vuminhquan28/FloodGuard/report/main.tex

\documentclass[12pt,a4paper]{report}

% --- Gói ngôn ngữ và mã hóa tiếng Việt ---
\usepackage[utf8]{inputenc}
\usepackage[vietnamese]{babel}
\usepackage[T5]{fontenc}

% --- Canh lề và định dạng trang ---
\usepackage[top=2.5cm, bottom=2.5cm, left=3cm, right=2cm]{geometry}
\usepackage{fancyhdr}
\setlength{\headheight}{15pt}
\usepackage{titlesec}

% --- Bảng, hình ảnh, toán học và ký hiệu ---
\usepackage{amsmath, amssymb}
\usepackage{graphicx}
\usepackage{booktabs}
\usepackage{tabularx}
\usepackage{longtable}
\usepackage{float}
\usepackage{caption}
\usepackage{subcaption}

% --- Định dạng code mã nguồn ---
\usepackage{listings}
\usepackage{xcolor}

\definecolor{codegreen}{rgb}{0.13,0.55,0.13}
\definecolor{codegray}{rgb}{0.5,0.5,0.5}
\definecolor{codepurple}{rgb}{0.58,0,0.82}
\definecolor{backcolour}{rgb}{0.96,0.97,0.98}

\lstdefinestyle{mystyle}{
    backgroundcolor=\color{backcolour},   
    commentstyle=\color{codegreen},
    keywordstyle=\color{blue}\bfseries,
    numberstyle=\tiny\color{codegray},
    stringstyle=\color{codepurple},
    basicstyle=\ttfamily\footnotesize,
    breakatwhitespace=false,         
    breaklines=true,                 
    captionpos=b,                    
    keepspaces=true,                 
    numbers=left,                    
    numbersep=5pt,                  
    showspaces=false,                
    showstringspaces=false,
    showtabs=false,                  
    tabsize=2
}
\lstset{style=mystyle}

% --- Liên kết và màu sắc tài liệu ---
\usepackage{hyperref}
\hypersetup{
    colorlinks=true,
    linkcolor=blue!70!black,
    filecolor=magenta,      
    urlcolor=cyan!70!black,
    citecolor=green!50!black,
    plainpages=false,
    pdfpagelabels=true,
    pdftitle={Báo cáo dự án IoT: FloodGuard - Hệ thống chống ngập tự động},
    pdfauthor={Vũ Minh Quân, Nguyễn Đức Huy, Phạm Đức Mạnh},
}

% --- Header và Footer ---
\pagestyle{fancy}
\fancyhf{}
\fancyhead[L]{\small\slshape FloodGuard - Hệ Thống Chống Ngập Tự Động}
\fancyhead[R]{\small\slshape ESP32 IoT Project}
\fancyfoot[C]{\thepage}
\renewcommand{\headrulewidth}{0.4pt}
\renewcommand{\footrulewidth}{0.4pt}

% ==================== BẮT ĐẦU TÀI LIỆU ====================
\begin{document}

\pagenumbering{alph}

% --- TRANG BÌA ---
% Khung viền đôi trang bìa chuẩn luận văn: Khung đậm dày ở ngoài và khung mỏng nhỏ hơn ở trong
\AddToHookNext{shipout/background}{%
    % Khung ngoài: Nét đậm dày (2.8pt)
    % Tọa độ chuẩn: Trái 25mm, Phải 15mm (Rộng 170mm), Trên 16mm, Dưới 16mm (Cao 265mm)
    \put(70.87,-48.15){\rule{481.89pt}{2.8pt}}% Cạnh trên ngoài
    \put(70.87,-796.54){\rule{481.89pt}{2.8pt}}% Cạnh dưới ngoài
    \put(70.87,-796.54){\rule{2.8pt}{751.18pt}}% Cạnh trái ngoài
    \put(549.96,-796.54){\rule{2.8pt}{751.18pt}}% Cạnh phải ngoài
    %
    % Khung trong: Nét thanh mỏng (0.9pt), lùi vào trong 2.5mm so với khung ngoài
    % Trái 27.5mm (Rộng 165mm), Trên 18.5mm (Cao 260mm)
    \put(77.95,-53.34){\rule{467.72pt}{0.9pt}}% Cạnh trên trong
    \put(77.95,-789.45){\rule{467.72pt}{0.9pt}}% Cạnh dưới trong
    \put(77.95,-789.45){\rule{0.9pt}{737.01pt}}% Cạnh trái trong
    \put(544.77,-789.45){\rule{0.9pt}{737.01pt}}% Cạnh phải trong
}
\begin{titlepage}
    \centering
    \vspace*{0.3cm}
    
    {\fontsize{15pt}{19pt}\selectfont\textbf{ĐẠI HỌC QUỐC GIA HÀ NỘI}\par}
    \vspace{0.15cm}
    {\fontsize{16pt}{20pt}\selectfont\textbf{TRƯỜNG ĐẠI HỌC CÔNG NGHỆ}\par}
    \vspace{0.4cm}
    \hrule height 1.5pt
    \vspace{0.8cm}
    
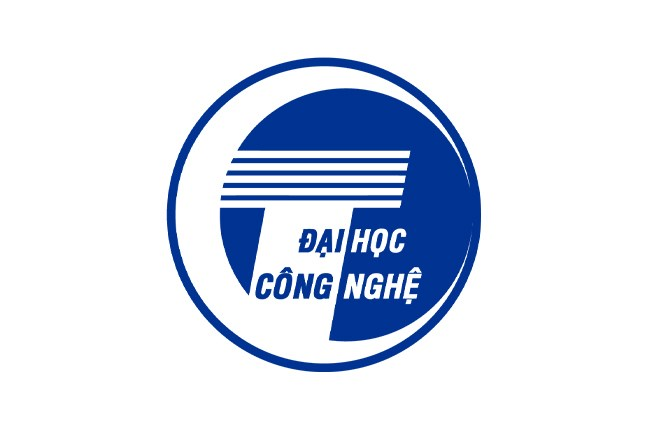
[picture p12: report/figures/logo-uet.jpg]
    \par
    \vspace{0.9cm}
    
    {\Large\textbf{BÁO CÁO BÀI TẬP LỚN}\par}
    \vspace{0.2cm}
    {\large\textbf{MÔN: LẬP TRÌNH NHÚNG VÀ THỜI GIAN THỰC}\par}
    \vspace{0.8cm}
    
    {\textbf{ĐỀ TÀI:}\par}
    \vspace{0.2cm}
    {\fontsize{13pt}{17pt}\selectfont\bfseries FLOODGUARD: HỆ THỐNG GIÁM SÁT VÀ CHỐNG NGẬP TỰ ĐỘNG THÔNG MINH\par}
    \vspace{0.3cm}
    {\small\slshape Ứng dụng Vi điều khiển ESP32, Thuật toán FSM \& Web Dashboard Thời Gian Thực\par}
    
    \vspace{1.4cm}
    
    \begin{minipage}{0.92\textwidth}
        \normalsize
        \renewcommand{\arraystretch}{1.35}
        \begin{tabular}{@{}ll@{}}
            \textbf{Học phần:}            & Lập trình nhúng và thời gian thực \\
            \textbf{Mã học phần:}         & 2627I\_INT3108\_1 \\
            \textbf{Sinh viên thực hiện:} & Vũ Minh Quân (23020142) \\
                                          & Nguyễn Đức Huy (24020161) \\
                                          & Phạm Đức Mạnh (24020222) \\
            \textbf{Học kỳ / Năm học:}    & Học kỳ 1 -- 2026-2027 \\
        \end{tabular}
    \end{minipage}
    
    \vfill
    {\large Hà Nội, Tháng 10 Năm 2026}\par
    \vspace*{0.3cm}
\end{titlepage}

% --- BẢNG PHÂN CHIA CÔNG VIỆC ---
\newpage
\pagenumbering{roman}
\setcounter{page}{1}
\addcontentsline{toc}{chapter}{Bảng Phân Chia Công Việc \& Tỷ Lệ Đóng Góp}

\begin{center}
    \vspace*{0.5cm}
    {\fontsize{14pt}{18pt}\selectfont\bfseries BẢNG PHÂN CHIA CÔNG VIỆC VÀ TỶ LỆ ĐÓNG GÓP}\par
    \vspace{0.8cm}
\end{center}

\noindent
Dự án \textbf{FloodGuard: Hệ thống giám sát và chống ngập tự động thông minh} được nghiên cứu và phát triển bởi nhóm gồm 03 sinh viên. Khối lượng công việc bao gồm thiết kế kiến trúc phần cứng, sơ đồ nguyên lý mạch điện, lập trình firmware vi điều khiển ESP32, xây dựng thuật toán điều khiển FSM, thiết kế giao diện Web Dashboard và biên soạn báo cáo kỹ thuật được phân chia đồng đều và bình đẳng giữa các thành viên:

\vspace{0.6cm}

\begin{center}
\renewcommand{\arraystretch}{1.5}
\begin{tabular}{|c|l|c|}
\hline
\textbf{STT} & \textbf{Tên sinh viên} & \textbf{Tỷ lệ đóng góp / Hoàn thành} \\ \hline
1 & Vũ Minh Quân (23020142) & 100\% \\ \hline
2 & Nguyễn Đức Huy (24020161) & 100\% \\ \hline
3 & Phạm Đức Mạnh (24020222) & 100\% \\ \hline
\multicolumn{2}{|c|}{\textbf{Đánh giá chung}} & \textbf{100\%} \\ \hline
\end{tabular}
\end{center}

\vspace{0.6cm}
\noindent
\textbf{Cam kết trách nhiệm:} Tất cả 03 thành viên trong nhóm đều tham gia chủ động, đóng góp bình đẳng và phối hợp chặt chẽ trong tất cả các giai đoạn triển khai đề tài, đảm bảo hoàn thành $100\%$ khối lượng công việc được giao với chất lượng cao nhất.

\vspace{1.8cm}
\begin{flushright}
    \textit{Hà Nội, ngày 25 tháng 10 năm 2026}\\[0.3cm]
    \textbf{Đại diện nhóm sinh viên thực hiện}\\[2.5cm]
    \textit{(Ký và ghi rõ họ tên)}\hspace{1.5cm}
\end{flushright}

\newpage

% --- MỤC LỤC ---
\tableofcontents
\newpage
\listoffigures
\listoftables
\newpage

% --- NỘI DUNG CHÍNH ---
\pagenumbering{arabic}

\input{chapters/01_introduction.tex}
\input{chapters/02_hardware_architecture.tex}
\input{chapters/03_algorithm_control.tex}
\input{chapters/04_web_dashboard.tex}
\input{chapters/05_deployment_guide.tex}
\input{chapters/06_conclusion.tex}

\end{document}
