vuminhquan28/FloodGuard/report/chapters/01_introduction.tex

\chapter{Giới Thiệu Đề Tài \& Phân Tích Yêu Cầu}
\label{ch:introduction}

\section{Đặt Vấn Đề \& Khảo Sát Hiện Trạng}

\subsection{Bối Cảnh Thực Tiễn Về Ngập Úng Đô Thị}
Hiện tượng ngập úng đô thị cục bộ vào mùa mưa bão đang là một trong những thách thức dân sinh và hạ tầng nghiêm trọng nhất tại các đô thị lớn ở Việt Nam, điển hình như Hà Nội và TP. Hồ Chí Minh. Các điểm trũng thấp như hầm chui dân sinh (hầm chui Đại lộ Thăng Long, Nguyễn Trãi), tầng hầm các tòa nhà chung cư, trung tâm thương mại và các tuyến phố trũng thấp thường xuyên bị ngập sâu từ $0.5\,\text{m}$ đến hơn $1.2\,\text{m}$ chỉ sau những trận mưa rào kéo dài $30 - 45\,\text{phút}$. Tình trạng này gây thiệt hại nặng nề về phương tiện giao thông, làm tê liệt hạ tầng đô thị, gây chập cháy thiết bị điện tử ngầm và tiềm ẩn nguy cơ đe dọa trực tiếp tính mạng con người.

\subsection{Khảo Sát \& Đánh Giá Các Giải Pháp Hiện Nay}
Để ứng phó với ngập úng đô thị, các giải pháp giám sát và tiêu thoát nước hiện nay chủ yếu bao gồm:
\begin{itemize}
    \item \textbf{Cơ chế phao cơ truyền thống:} Sử dụng phao quả nổi đóng ngắt tiếp điểm điện cơ khí. Giải pháp này có ưu điểm chi phí thấp, tuy nhiên chỉ cung cấp thông tin nhị phân (ngập / cạn), không đo lường được tốc độ dâng nước, rất dễ kẹt rác cơ học và hoàn toàn không có khả năng giám sát hay cảnh báo sớm từ xa.
    \item \textbf{Hệ thống SCADA / PLC công nghiệp:} Sử dụng các bộ điều khiển logic khả trình (PLC) kết hợp cảm biến radar công nghiệp và mạng truyền thông cáp quang. Mặc dù có độ tin cậy và độ bền công nghiệp rất cao, giải pháp này có chi phí đầu tư phần cứng và bản quyền phần mềm cực kỳ đắt đỏ (lên tới hàng trăm triệu đồng cho một điểm đo), kích thước cồng kềnh, tiêu thụ nhiều năng lượng và khó có thể phủ kín diện rộng tại hàng trăm điểm ngập nhỏ lẻ trong đô thị.
    \item \textbf{Hệ thống IoT nhúng dựa trên vi điều khiển:} Đây là hướng tiếp cận hiện đại và tối ưu về mặt kinh tế kỹ thuật. Bằng việc ứng dụng các vi điều khiển thế hệ mới như ESP32 tích hợp sẵn kết nối không dây, hệ thống có thể thu nhỏ kích thước, tiết kiệm năng lượng, đo đạc thông số liên tục theo thời gian thực và cung cấp giao diện giám sát tiện lợi với chi phí phần cứng rất thấp.
\end{itemize}

\subsection{Phạm Vi \& Quy Mô Nghiên Cứu Của Đề Tài}
Trong khuôn khổ học phần \textit{Lập trình nhúng và thời gian thực}, đề tài tập trung nghiên cứu, thiết kế và chế tạo một \textbf{mô hình thực nghiệm quy mô trạm quan trắc (Proof of Concept / Scale Model)} mang tên \textbf{FloodGuard}. Mô hình mô phỏng khép kín toàn bộ chu trình vận hành của một trạm bơm tiêu thoát lũ thông minh: từ khâu đo đạc mực nước và lượng mưa, tiền xử lý tín hiệu số, thuật toán điều khiển máy trạng thái hữu hạn (FSM) kết hợp dải trễ, điều khiển cơ cấu chấp hành (bơm, van), cảnh báo đa giác quan tại trạm (LED, còi), đến giao diện giám sát và can thiệp điều khiển qua mạng không dây cục bộ.

\section{Mục Tiêu Kỹ Thuật Định Lượng Của Dự Án}
\label{sec:quantitative_goals}
Hệ thống \textbf{FloodGuard} hướng tới các chỉ tiêu kỹ thuật định lượng cụ thể:
\begin{enumerate}
    \item \textbf{Độ chính xác đo lường mực nước:} Sai số tuyệt đối đo khoảng cách qua cảm biến siêu âm $\le \pm 1.0\,\text{cm}$ trong dải đo làm việc thiết kế ($5 - 50\,\text{cm}$ trên cấu hình mô phỏng/bể chuẩn và $6 - 16\,\text{cm}$ trên mô hình demo mica thu nhỏ); độ phân giải hiển thị mức nước $1\%$ ($0\% - 100\%$).
    \item \textbf{Độ phân giải giám sát lượng mưa:} Thu nhận tín hiệu tương tự (ADC) 12-bit phân giải $\approx 0.8\,\text{mV}$ trên dải $0 - 3.3\,\text{V}$, phân loại 4 vùng trạng thái thời tiết qua 3 mốc ngưỡng ($3200 / 1800 / 1100$): Khô ráo, Mưa nhỏ, Mưa to và Ngập cảm biến.
    \item \textbf{Tính thời gian thực của thuật toán điều khiển (Worst-Case Reaction Time - WCRT):} Thời gian phản ứng tức thời từ lúc mực nước vượt ngưỡng nguy cấp đến khi chân GPIO xuất tín hiệu đóng Relay máy bơm khẩn cấp ($T_{\text{WCRT\_urgent}}$) không vượt quá $250\,\text{ms}$ (tính toán danh định đạt $203\,\text{ms}$ ở chu kỳ trích mẫu $T_{\text{sample}} = 150\,\text{ms}$). Với các chuyển trạng thái bậc thang thông thường có áp dụng bộ lọc chống rung thời gian $T_{\text{debounce}} = 1.0\,\text{s}$, thời gian ổn định là $T_{\text{stable}} \approx 1.2\,\text{s}$.
    \item \textbf{Chống rung giật cơ cấu chấp hành (Hysteresis \& Debounce Guard):} Áp dụng dải trễ Hysteresis biên độ $3\%$ mực nước ($41\%/38\%$, $71\%/68\%$, $21\%/18\%$) kết hợp bộ lọc chống rung thời gian Debounce $1.0\,\text{s}$ và thời gian chạy tối thiểu của máy bơm $5.0\,\text{s}$ (Min-run Time), đảm bảo triệt tiêu hoàn toàn hiện tượng đóng/ngắt Relay liên tục (chattering) do sóng nước dập dềnh quanh biên ngưỡng.
    \item \textbf{Cảnh báo trực quan \& âm thanh đa cấp độ:} Cụm 3 đèn LED phản ánh trực tiếp 4 trạng thái vận hành; còi Active Buzzer $5\,\text{V}$ phát xung âm thanh theo cơ chế phi chặn (\textit{Non-blocking}) qua hàm \texttt{millis()} ở tần số cộng hưởng nội $\approx 2.3\,\text{kHz}$ với 4 nhịp cảnh báo: Tắt (NORMAL) $\to$ Bíp thưa chu kỳ $1500\,\text{ms}$ (WARNING) $\to$ Bíp dồn dập chu kỳ $400\,\text{ms}$ (DANGER) $\to$ Hú liên tục (CRITICAL).
    \item \textbf{Hiệu năng giao tiếp mạng Web Dashboard:} Chu kỳ cập nhật dữ liệu telemetry thời gian thực $1000\,\text{ms}$ ($1\,\text{s}$), độ trễ phản hồi API cục bộ $8 - 18\,\text{ms}$, tỷ lệ phục vụ thành công các yêu cầu API đạt $\ge 99.5\%$ trên mạng Wi-Fi cục bộ ở cự ly $10\,\text{m}$.
    \item \textbf{Cơ chế bảo vệ an toàn tự trị (Failsafe Timeout):} Khi ở chế độ thủ công (\texttt{MANUAL}), nếu mất kết nối điều khiển mạng quá $30\,\text{s}$, trạm tự động thu hồi quyền thủ công và chuyển về chế độ tự động (\texttt{AUTO}) để bảo vệ công trình chống tràn bể; đồng thời kích hoạt quy tắc ghi đè an toàn tối cao (\textit{Safety Override}) nếu nước đạt mức CRITICAL quá $10\,\text{s}$.
\end{enumerate}

\section{Mô Hình Hóa Use Case Hệ Thống Theo UML}

\subsection{Phân Định Ranh Giới Hệ Thống \& Danh Sách Tác Nhân}
Mô hình hóa Use Case cho hệ thống FloodGuard được phân định rõ ràng giữa ranh giới phần mềm/phần cứng hệ thống và các tác nhân tương tác từ môi trường bên ngoài:
\begin{itemize}
    \item \textbf{Ranh giới hệ thống (\textit{System Boundary}):} Mang tên \textbf{Hệ Thống Trạm FloodGuard} (\textit{FloodGuard System}). Ranh giới bao trọn toàn bộ khối phần mềm nhúng thực thi trên vi điều khiển ESP32 bao gồm: tác vụ thu thập cảm biến, thuật toán FSM, tác vụ tạo xung cảnh báo, máy chủ HTTP Web Server và cơ chế giám sát an toàn Failsafe. Các thành phần logic nội bộ (như bộ điều phối FSM hay Web Server) nằm hoàn toàn trong ranh giới và không đóng vai trò là tác nhân.
    \item \textbf{Tác nhân chính (\textit{Primary Actors}):}
    \begin{enumerate}
        \item \textbf{Bộ Định Thời Timer / Watchdog (\textit{Internal Timer}):} Đóng vai trò là nguồn kích hoạt sự kiện thời gian thực định kỳ từ bên ngoài luồng logic chính, bao gồm bộ định thời chu kỳ đọc cảm biến $150\,\text{ms}$, bộ định thời chu kỳ thực thi FSM, và bộ đếm thời gian giám sát mất kết nối Failsafe ($30\,\text{s}$).
        \item \textbf{Người Vận Hành (\textit{Human Operator}):} Nhân sự giám sát và vận hành tương tác trực tiếp với trạm từ thiết bị đầu cuối (điện thoại, máy tính) thông qua trình duyệt Web.
    \end{enumerate}
    \item \textbf{Tác nhân phụ / Thiết bị ngoại vi (\textit{Secondary Actors / Devices}):}
    \begin{enumerate}
        \item \textbf{\texttt{«device»} Cảm biến siêu âm HC-SR04 \& Cảm biến mưa FC-37:} Thiết bị đầu vào cung cấp tín hiệu xung thời gian phản hồi (Echo) và điện áp tương tự (AO) / mức logic (DO).
        \item \textbf{\texttt{«device»} Module Relay 5V \& Máy bơm mini:} Cơ cấu chấp hành động lực tiếp nhận tín hiệu kích mức logic để đóng/ngắt nguồn động cơ bơm.
        \item \textbf{\texttt{«device»} Động cơ Servo SG90:} Cơ cấu chấp hành cơ khí tiếp nhận tín hiệu điều chế độ rộng xung (PWM) để định vị góc mở cửa van xả lũ ($0^\circ, 90^\circ, 180^\circ$).
        \item \textbf{\texttt{«device»} Cụm 3 Đèn LED \& Còi Buzzer 5V:} Thiết bị chỉ thị tại chỗ tiếp nhận tín hiệu logic và xung nhịp cảnh báo.
        \item \textbf{Người Dân Quanh Trạm (\textit{Human Actor}):} Tác nhân thụ hưởng tiếp nhận tín hiệu âm thanh còi hú và ánh sáng đèn LED cảnh báo nguy hiểm tại thực địa trạm.
    \end{enumerate}
\end{itemize}

\subsection{Sơ Đồ Use Case Tổng Thể Hệ Thống \& Đặc Tả Kiến Trúc Mô Hình}
\label{sec:uc_overall}
Mô hình Use Case tổng thể của trạm FloodGuard được tổ chức khoa học nhằm phân định rõ ràng giữa ranh giới hệ thống phần mềm nhúng và môi trường tương tác bên ngoài. Sơ đồ phân tách thành hai phân hệ chức năng độc lập về mặt logic nhưng phối hợp đồng bộ thông qua bộ nhớ trạng thái chung (Hình~\ref{fig:uc_overall}):
\begin{enumerate}
    \item \textbf{Phân hệ Giám sát \& Điều khiển Tự động Tại Chỗ (\textit{Autonomous Core Subsystem}):} Bao gồm 6 ca sử dụng cốt lõi (từ \texttt{UC01} đến \texttt{UC06}). Phân hệ này chịu sự kích hoạt định kỳ từ \textbf{Bộ Định Thời Timer / Watchdog} và các tín hiệu vật lý từ \textbf{Cảm biến siêu âm, Cảm biến mưa}. Mọi tác vụ từ thu thập dữ liệu, đánh giá máy trạng thái hữu hạn (FSM), xử lý dải trễ Hysteresis, điều khiển cơ cấu chấp hành (bơm, van) và phát cảnh báo tại trạm (LED, còi) đều vận hành hoàn toàn tự trị theo thời gian thực ($150\,\text{ms}$), không phụ thuộc vào tình trạng kết nối mạng Wi-Fi.
    \item \textbf{Phân hệ Giám sát \& Điều khiển Từ Xa Qua Web (\textit{Remote Web Telemetry Subsystem}):} Bao gồm 4 ca sử dụng (từ \texttt{UC07} đến \texttt{UC10}). Phân hệ này chịu sự kích hoạt trực tiếp từ \textbf{Người Vận Hành} thông qua trình duyệt Web. Người dùng có thể giám sát dữ liệu đo thời gian thực, chuyển đổi linh hoạt giữa chế độ \texttt{AUTO} và \texttt{MANUAL}, đồng thời can thiệp cưỡng chế trạng thái bật/tắt máy bơm và góc mở van xả.
\end{enumerate}

Toàn bộ đường truyền liên kết giữa các tác nhân và ca sử dụng được quy hoạch theo dạng trục xương cá (\textit{Bus Spine Line}), loại bỏ hoàn toàn hiện tượng giao cắt chéo rối mắt, đảm bảo chuẩn mực trực quan cao nhất của ngôn ngữ UML.

\begin{figure}[H]
    \centering
    
    \caption{Sơ đồ Use Case tổng thể hệ thống FloodGuard chuẩn hóa theo phân hệ chức năng}
    \label{fig:uc_overall}
\end{figure}

Để cung cấp góc nhìn tổng quan toàn diện về kiến trúc chức năng, Bảng~\ref{tab:overall_uc_spec} đặc tả ma trận phân bổ 10 ca sử dụng, xác định rõ phân hệ phụ trách, tác nhân kích hoạt, tác nhân thụ hưởng và các cơ chế an toàn liên quan.

\begin{table}[H]
\centering
\caption{Bảng đặc tả kiến trúc Use Case tổng thể và ma trận phân bổ chức năng hệ thống}
\label{tab:overall_uc_spec}
\footnotesize
\renewcommand{\arraystretch}{1.12}
\begin{tabularx}{\textwidth}{|c|p{2.8cm}|p{2.6cm}|X|p{2.3cm}|}
\hline
\textbf{ID} & \textbf{Tên Use Case} & \textbf{Tác nhân kích hoạt} & \textbf{Tác nhân phụ / Ngoại vi \& Luồng thực thi} & \textbf{Ràng buộc an toàn} \\ \hline
\multicolumn{5}{|l|}{\textbf{I. PHÂN HỆ TỰ ĐỘNG TẠI CHỖ (AUTONOMOUS CORE)}} \\ \hline
\texttt{UC01} & Đọc \& tiền xử lý cảm biến & Timer chu kỳ $150\,\text{ms}$ & Cảm biến HC-SR04, FC-37; đo Echo, lọc trung vị 3 mẫu, đọc ADC mưa. & Giữ mẫu 3 chu kỳ ($450\,\text{ms}$); tràn bờ kích CRITICAL. \\ \hline
\texttt{UC02} & Tự động đánh giá FSM & Timer chu kỳ $150\,\text{ms}$ & Thuật toán FSM 4 trạng thái; đánh giá \% nước và mưa đón đầu lũ. & Hysteresis $3\%$, Debounce $1.0\,\text{s}$, Min-run $5\,\text{s}$. \\ \hline
\texttt{UC03} & Tự động điều khiển bơm & Timer chu kỳ FSM & Module Relay 5V, Bơm mini; Generalization (Bật / Ngắt bơm). & Bơm chỉ chạy khi nước $\ge 20\%$; ngắt an toàn khi sự cố. \\ \hline
\texttt{UC04} & Tự động điều khiển van & Timer chu kỳ FSM & Động cơ Servo SG90, Cửa van trượt; Generalization ($0^\circ$ / $90^\circ$ / $180^\circ$). & Vận tốc xoay mượt $15^\circ / 20\,\text{ms}$; góc an toàn $90^\circ$. \\ \hline
\texttt{UC05} & Phát cảnh báo tại trạm & Timer chu kỳ FSM & Cụm 3 LED, Còi Buzzer 5V, Người dân quanh trạm; băm xung phi chặn. & Duy trì cảnh báo liên tục ở cả AUTO và MANUAL. \\ \hline
\texttt{UC06} & Tự động chuyển Failsafe & Watchdog Timer ($30\,\text{s}$) & Người vận hành (nhận tin); giám sát khoảng cách gói tin Web. & Tự thu hồi MANUAL về AUTO khi mất mạng $> 30\,\text{s}$. \\ \hline
\multicolumn{5}{|l|}{\textbf{II. PHÂN HỆ GIÁM SÁT TỪ XA QUA WEB (REMOTE TELEMETRY)}} \\ \hline
\texttt{UC07} & Truyền nhận dữ liệu Web API & Người vận hành (Web) & Máy chủ ESP32; Generalization (\texttt{GET /api/status} và \texttt{GET /api/control}). & Tham số điều khiển tường minh; thời gian RTT $< 20\,\text{ms}$. \\ \hline
\texttt{UC08} & Giám sát qua Web Dashboard & Người vận hành (Web) & Trình duyệt Web; giao diện Glassmorphism render \% nước, thẻ động. & Polling định kỳ $1000\,\text{ms}$; tương thích chuẩn Responsive. \\ \hline
\texttt{UC09} & Chuyển đổi AUTO / MANUAL & Người vận hành (Web) & Giao diện Dashboard; Generalization (Chuyển sang AUTO / MANUAL). & Khóa/mở khóa nút can thiệp cưỡng chế tương ứng. \\ \hline
\texttt{UC10} & Can thiệp điều khiển thiết bị & Người vận hành (Web) & Relay Bơm, Servo; quan hệ «extend» (Bật/tắt bơm, xoay van tùy ý). & Tiền điều kiện MANUAL; Safety Override sau $10\,\text{s}$ nếu CRITICAL. \\ \hline
\end{tabularx}
\end{table}

\subsection{Sơ Đồ Phân Rã \& Đặc Tả Chi Tiết Từng Use Case}
\label{sec:uc_detailed}
Dưới đây là đặc tả chi tiết và sơ đồ phân rã theo chuẩn UML cho toàn bộ 10 ca sử dụng của hệ thống:

\subsubsection{UC01: Đọc và Tiền Xử Lý Dữ Liệu Cảm Biến}
Ca sử dụng \texttt{UC01} chịu trách nhiệm thu thập tín hiệu vật lý từ môi trường và chuyển hóa thành dữ liệu số có độ tin cậy cao phục vụ thuật toán điều khiển (Bảng~\ref{tab:spec_uc01}).

\begin{table}[H]
\centering
\caption{Bảng đặc tả chi tiết Use Case UC01: Đọc và tiền xử lý dữ liệu cảm biến}
\label{tab:spec_uc01}
\small
\renewcommand{\arraystretch}{1.2}
\begin{tabularx}{\textwidth}{|>{\bfseries}p{3.2cm}|X|}
\hline
Mã Use Case & \texttt{UC01} \\ \hline
Tên Use Case & Đọc và tiền xử lý dữ liệu cảm biến \\ \hline
Tác nhân chính & Bộ định thời chu kỳ lấy mẫu ($T_{\text{sample}} = 150\,\text{ms}$) \\ \hline
Tác nhân phụ & Cảm biến siêu âm HC-SR04, Cảm biến mưa FC-37 \\ \hline
Mục tiêu & Đo đạc chính xác khoảng cách mặt nước hồ thu, lọc sóng dập dềnh và phân cấp lượng mưa \\ \hline
Tiền điều kiện & Phần cứng vi điều khiển, mạch phân áp Echo ($5\,\text{V} \to 3.3\,\text{V}$) và cảm biến đã cấp nguồn ổn định \\ \hline
Hậu điều kiện & Cập nhật các biến toàn cục \texttt{waterPercent}, \texttt{waterDistanceCm}, \texttt{rainVal}, \texttt{isHeavyRain}, \texttt{isSubmerged} \\ \hline
Luồng sự kiện chính & 
1. Bộ định thời kích hoạt chu kỳ đo đạc $150\,\text{ms}$. \newline
2. Kích chân Trig với xung vuông mức HIGH $10\,\mu\text{s}$, đo thời gian phản xạ Echo qua \texttt{pulseIn()}. \newline
3. Thu thập 3 mẫu ToF liên tiếp (mỗi mẫu cách nhau $12\,\text{ms}$), áp dụng bộ lọc trung vị (\textit{Median-of-3}) loại bỏ nhiễu ngoại lai. \newline
4. Ánh xạ khoảng cách thực sang phần trăm mực nước $0\% - 100\%$ theo dải chuẩn $5 - 50\,\text{cm}$ (sa bàn mica: $6 - 16\,\text{cm}$). \newline
5. Đọc điện áp tương tự qua ADC 12-bit (GPIO 35) và chân số DO (GPIO 34) từ cảm biến mưa FC-37. \\ \hline
Luồng ngoại lệ & 
- \textbf{Mất tín hiệu Echo ($> 30\,\text{ms}$):} Áp dụng kỹ thuật giữ mẫu cũ (\textit{Sample-and-Hold}). Nếu lỗi kéo dài quá 3 chu kỳ liên tiếp ($> 450\,\text{ms}$), chuyển FSM sang \texttt{SENSOR\_FAULT}. \newline
- \textbf{Nước ngập tràn sát cảm biến ($< d_{\text{full}}$):} Nhận diện tràn bờ khẩn cấp, lập tức kích hoạt trạng thái \texttt{CRITICAL} (bật bơm và mở van $100\%$) thay vì báo lỗi cảm biến. \newline
- \textbf{Khoảng cách đo vượt đáy bể ($> d_{\text{empty}}$):} Kẹp cứng giá trị về $0\%$ để bảo vệ chống chạy khô máy bơm. \\ \hline
Ràng buộc phi chức năng & Thời gian thực thi toàn chu kỳ đo $\le 36\,\text{ms}$; sai số đo mực nước $\le \pm 0.5\,\text{cm}$. \\ \hline
\end{tabularx}
\end{table}

Sơ đồ phân rã của ca sử dụng \texttt{UC01} được minh họa trong Hình~\ref{fig:uc01}. Trong mỗi chu kỳ, ca sử dụng luôn bao hàm ba tác vụ con thông qua quan hệ \texttt{«include»}: đo khoảng cách siêu âm, lọc trung vị 3 mẫu và phân cấp ngưỡng mưa ADC.

\begin{figure}[H]
    \centering
    
    \caption{Sơ đồ phân rã Use Case UC01: Đọc và tiền xử lý dữ liệu cảm biến}
    \label{fig:uc01}
\end{figure}

\subsubsection{UC02: Tự Động Đánh Giá Trạng Thái FSM \& Xử Lý Dải Trễ (Hysteresis)}
Ca sử dụng \texttt{UC02} là bộ não điều phối của hệ thống, thực thi thuật toán máy trạng thái hữu hạn để chuyển cấp cảnh báo dựa trên mực nước và tình trạng mưa lũ (Bảng~\ref{tab:spec_uc02}).

\begin{table}[H]
\centering
\caption{Bảng đặc tả chi tiết Use Case UC02: Tự động đánh giá FSM \& Xử lý dải trễ}
\label{tab:spec_uc02}
\small
\renewcommand{\arraystretch}{1.2}
\begin{tabularx}{\textwidth}{|>{\bfseries}p{3.2cm}|X|}
\hline
Mã Use Case & \texttt{UC02} \\ \hline
Tên Use Case & Tự động đánh giá trạng thái FSM \& Xử lý dải trễ (Hysteresis) \\ \hline
Tác nhân chính & Bộ định thời chu kỳ logic FSM ($T_{\text{fsm}} = 150\,\text{ms}$) \\ \hline
Tác nhân phụ & Không có (thực thi logic nội bộ) \\ \hline
Mục tiêu & Đánh giá phân cấp nguy cơ ngập lụt qua 4 trạng thái, triệt tiêu hiện tượng rung giật đóng ngắt cơ cấu chấp hành \\ \hline
Tiền điều kiện & Biến \texttt{waterPercent} và trạng thái cảm biến mưa đã được cập nhật bởi \texttt{UC01} \\ \hline
Hậu điều kiện & Biến trạng thái hệ thống \texttt{sysState} được cập nhật, sẵn sàng kích hoạt các phân hệ chấp hành \\ \hline
Luồng sự kiện chính & 
1. Đối chiếu \% mực nước với các cặp ngưỡng vào/thoát: $21\%/18\%$ (WARNING), $41\%/38\%$ (DANGER), và $71\%/68\%$ (CRITICAL). \newline
2. Áp dụng dải trễ biên độ $\Delta = 3\%$ kết hợp bộ lọc thời gian duy trì $T_{\text{debounce}} = 1.0\,\text{s}$ trước khi quyết định đổi trạng thái. \newline
3. Tích hợp dữ liệu lượng mưa đóng vai trò nâng cấp đón đầu lũ (\textit{Surge Anticipation}): khi có mưa to ($\text{ADC} < 1800$) hoặc ngập cảm biến ($\text{ADC} < 1100$), chủ động đẩy trạng thái lên DANGER hoặc CRITICAL. \\ \hline
Luồng ngoại lệ & 
- Nếu cờ lỗi \texttt{sensorFault == true}, FSM chuyển ngay sang trạng thái an toàn \texttt{SENSOR\_FAULT}. \newline
- Phục hồi về vận hành tự động bình thường khi nhận lại $\ge 5$ mẫu đo ToF hợp lệ liên tiếp. \\ \hline
Ràng buộc an toàn & Máy bơm chỉ được phép bật khi mực nước $\ge 20\%$ để chống hiện tượng cháy bơm do chạy khô; thời gian chạy tối thiểu của bơm $T_{\text{min\_run}} \ge 5.0\,\text{s}$. \\ \hline
\end{tabularx}
\end{table}

Sơ đồ phân rã của \texttt{UC02} thể hiện qua quan hệ bao gồm (\texttt{«include»}) giữa tác vụ đánh giá 4 trạng thái FSM và cơ chế dải trễ Hysteresis chống rung (Hình~\ref{fig:uc02}).

\begin{figure}[H]
    \centering
    
    \caption{Sơ đồ phân rã Use Case UC02: Tự động đánh giá FSM \& Dải trễ}
    \label{fig:uc02}
\end{figure}

\subsubsection{UC03: Tự Động Điều Khiển Máy Bơm Thoát Nước}
Ca sử dụng \texttt{UC03} quản lý việc đóng/ngắt nguồn động lực máy bơm mini $5\,\text{V}$ qua tiếp điểm Relay dựa trên trạng thái FSM (Bảng~\ref{tab:spec_uc03}).

\begin{table}[H]
\centering
\caption{Bảng đặc tả chi tiết Use Case UC03: Tự động điều khiển máy bơm thoát nước}
\label{tab:spec_uc03}
\small
\renewcommand{\arraystretch}{1.2}
\begin{tabularx}{\textwidth}{|>{\bfseries}p{3.2cm}|X|}
\hline
Mã Use Case & \texttt{UC03} \\ \hline
Tên Use Case & Tự động điều khiển máy bơm thoát nước \\ \hline
Tác nhân chính & Bộ định thời chu kỳ FSM \\ \hline
Tác nhân phụ & Module Relay 5V (Active LOW), Máy bơm nước mini 5V \\ \hline
Mục tiêu & Đóng ngắt máy bơm an toàn, bơm cưỡng bức thoát nước khi ngập lụt, chống quá nhiệt tiếp điểm \\ \hline
Tiền điều kiện & Chế độ vận hành tự động (\texttt{isAutoMode == true}) \\ \hline
Hậu điều kiện & Máy bơm được bật (Relay kích LOW) hoặc ngắt (Relay thả nổi High-Z) \\ \hline
Luồng sự kiện chính & 
Phân nhánh chuyên biệt hóa (Generalization) kế thừa từ \texttt{UC03}: \newline
-- \textbf{Nhánh 1 (Kích Bật Bơm):} Khi FSM đạt mức DANGER hoặc CRITICAL (và nước $\ge 20\%$), vi điều khiển cấu hình chân GPIO 23 sang \texttt{OUTPUT} và xuất mức logic \texttt{LOW} ($0\,\text{V}$) để kích dẫn optocoupler, đóng tiếp điểm Relay cấp điện cho máy bơm. \newline
-- \textbf{Nhánh 2 (Ngắt Bơm An Toàn):} Khi FSM ở mức NORMAL hoặc WARNING, vi điều khiển cấu hình chân GPIO 23 sang chế độ \texttt{INPUT} (thả nổi High-Impedance) để triệt tiêu hoàn toàn dòng rò quang học qua optocoupler, bảo đảm tiếp điểm Relay nhả dứt khoát. \\ \hline
Luồng ngoại lệ & Khi có lỗi cảm biến \texttt{SENSOR\_FAULT}, máy bơm lập tức bị ngắt cưỡng bức để bảo vệ chống chạy khô. \\ \hline
Ràng buộc cơ học & Bộ đếm thời gian kiểm tra thời gian hoạt động liên tục: nếu bơm vừa bật, không được ngắt trước khi đạt $T_{\text{min\_run}} \ge 5.0\,\text{s}$. \\ \hline
\end{tabularx}
\end{table}

Sơ đồ phân rã ca sử dụng \texttt{UC03} thể hiện cấu trúc chuyên biệt hóa (Hình~\ref{fig:uc03}).

\begin{figure}[H]
    \centering
    
    \caption{Sơ đồ phân rã Use Case UC03: Tự động điều khiển máy bơm thoát nước}
    \label{fig:uc03}
\end{figure}

\subsubsection{UC04: Tự Động Điều Khiển Van Thoát Lũ}
Ca sử dụng \texttt{UC04} điều khiển góc xoay của động cơ Servo SG90 để đóng/mở cửa xả lũ theo 3 cấp độ tỷ lệ (Bảng~\ref{tab:spec_uc04}).

\begin{table}[H]
\centering
\caption{Bảng đặc tả chi tiết Use Case UC04: Tự động điều khiển van thoát lũ}
\label{tab:spec_uc04}
\small
\renewcommand{\arraystretch}{1.2}
\begin{tabularx}{\textwidth}{|>{\bfseries}p{3.2cm}|X|}
\hline
Mã Use Case & \texttt{UC04} \\ \hline
Tên Use Case & Tự động điều khiển van thoát lũ \\ \hline
Tác nhân chính & Bộ định thời chu kỳ FSM \\ \hline
Tác nhân phụ & Động cơ Servo SG90 (GPIO 13), Cửa van trượt xả lũ \\ \hline
Mục tiêu & Điều tiết lưu lượng xả lũ tự nhiên theo từng cấp độ nguy cơ ngập lụt \\ \hline
Tiền điều kiện & Chế độ vận hành tự động (\texttt{isAutoMode == true}); nguồn xung cấp cho Servo ổn định \\ \hline
Hậu điều kiện & Cửa van di chuyển đến góc mở tương ứng với trạng thái FSM \\ \hline
Luồng sự kiện chính & 
Phân nhánh chuyên biệt hóa 3 trạng thái góc mở: \newline
-- \textbf{Đóng van $0^\circ$ ($0\%$):} Áp dụng khi hệ thống ở mức NORMAL hoặc WARNING (mực nước an toàn, giữ nước hồ chứa). \newline
-- \textbf{Mở van $50\%$ (Góc $90^\circ$):} Áp dụng khi FSM ở mức DANGER để bắt đầu điều tiết thoát lũ lưu lượng vừa. \newline
-- \textbf{Mở van $100\%$ (Góc $180^\circ$):} Áp dụng khi FSM ở mức CRITICAL để giải phóng áp lực nước tối đa qua cống. \\ \hline
Luồng ngoại lệ & Khi rơi vào sự cố \texttt{SENSOR\_FAULT}, cửa van tự động định vị ở góc mở an toàn $50\%$ ($90^\circ$) để phòng ngừa dâng tràn thụ động. \\ \hline
Ràng buộc kỹ thuật & Xung điều chế độ rộng PWM tần số $50\,\text{Hz}$; góc xoay biến thiên với vận tốc mượt $15^\circ / 20\,\text{ms}$ tránh hiện tượng giật cơ khí và sụt áp nguồn. \\ \hline
\end{tabularx}
\end{table}

Sơ đồ phân rã Use Case \texttt{UC04} được thể hiện trong Hình~\ref{fig:uc04}.

\begin{figure}[H]
    \centering
    
    \caption{Sơ đồ phân rã Use Case UC04: Tự động điều khiển van thoát lũ}
    \label{fig:uc04}
\end{figure}

\subsubsection{UC05: Phát Tín Hiệu Cảnh Báo Tại Trạm (LED \& Còi Buzzer)}
Ca sử dụng \texttt{UC05} phát tín hiệu quang học và âm thanh cảnh báo tại chỗ cho người dân và kỹ thuật viên tại trạm (Bảng~\ref{tab:spec_uc05}).

\begin{table}[H]
\centering
\caption{Bảng đặc tả chi tiết Use Case UC05: Phát tín hiệu cảnh báo tại trạm}
\label{tab:spec_uc05}
\small
\renewcommand{\arraystretch}{1.2}
\begin{tabularx}{\textwidth}{|>{\bfseries}p{3.2cm}|X|}
\hline
Mã Use Case & \texttt{UC05} \\ \hline
Tên Use Case & Phát tín hiệu cảnh báo tại trạm (LED \& Còi Buzzer) \\ \hline
Tác nhân chính & Bộ định thời chu kỳ FSM \\ \hline
Tác nhân phụ & Cụm 3 đèn LED màu (Xanh, Vàng, Đỏ), Còi Active Buzzer 5V, Người dân quanh trạm \\ \hline
Mục tiêu & Cung cấp tín hiệu cảnh báo đa giác quan rõ nét, kịp thời, không chiếm dụng CPU \\ \hline
Tiền điều kiện & Chân GPIO điều khiển LED (21, 19, 18) và Buzzer (4) đã được cấu hình \texttt{OUTPUT} \\ \hline
Hậu điều kiện & Đèn LED sáng đúng màu quy định; còi phát xung âm thanh theo nhịp tương ứng \\ \hline
Luồng sự kiện chính & 
1. \textbf{Chỉ thị LED quang học:} \newline
   -- NORMAL: Bật LED Xanh (GPIO 21), tắt LED Vàng và Đỏ. \newline
   -- WARNING: Bật LED Vàng (GPIO 19), tắt LED Xanh và Đỏ. \newline
   -- DANGER: Bật LED Đỏ (GPIO 18), tắt LED Xanh và Vàng. \newline
   -- CRITICAL: Nhấp nháy LED Đỏ chu kỳ nhanh $100\,\text{ms}$. \newline
2. \textbf{Kích âm còi báo động phi chặn (\textit{Non-blocking Buzzer}):} \newline
   -- NORMAL: Tắt còi hoàn toàn ($0\,\text{V}$). \newline
   -- WARNING: Bíp thưa nhịp $1500\,\text{ms}$ ($120\,\text{ms}$ ON / $1380\,\text{ms}$ OFF). \newline
   -- DANGER: Bíp dồn dập chu kỳ $400\,\text{ms}$ ($150\,\text{ms}$ ON / $250\,\text{ms}$ OFF). \newline
   -- CRITICAL: Hú liên tục tại tần số cộng hưởng nội $\approx 2.3\,\text{kHz}$ của Active Buzzer. \\ \hline
Luồng ngoại lệ & Khi có lỗi \texttt{SENSOR\_FAULT}, cả 3 đèn LED nhấp nháy đồng thời và còi bíp ngắt quãng báo sự cố kỹ thuật. \\ \hline
Ràng buộc an toàn & Khối cảnh báo thực địa (LED và còi) \textbf{luôn duy trì liên tục ở cả hai chế độ AUTO và MANUAL} dựa theo mực nước thực tế để bảo vệ an toàn cho người dân quanh trạm. \\ \hline
\end{tabularx}
\end{table}

Sơ đồ phân rã ca sử dụng \texttt{UC05} được trình bày trong Hình~\ref{fig:uc05}.

\begin{figure}[H]
    \centering
    
    \caption{Sơ đồ phân rã Use Case UC05: Phát tín hiệu cảnh báo tại trạm}
    \label{fig:uc05}
\end{figure}

\subsubsection{UC06: Tự Động Chuyển Đổi An Toàn Khi Mất Kết Nối Mạng (Failsafe)}
Ca sử dụng \texttt{UC06} đảm bảo tính tự trị an toàn cao nhất, ngăn ngừa sự cố bỏ quên hệ thống ở chế độ thủ công (Bảng~\ref{tab:spec_uc06}).

\begin{table}[H]
\centering
\caption{Bảng đặc tả chi tiết Use Case UC06: Tự động chuyển an toàn khi mất mạng (Failsafe)}
\label{tab:spec_uc06}
\small
\renewcommand{\arraystretch}{1.2}
\begin{tabularx}{\textwidth}{|>{\bfseries}p{3.2cm}|X|}
\hline
Mã Use Case & \texttt{UC06} \\ \hline
Tên Use Case & Tự động chuyển đổi an toàn khi mất kết nối mạng (Network Failsafe) \\ \hline
Tác nhân chính & Bộ giám sát thời gian kết nối Heartbeat Watchdog \\ \hline
Tác nhân phụ & Người vận hành (nhận thông báo cảnh báo khi tái lập kết nối) \\ \hline
Mục tiêu & Tự động thu hồi quyền thủ công và hoàn nguyên trạm về chế độ tự động an toàn khi xảy ra mất kết nối Web \\ \hline
Tiền điều kiện & Hệ thống đang vận hành ở chế độ thủ công (\texttt{isAutoMode == false}) \\ \hline
Hậu điều kiện & Hệ thống chuyển về \texttt{isAutoMode = true}, quyền điều khiển được trao trả hoàn toàn cho FSM \\ \hline
Luồng sự kiện chính & 
1. Hệ thống đếm thời gian trôi qua kể từ gói tin HTTP request gần nhất nhận được từ Dashboard: $\Delta t = \text{millis}() - \text{lastClientRequestTime}$. \newline
2. Nếu $\Delta t > 30000\,\text{ms}$ ($30\,\text{s}$), bộ giám sát kích hoạt ngắt sự kiện Failsafe Timeout. \newline
3. Tự động thiết lập \texttt{isAutoMode = true}, ghi log sự cố và bật cờ thông báo \texttt{failsafeTriggered = true}. \newline
4. Khi trình duyệt Web kết nối lại và gửi yêu cầu, giao diện hiển thị cảnh báo đỏ nổi bật về việc hệ thống đã tự động chuyển đổi an toàn. \\ \hline
Phục hồi quyền & Người vận hành phải chủ động nhấp nút xác nhận trên giao diện Web Dashboard mới có thể tiếp quản lại quyền điều khiển thủ công. \\ \hline
Ràng buộc kỹ thuật & Bộ đếm thời gian thực hiện phi chặn, độc lập với luồng Web Server và vòng lặp FSM. \\ \hline
\end{tabularx}
\end{table}

Sơ đồ phân rã Use Case \texttt{UC06} được mô tả trong Hình~\ref{fig:uc06}.

\begin{figure}[H]
    \centering
    
    \caption{Sơ đồ phân rã Use Case UC06: Tự động chuyển an toàn khi mất mạng (Failsafe)}
    \label{fig:uc06}
\end{figure}

\subsubsection{UC07: Truyền Nhận Dữ Liệu Qua Giao Thức Web API}
Ca sử dụng \texttt{UC07} xây dựng tầng giao tiếp truyền thông REST API giữa máy chủ Web Server nhúng trên vi điều khiển ESP32 và máy khách (Bảng~\ref{tab:spec_uc07}).

\begin{table}[H]
\centering
\caption{Bảng đặc tả chi tiết Use Case UC07: Truyền nhận dữ liệu qua Web API}
\label{tab:spec_uc07}
\small
\renewcommand{\arraystretch}{1.2}
\begin{tabularx}{\textwidth}{|>{\bfseries}p{3.2cm}|X|}
\hline
Mã Use Case & \texttt{UC07} \\ \hline
Tên Use Case & Truyền nhận dữ liệu qua giao thức Web API \\ \hline
Tác nhân chính & Người vận hành (thông qua trình duyệt Web) \\ \hline
Tác nhân phụ & Máy chủ Web Server nhúng trên ESP32 \\ \hline
Mục tiêu & Cung cấp cổng truyền nhận dữ liệu telemetry và tiếp nhận lệnh can thiệp thời gian thực chuẩn JSON \\ \hline
Tiền điều kiện & Máy khách đã kết nối vào mạng Wi-Fi SoftAP \texttt{FloodGuard\_AP} thành công \\ \hline
Hậu điều kiện & Trả về dữ liệu telemetry hoặc cập nhật tham số điều khiển vi điều khiển \\ \hline
Luồng sự kiện chính & 
Phân nhánh chuyên biệt hóa 2 endpoint API độc lập: \newline
-- \textbf{Yêu cầu dữ liệu trạng thái (\texttt{GET /api/status}):} Trình duyệt gửi request polling định kỳ $1000\,\text{ms}$; vi điều khiển thu thập thông số tức thời, đóng gói chuỗi JSON ($\approx 210\,\text{bytes}$ chứa \% nước, khoảng cách cm, cấp độ mưa, trạng thái bơm, van, còi, chế độ AUTO/MANUAL) và phản hồi HTTP 200. \newline
-- \textbf{Tiếp nhận lệnh điều khiển (\texttt{GET /api/control}):} Trình duyệt gửi lệnh chứa tham số tường minh (\texttt{mode=auto/manual}, \texttt{pump=1/0/toggle}, \texttt{valve=0/50/100}); vi điều khiển bóc tách cú pháp và thực thi cập nhật phần cứng. \\ \hline
Ràng buộc hiệu năng & Kích thước gói tin JSON nhỏ gọn; thời gian trễ phản hồi RTT khứ hồi $< 20\,\text{ms}$ trong phạm vi $15\,\text{m}$. \\ \hline
\end{tabularx}
\end{table}

Sơ đồ phân rã Use Case \texttt{UC07} được minh họa trong Hình~\ref{fig:uc07}.

\begin{figure}[H]
    \centering
    
    \caption{Sơ đồ phân rã Use Case UC07: Truyền nhận dữ liệu qua Web API}
    \label{fig:uc07}
\end{figure}

\subsubsection{UC08: Giám Sát Trạng Thái Trạm Qua Web Dashboard}
Ca sử dụng \texttt{UC08} trực quan hóa dữ liệu telemetry lên giao diện Web đồ họa hiện đại (Bảng~\ref{tab:spec_uc08}).

\begin{table}[H]
\centering
\caption{Bảng đặc tả chi tiết Use Case UC08: Giám sát trạng thái trạm qua Web Dashboard}
\label{tab:spec_uc08}
\small
\renewcommand{\arraystretch}{1.2}
\begin{tabularx}{\textwidth}{|>{\bfseries}p{3.2cm}|X|}
\hline
Mã Use Case & \texttt{UC08} \\ \hline
Tên Use Case & Giám sát trạng thái trạm qua Web Dashboard \\ \hline
Tác nhân chính & Người vận hành \\ \hline
Tác nhân phụ & Trình duyệt Web (Chrome, Safari, Firefox...) \\ \hline
Mục tiêu & Hiển thị trực quan, sinh động toàn bộ tham số vận hành của trạm theo thời gian thực \\ \hline
Tiền điều kiện & Người vận hành truy cập địa chỉ \url{http://192.168.4.1} hoặc \url{http://floodguard.local} \\ \hline
Hậu điều kiện & Giao diện Dashboard được render đầy đủ và cập nhật liên tục mỗi giây \\ \hline
Luồng sự kiện chính & 
1. Trình duyệt tải mã nguồn giao diện Dark Glassmorphism lưu trữ trong bộ nhớ Flash PROGMEM ($\approx 14.2\,\text{KB}$). \newline
2. Khởi tạo vòng lặp AJAX Fetch tự động gửi yêu cầu \texttt{GET /api/status} mỗi $1000\,\text{ms}$. \newline
3. Cập nhật đồ họa thanh tiến trình mực nước dải $0 - 100\%$ kèm màu sắc chuyển đổi linh hoạt (Xanh $\to$ Vàng $\to$ Đỏ). \newline
4. Hiển thị thẻ thông tin khoảng cách siêu âm (cm) và cấp độ mưa thực tế (Không mưa / Mưa nhỏ / Mưa to / Ngập cảm biến). \newline
5. Hiển thị huy hiệu trạng thái FSM hiện tại, chỉ báo trạng thái bật/tắt máy bơm, góc mở van xả lũ và còi báo động. \\ \hline
Ràng buộc giao diện & Tương thích chuẩn Responsive Web Design trên cả máy tính xách tay và điện thoại thông minh. \\ \hline
\end{tabularx}
\end{table}

Sơ đồ phân rã Use Case \texttt{UC08} được trình bày trong Hình~\ref{fig:uc08}.

\begin{figure}[H]
    \centering
    
    \caption{Sơ đồ phân rã Use Case UC08: Giám sát trạng thái trạm qua Web Dashboard}
    \label{fig:uc08}
\end{figure}

\subsubsection{UC09: Chuyển Đổi Chế Độ Vận Hành (AUTO / MANUAL)}
Ca sử dụng \texttt{UC09} quản lý việc chuyển giao quyền điều hành hệ thống giữa thuật toán FSM tự động và người vận hành (Bảng~\ref{tab:spec_uc09}).

\begin{table}[H]
\centering
\caption{Bảng đặc tả chi tiết Use Case UC09: Chuyển đổi chế độ vận hành}
\label{tab:spec_uc09}
\small
\renewcommand{\arraystretch}{1.2}
\begin{tabularx}{\textwidth}{|>{\bfseries}p{3.2cm}|X|}
\hline
Mã Use Case & \texttt{UC09} \\ \hline
Tên Use Case & Chuyển đổi chế độ vận hành (AUTO / MANUAL) \\ \hline
Tác nhân chính & Người vận hành \\ \hline
Tác nhân phụ & Giao diện Web Dashboard, Vi điều khiển ESP32 \\ \hline
Mục tiêu & Cho phép chuyển đổi linh hoạt và an toàn giữa chế độ tự động hoàn toàn và chế độ can thiệp thủ công \\ \hline
Tiền điều kiện & Người vận hành đang mở trang Web Dashboard có kết nối ổn định \\ \hline
Hậu điều kiện & Biến \texttt{isAutoMode} được cập nhật trên vi điều khiển; giao diện thay đổi trạng thái nút bấm \\ \hline
Luồng sự kiện chính & 
Phân nhánh chuyên biệt hóa hai trạng thái chế độ: \newline
-- \textbf{Chuyển sang chế độ AUTO:} Người vận hành gạt nút chuyển về AUTO; gửi lệnh \texttt{GET /api/control?mode=auto}. Hệ thống khóa toàn bộ các nút can thiệp cưỡng chế trên Dashboard, trao toàn quyền quyết định phần cứng cho thuật toán FSM. \newline
-- \textbf{Chuyển sang chế độ MANUAL:} Người vận hành gạt nút chuyển sang MANUAL; gửi lệnh \texttt{GET /api/control?mode=manual}. Hệ thống mở khóa các nút bật/tắt bơm và chọn góc mở van, đồng thời bắt đầu kích hoạt bộ đếm thời gian giám sát Failsafe $30\,\text{s}$. \\ \hline
Ràng buộc an toàn & Khi chuyển từ MANUAL về AUTO, hệ thống lập tức tái đánh giá mực nước và đưa cơ cấu chấp hành về đúng trạng thái FSM tương ứng. \\ \hline
\end{tabularx}
\end{table}

Sơ đồ phân rã Use Case \texttt{UC09} được thể hiện trong Hình~\ref{fig:uc09}.

\begin{figure}[H]
    \centering
    
    \caption{Sơ đồ phân rã Use Case UC09: Chuyển đổi chế độ vận hành}
    \label{fig:uc09}
\end{figure}

\subsubsection{UC10: Can Thiệp Điều Khiển Thiết Bị Chấp Hành Từ Web}
Ca sử dụng \texttt{UC10} cho phép người vận hành cưỡng chế vận hành máy bơm và cửa van xả lũ trong chế độ thủ công (Bảng~\ref{tab:spec_uc10}).

\begin{table}[H]
\centering
\caption{Bảng đặc tả chi tiết Use Case UC10: Can thiệp điều khiển thiết bị từ Web}
\label{tab:spec_uc10}
\small
\renewcommand{\arraystretch}{1.2}
\begin{tabularx}{\textwidth}{|>{\bfseries}p{3.2cm}|X|}
\hline
Mã Use Case & \texttt{UC10} \\ \hline
Tên Use Case & Can thiệp điều khiển thiết bị chấp hành từ Web \\ \hline
Tác nhân chính & Người vận hành \\ \hline
Tác nhân phụ & Module Relay 5V, Máy bơm mini, Động cơ Servo SG90 \\ \hline
Mục tiêu & Cưỡng chế bật/tắt bơm và điều chỉnh góc mở cửa van xả lũ phục vụ bảo trì hoặc xử lý tình huống khẩn cấp \\ \hline
Tiền điều kiện & Hệ thống đang ở chế độ thủ công (\texttt{isAutoMode == false}) \\ \hline
Hậu điều kiện & Trạng thái máy bơm hoặc góc mở cửa van thay đổi theo đúng lệnh của người vận hành \\ \hline
Luồng sự kiện chính & 
Bao gồm hai hành vi mở rộng (\texttt{«extend»}) tác động trực tiếp tới cơ cấu chấp hành: \newline
-- \textbf{Bật / Tắt cưỡng chế máy bơm:} Người vận hành nhấp nút Bật/Tắt trên Dashboard, gửi lệnh \texttt{GET /api/control?pump=1} (hoặc \texttt{pump=0}). Vi điều khiển lập tức kích dẫn hoặc ngắt Relay máy bơm. \newline
-- \textbf{Điều khiển cưỡng chế góc van xả:} Người vận hành nhấp chọn góc $0^\circ / 90^\circ / 180^\circ$, gửi lệnh \texttt{GET /api/control?valve=90}. Vi điều khiển xuất xung PWM tương ứng tới động cơ Servo kéo cửa xả. \\ \hline
Luồng ngoại lệ (Safety Override) & 
\textbf{Cơ chế bảo vệ tối cao (Emergency Safety Override):} \newline
Nếu trạm đang ở chế độ MANUAL và mực nước thực tế dâng chạm ngưỡng nguy cấp CRITICAL ($\ge 71\%$), nếu sau $10\,\text{s}$ người vận hành không can thiệp (hoặc vẫn tắt bơm/đóng van), hệ thống tự động kích hoạt ghi đè khẩn cấp: hủy bỏ MANUAL, cưỡng chế chuyển về AUTO, bật bơm công suất tối đa và mở van $100\%$ ($180^\circ$) để chống vỡ đê/tràn bể. \\ \hline
Ràng buộc an toàn & Mọi lệnh can thiệp thành công đều làm tươi lại bộ đếm Heartbeat Failsafe ($30\,\text{s}$). \\ \hline
\end{tabularx}
\end{table}

Sơ đồ phân rã Use Case \texttt{UC10} được thể hiện trong Hình~\ref{fig:uc10}.

\begin{figure}[H]
    \centering
    
    \caption{Sơ đồ phân rã Use Case UC10: Can thiệp điều khiển thiết bị từ Web}
    \label{fig:uc10}
\end{figure}

\section{Yêu Cầu Phi Chức Năng \& Ràng Buộc Thời Gian Thực}

\subsection{Đặc Tính \& Ràng Buộc Thời Gian Thực (Real-Time Constraints)}
Trong kỹ thuật lập trình hệ thống nhúng, FloodGuard được thiết kế theo mô hình hệ thống thời gian thực mềm (\textit{Soft Real-Time}) kết hợp với một số ràng buộc an toàn cứng (\textit{Firm Safety Constraints}):
\begin{itemize}
    \item \textbf{Chu kỳ trích mẫu cảm biến ($T_{\text{sample}} = 150\,\text{ms}$):} Vi điều khiển kích hoạt chu kỳ lấy mẫu định kỳ $150\,\text{ms}$. Trong các ứng dụng đo sâu công nghiệp, khoảng nghỉ khuyến cáo giữa các lần phát siêu âm thường $\ge 60\,\text{ms}$ để sóng dội tắt hẳn; tuy nhiên với mô hình sa bàn bể nông ($5 - 50\,\text{cm}$ hoặc mica $6 - 16\,\text{cm}$), hành trình khứ hồi của sóng âm chỉ mất dưới $3\,\text{ms}$, do đó việc đo 3 mẫu cách nhau $12\,\text{ms}$ trong chu kỳ quét $150\,\text{ms}$ hoàn toàn đảm bảo sóng âm tắt hẳn mà vẫn duy trì tính thời gian thực cao.
    \item \textbf{Bộ lọc cửa sổ trượt trung vị 3 mẫu (Median Filter):} Ba mẫu đo liên tiếp được lưu trong bộ đệm trượt để lọc bỏ các giá trị dị biệt (outliers) sinh ra do bọt khí, rung chấn cơ học hoặc bề mặt nước dập dềnh.
    \item \textbf{Thời gian phản ứng tối đa từ cảm biến đến chấp hành (WCRT $\le 250\,\text{ms}$):} Kể từ thời điểm cảm biến thu nhận xung Echo phản ánh mực nước vượt ngưỡng nguy cấp, thời gian phản ứng tức thời để thuật toán FSM ra quyết định và tiếp điểm Relay máy bơm đóng kín hoàn toàn ($T_{\text{WCRT\_urgent}}$) không vượt quá $250\,\text{ms}$ (tính toán đạt $203\,\text{ms}$). Đối với các chuyển trạng thái bậc thang thông thường, hệ thống áp dụng thêm bộ lọc chống rung thời gian Debounce $1.0\,\text{s}$ để đảm bảo độ tin cậy cơ cấu.
    \item \textbf{Chu kỳ làm mới giao diện Web ($T_{\text{refresh}} = 1000\,\text{ms}$):} Chu kỳ polling $1\,\text{s}$ từ Dashboard đảm bảo cân bằng tối ưu giữa độ tươi mới của dữ liệu hiển thị và tải bộ nhớ RAM/băng thông mạng của chip vi điều khiển ESP32.
\end{itemize}

\subsection{Độ Tin Cậy, Watchdog \& An Toàn Vận Hành (Safety \& Reliability)}
\begin{itemize}
    \item \textbf{Bộ giám sát tác vụ Task Watchdog Timer (TWDT):} Hệ thống cấu hình bộ định thời giám sát tác vụ phần mềm thuộc hệ điều hành ESP-IDF FreeRTOS (thông qua hàm \lstinline|esp_task_wdt_add(NULL)| gán trực tiếp cho \texttt{loopTask}) với chu kỳ timeout $3000\,\text{ms}$ ($3\,\text{s}$). Nếu vòng lặp chính của chương trình bị treo (do bẫy lỗi hoặc vòng lặp vô hạn), cơ chế TWDT sẽ tự động kích hoạt ngắt Reset vi điều khiển để khôi phục trạm về trạng thái an toàn ban đầu.
    \item \textbf{Cơ chế Failsafe mạng ($30\,\text{s}$):} Bộ đếm thời gian tầng ứng dụng đo khoảng cách giữa các gói tin điều khiển Web, tự động chuyển về AUTO nếu mất kết nối quá $30\,\text{s}$, ngăn ngừa rủi ro bỏ quên trạm ở chế độ thủ công.
\end{itemize}

\subsection{Phân Tích An Ninh \& Giới Hạn Bảo Mật (Security Analysis)}
Trong phạm vi mô hình thực nghiệm:
\begin{itemize}
    \item \textbf{Kiến trúc mạng:} Trạm phát sóng ở chế độ SoftAP (mạng \texttt{FloodGuard\_AP}) sử dụng chuẩn mã hóa WPA2-PSK yêu cầu mật khẩu để gia nhập mạng cục bộ.
    \item \textbf{Giới hạn hiện tại:} Máy chủ Web Server nhúng chạy trên giao thức HTTP cổng 80 không mã hóa (chưa hỗ trợ HTTPS/TLS) do chip ESP32 bị giới hạn về dung lượng RAM và mã hóa TLS tiêu tốn đáng kể chu kỳ xử lý CPU, gây ảnh hưởng đến tính thời gian thực của tác vụ điều khiển. Đồng thời, các endpoint API chưa áp dụng cơ chế xác thực Token hoặc OAuth2; các lệnh điều khiển hiện tại sử dụng phương thức \texttt{GET /api/control}.
    \item \textbf{Định hướng nâng cấp công nghiệp:} Đối với phiên bản triển khai thương mại diện rộng, hệ thống cần được nâng cấp: chuyển các lệnh thay đổi trạng thái sang phương thức chuẩn \texttt{POST /api/control} có kèm mã xác thực JSON Web Token (JWT), tích hợp vi mạch mã hóa bảo mật chuyên dụng (AtegCC608A) để xử lý HTTPS, và cấu hình danh sách trắng địa chỉ vật lý (MAC Address Whitelisting) chỉ cho phép các thiết bị chuyên trách được kết nối điều khiển trạm.
\end{itemize}
