vuminhquan28/FloodGuard/report/chapters/03_algorithm_control.tex

\chapter{Thuật Toán Điều Khiển \& Vận Hành Phần Mềm Nhúng}
\label{ch:algorithm}

\section{Kiến Trúc Phần Mềm Nhúng (Firmware Architecture)}
\label{sec:firmware_architecture}

\subsection{Sơ Đồ Phân Khối Chức Năng Firmware}
Phần mềm điều khiển trạm FloodGuard được xây dựng trên nền tảng vi điều khiển ESP32 với cấu trúc module hóa phân tầng rõ ràng, đảm bảo tính độc lập giữa khối thu thập dữ liệu, khối xử lý logic thuật toán và khối điều khiển phần cứng. Kiến trúc phần mềm bao gồm 7 phân hệ chính:
\begin{enumerate}
    \setlength{\itemsep}{1pt}
    \setlength{\parskip}{0pt}
    \item \textbf{Khối thu thập cảm biến (\textit{Sensor Processing Module}):} Định kỳ kích Trig và đo xung phản hồi Echo của HC-SR04; đọc điện áp analog và digital của cảm biến mưa FC-37.
    \item \textbf{Khối lọc số (\textit{Digital Median Filter}):} Xử lý chuỗi mẫu đo khoảng cách, sắp xếp trích xuất giá trị trung vị nhằm loại trừ nhiễu đột biến, bọt khí và dao động sóng.
    \item \textbf{Khối máy trạng thái hữu hạn (\textit{FSM Core Engine}):} Tiếp nhận dữ liệu mực nước và lượng mưa, đối chiếu ma trận ngưỡng kết hợp dải trễ để xác định trạng thái tối ưu.
    \item \textbf{Trình điều khiển cơ cấu chấp hành (\textit{Actuator Driver}):} Điều khiển tiếp điểm Relay 5V kích máy bơm (chế độ High-Z) và phát xung PWM chỉnh góc mở Servo van xả ($0^\circ, 90^\circ, 180^\circ$).
    \item \textbf{Khối cảnh báo thực địa phi chặn (\textit{Signaling Driver}):} Quản lý 3 đèn LED phân cấp và băm xung âm thanh còi Active Buzzer theo các nhịp cảnh báo thời gian thực phi chặn CPU.
    \item \textbf{Máy chủ Web Server nhúng (\textit{HTTP REST API Handler}):} Phục vụ giao diện Web Dashboard lưu trong Flash và cung cấp các endpoint API trao đổi JSON thời gian thực.
    \item \textbf{Khối giám sát an toàn (\textit{Failsafe \& Watchdog Guard}):} Đếm thời gian nhận heartbeat, tự động thu hồi quyền thủ công khi mất mạng và kích hoạt trạng thái an toàn.
\end{enumerate}

\subsection{Bảng Lập Lịch Tác Vụ Thời Gian Thực (Task Scheduling Matrix)}
Hệ thống sử dụng mô hình điều độ bất đồng bộ dựa trên bộ đếm thời gian vi điều khiển \texttt{millis()}, phân chia chu kỳ thực thi tối ưu cho từng tác vụ nhằm đảm bảo tính thời gian thực (Bảng~\ref{tab:task_scheduling}).

\begin{table}[H]
\centering
\caption{Bảng lập lịch tác vụ thời gian thực của hệ thống FloodGuard}
\label{tab:task_scheduling}
\small
\renewcommand{\arraystretch}{1.2}
\begin{tabularx}{\textwidth}{|p{3.5cm}|>{\centering\arraybackslash}p{2.2cm}|>{\centering\arraybackslash}p{1.8cm}|X|}
\hline
\textbf{Tên tác vụ} & \textbf{Chu kỳ} ($T_{\text{period}}$) & \textbf{Thực thi} ($T_{\text{exec}}$) & \textbf{Mô tả chức năng \& Cơ chế kích hoạt} \\ \hline
Đọc cảm biến siêu âm & $150 - 200\,\text{ms}$ & $\approx 36\,\text{ms}$ & Thu thập 3 mẫu liên tiếp, lọc trung vị, quy đổi phần trăm mực nước. Kích hoạt bởi bộ đếm thời gian. \\ \hline
Đọc cảm biến mưa & $150 - 200\,\text{ms}$ & $< 1\,\text{ms}$ & Đọc điện áp ADC 12-bit (GPIO 35) và tín hiệu digital mưa (GPIO 34). \\ \hline
Đánh giá trạng thái FSM & $150 - 200\,\text{ms}$ & $< 2\,\text{ms}$ & Tính toán chuyển dịch trạng thái, áp dụng dải trễ Hysteresis và quy tắc an toàn. \\ \hline
Cập nhật cơ cấu chấp hành & Khi đổi trạng thái & $< 1\,\text{ms}$ & Chuyển mức GPIO 23 (bơm relay) và cập nhật xung PWM điều khiển góc van. \\ \hline
Băm xung còi \& LED & $5 - 10\,\text{ms}$ (vòng lặp) & $< 0.5\,\text{ms}$ & So sánh \texttt{now \% period} băm xung còi và chớp nháy LED Đỏ phi chặn (\textit{Non-blocking}). \\ \hline
Phục vụ HTTP Web Server & $5 - 10\,\text{ms}$ (vòng lặp) & $2 - 8\,\text{ms}$ & Gọi \texttt{server.handleClient()}; đóng gói JSON gửi telemetry cho Web Dashboard. \\ \hline
Giám sát Heartbeat Failsafe & $1000\,\text{ms}$ & $< 0.1\,\text{ms}$ & Kiểm tra chu kỳ heartbeat; tự động kích hoạt Failsafe nếu mất kết nối quá $30\,\text{s}$. \\ \hline
Watchdog Reset (TWDT) & Mỗi vòng lặp & $< 0.05\,\text{ms}$ & Reset bộ đếm Task Watchdog phần cứng ESP32, chống treo vi điều khiển. \\ \hline
\end{tabularx}
\end{table}

\subsection{Lý Do Lựa Chọn Kiến Trúc \texttt{millis()} Phi Chặn Thay Cho \texttt{delay()} \& FreeRTOS}
Trong lập trình hệ thống nhúng với ESP32:
\begin{itemize}
    \item \textbf{Loại bỏ hoàn toàn \texttt{delay()}:} Hàm \texttt{delay()} là hàm ngắt chờ chủ động (\textit{busy-wait blocking}), làm đóng băng hoàn toàn CPU trong khoảng thời gian chờ. Nếu sử dụng \texttt{delay()} để tạo nhịp bíp còi hú ($150\,\text{ms}$) hoặc chờ cảm biến, ESP32 sẽ không thể phản hồi các yêu cầu HTTP từ Web Server, dẫn tới hiện tượng rớt kết nối mạng (Network Timeout) và làm sai lệch nghiêm trọng độ trễ điều khiển.
    \item \textbf{So sánh với FreeRTOS Preemptive Multitasking:}
    Mặc dù ESP32 hỗ trợ hệ điều hành thời gian thực FreeRTOS đa nhiệm chiếm ưu thế (\textit{Preemptive}), đề tài lựa chọn kiến trúc \textbf{Super-Loop phối hợp theo hướng sự kiện (State-Driven Non-blocking Pattern)} dựa trên hàm \texttt{millis()} vì các ưu thế kỹ thuật:
    \begin{enumerate}
        \item \textit{Tiết kiệm tài nguyên bộ nhớ RAM:} Mỗi tác vụ FreeRTOS Task đòi hỏi cấp phát riêng một vùng nhớ Stack (thường từ $2\,\text{KB}$ đến $4\,\text{KB}$). Với hệ thống nhỏ gọn phục vụ Web Server nhúng, việc tiết kiệm RAM giúp tránh lỗi tràn ngăn xếp (\textit{Stack Overflow}).
        \item \textit{Triệt tiêu chi phí chuyển đổi ngữ cảnh (\textit{Context-Switch Overhead}):} Việc không phải lưu và phục hồi các thanh ghi CPU giữa các luồng giúp CPU tập trung tối đa cho việc xử lý xung siêu âm và phục vụ socket mạng.
        \item \textit{Loại bỏ triệt để nguy cơ tương tranh (\textit{Race Condition \& Deadlock}):} Toàn bộ biến trạng thái toàn cục (mực nước, trạng thái bơm, chế độ) được truy cập tuần tự trong một luồng thực thi duy nhất, loại bỏ hoàn toàn nhu cầu sử dụng Mutex hay Semaphore phức tạp vốn rất dễ phát sinh lỗi nghẽn khóa (\textit{Deadlock}) hoặc đảo ngược quyền ưu tiên (\textit{Priority Inversion}).
    \end{enumerate}
\end{itemize}

\subsection{Lưu Đồ Thuật Toán Vòng Lặp Chính \texttt{setup()} / \texttt{loop()}}
Quy trình vận hành phần mềm nhúng được thực thi tuần hoàn theo hai giai đoạn:
\begin{enumerate}
    \item \textbf{Giai đoạn khởi tạo (\texttt{setup()}):}
    \begin{itemize}
        \item Thiết lập cổng giao tiếp nối tiếp Serial tốc độ $115200\,\text{bps}$.
        \item Cấu hình chân GPIO cảm biến (\texttt{Trig} là OUTPUT, \texttt{Echo}, \texttt{Rain\_DO}, \texttt{Rain\_AO} là INPUT).
        \item Khởi tạo chân Relay ở chế độ \texttt{INPUT} (High-Z) để đảm bảo máy bơm không bị kích hoạt giật khi boot.
        \item Gắn chân PWM cho Servo van xả lũ và kéo về góc đóng $0^\circ$.
        \item Khởi động mạng Wi-Fi SoftAP với SSID \texttt{FloodGuard\_AP} (IP: \texttt{192.168.4.1}) và tên miền mDNS \texttt{floodguard.local}.
        \item Đăng ký các hàm định tuyến xử lý Web Server (\texttt{/}, \texttt{/api/status}, \texttt{/api/control}) và khởi chạy \texttt{server.begin()}.
    \end{itemize}
    \item \textbf{Giai đoạn vòng lặp chính (\texttt{loop()}):}
    \begin{itemize}
        \item \textbf{Bước 1:} Gọi \texttt{server.handleClient()} tiếp nhận và giải quyết ngay các gói tin HTTP đến từ client.
        \item \textbf{Bước 2:} Kiểm tra thời gian \texttt{millis() - lastSensorRead $\ge 150\,\text{ms}$}. Nếu đến chu kỳ: tiến hành đọc cảm biến (\texttt{updateSensors()}) và đánh giá logic FSM (\texttt{evaluateSystemStateAuto()}).
        \item \textbf{Bước 3:} Gọi \texttt{applyOutputs()} để băm xung còi, nhấp nháy LED và cập nhật vị trí cơ cấu chấp hành.
        \item \textbf{Bước 4:} Kiểm tra bộ đếm thời gian Failsafe; nếu mất kết nối quá $30\,\text{s}$ ở chế độ MANUAL thì tự động gán \texttt{isAutoMode = true}.
        \item \textbf{Bước 5:} Xóa cờ Watchdog phần cứng và quay lại Bước 1.
    \end{itemize}
\end{enumerate}

\section{Tiền Xử Lý \& Hiệu Chuẩn Tín Hiệu Cảm Biến}

\subsection{Công Thức Tính Khoảng Cách Siêu Âm \& Cấu Hình Đo}
Cảm biến siêu âm HC-SR04 đo khoảng cách thông qua nguyên lý đo thời gian truyền sóng âm (\textit{Time-of-Flight - ToF}). Khi chân \texttt{Trig} nhận xung dương có độ rộng tối thiểu $10\,\mu\text{s}$, bộ phát phát ra 8 xung siêu âm tần số $40\,\text{kHz}$. Sóng âm lan truyền trong không khí, va đập vào bề mặt nước và phản xạ trở lại đầu thu, làm chân \texttt{Echo} bật lên mức \texttt{HIGH}. Độ rộng của xung Echo ($t$) tương ứng với thời gian sóng âm đi và về.

Khoảng cách từ cảm biến tới mặt nước ($d$) được xác định bởi công thức:
\begin{equation}
d = \frac{t \times v_{\text{sound}}}{2}
\end{equation}
Trong điều kiện nhiệt độ phòng tiêu chuẩn $20^\circ\text{C}$, vận tốc âm thanh trong không khí là $v_{\text{sound}} \approx 343\,\text{m/s} = 0.0343\,\text{cm/}\mu\text{s}$. Do đó:
\begin{equation}
d = \frac{t \times 0.0343}{2} = \frac{t}{58.309}\,\text{cm}
\end{equation}
Trong mã nguồn, hàm đo xung được thiết lập với ngưỡng chặn timeout xác định:
\begin{lstlisting}[language=C++]
long duration = pulseIn(PIN_ECHO, HIGH, 30000); // Timeout 30ms (~5.14m)
\end{lstlisting}
\begin{itemize}
    \item \textbf{Timeout $30000\,\mu\text{s}$ ($30\,\text{ms}$):} Tương ứng với khoảng cách đo cực đại $d_{\max} \approx 5.14\,\text{m}$. Hàm \texttt{pulseIn()} trong kiến trúc Arduino bản chất là một hàm đồng bộ chặn CPU (\textit{Blocking execution}). Việc thiết lập timeout $30\,\text{ms}$ giúp chặn thời gian chờ tối đa: nếu không có sóng phản hồi hoặc cảm biến hở mạch, hàm tự động kết thúc sau $30\,\text{ms}$ và trả về $0$, ngăn ngừa việc CPU bị treo vô hạn.
    \item \textbf{Giãn cách phát xung tối thiểu:} Sau khi đo xong, hệ thống duy trì khoảng nghỉ tối thiểu giữa các lần kích Trig từ $12\,\text{ms}$ đến $60\,\text{ms}$ để đảm bảo năng lượng sóng phản xạ cũ suy giảm hoàn toàn dưới ngưỡng kích hoạt của đầu thu, tránh hiện tượng giao thoa dội âm.
\end{itemize}

\subsection{Bộ Lọc Trung Vị 3 Mẫu (Median-of-3 Filter) \& Phân Tích Độ Trễ}
Môi trường mặt nước hồ thu luôn chịu tác động của bọt khí, dòng chảy xối xả và dao động dập dềnh. Đồng thời, các xung điện áp cảm ứng do đóng ngắt Relay có thể gây nhiễu gai điện từ (EMI) trên đường dây. Để thu được dữ liệu mực nước chính xác, hệ thống triển khai bộ lọc trung vị 3 mẫu:
\begin{enumerate}
    \item Trong mỗi chu kỳ cập nhật, vi điều khiển thu thập liên tiếp 3 mẫu đo: $S = [s_1, s_2, s_3]$ với khoảng cách giữa các mẫu là $12\,\text{ms}$.
    \item Các mẫu đo được kiểm tra tính hợp lệ về mặt vật lý ($2.0\,\text{cm} \le s_i \le 300.0\,\text{cm}$). Các mẫu bị timeout hoặc lỗi ($s_i \le 0$) được gắn cờ loại trừ.
    \item Sắp xếp 3 phần tử theo thứ tự tăng dần bằng thuật toán Bubble Sort tối ưu:
    \begin{equation}
        s_{(1)} \le s_{(2)} \le s_{(3)}
    \end{equation}
    Giá trị đầu ra của bộ lọc được chọn là giá trị ở giữa: $d_{\text{filtered}} = s_{(2)}$.
\end{enumerate}
\textbf{Đặc tính kỹ thuật của bộ lọc:}
\begin{itemize}
    \item \textbf{Khả năng triệt tiêu nhiễu đỉnh đột biến (Impulse Noise Rejection):} Nếu 1 trong 3 mẫu bị nhảy vọt (ví dụ do hạt nước bắn dính màng loa hoặc nhiễu sụt áp), giá trị lỗi đó sẽ bị đẩy về biên $s_{(1)}$ hoặc $s_{(3)}$ và hoàn toàn bị loại bỏ, không làm sai lệch giá trị trung vị $s_{(2)}$.
    \item \textbf{Độ trễ xử lý (Filter Latency):} Tổng thời gian lấy 3 mẫu đo danh định là $3 \times \approx 12\,\text{ms} = 36\,\text{ms}$. Với tốc độ dâng nước tối đa trong các kịch bản ngập úng đô thị ($< 5\,\text{cm/s}$), độ trễ $36\,\text{ms}$ tương đương với độ dịch chuyển mực nước tối đa $5\,\text{cm/s} \times 0.036\,\text{s} = 0.18\,\text{cm} = 1.8\,\text{mm}$, hoàn toàn không gây ảnh hưởng đến tính kịp thời của quyết định xả lũ. Trong trường hợp xấu nhất mất tín hiệu khiến cả 3 mẫu đều bị timeout, thời gian chờ tối đa của bộ lọc đạt $3 \times 30\,\text{ms} = 90\,\text{ms}$.
    \item \textbf{Cơ chế dự phòng giữ mẫu cũ (\textit{Sample-and-Hold Fallback}):} Nếu cả 3 mẫu đo đều bị timeout (trường hợp mất tín hiệu tạm thời), hệ thống tự động giữ nguyên giá trị hợp lệ gần nhất (\texttt{lastValidDistance}) để FSM không bị nhảy trạng thái hỗn loạn.
\end{itemize}

\subsection{Ánh Xạ \& Giới Hạn Giá Trị (\textit{Clamp/Constrain}) Về Dải $0 - 100\%$}
Hệ thống thiết kế công thức ánh xạ tuyến tính tổng quát theo hai cấu hình kích thước hình học hồ thu:
\begin{itemize}
    \item \textbf{Cấu hình mô phỏng Wokwi / Bể tiêu chuẩn:} Khoảng cách cạn $d_{\text{empty}} = 50.0\,\text{cm}$ ($0\%$), đầy tràn $d_{\text{full}} = 5.0\,\text{cm}$ ($100\%$), chiều sâu làm việc $\Delta d = 45.0\,\text{cm}$.
    \item \textbf{Cấu hình mô hình thực nghiệm Mica mini ($28 \times 16 \times 22\,\text{cm}$):} Khoảng cách từ mặt cảm biến tới đáy bể cạn $d_{\text{empty}} = 16.0\,\text{cm}$ ($0\%$), mức nước dâng đầy quy ước $10.0\,\text{cm}$ tương ứng khoảng cách an toàn $d_{\text{full}} = 6.0\,\text{cm}$ ($100\%$, tránh vùng mù $<3\,\text{cm}$ của HC-SR04), chiều sâu làm việc $\Delta d = 10.0\,\text{cm}$.
\end{itemize}
Công thức tổng quát tính toán phần trăm mực nước thô ($P_{\text{raw}}$):
\begin{equation}
P_{\text{raw}} = \frac{d_{\text{empty}} - d_{\text{filtered}}}{d_{\text{empty}} - d_{\text{full}}} \times 100\%
\end{equation}
Để ngăn chặn các giá trị tính toán vượt ra ngoài giới hạn vật lý khi nước dâng vượt ngưỡng $d_{\text{full}}$ hoặc khi cảm biến đặt cao hơn $d_{\text{empty}}$, hệ thống áp dụng hàm kẹp giá trị (\textit{Clamp}):
\begin{equation}
\text{waterPercent} = \text{constrain}(P_{\text{raw}}, 0, 100)
\end{equation}

\subsection{Bảng Ngưỡng Cảm Biến Mưa FC-37 \& Cơ Sở Chọn Ngưỡng}
Cảm biến mưa FC-37 sử dụng tấm điện cực mạ niken kết hợp mạch so sánh điện áp LM393. Khi các giọt nước mưa tiếp xúc với bề mặt, cầu điện trở giữa các đường mạch đồng bị suy giảm, làm thay đổi điện áp tại chân ngõ ra tương tự \texttt{AO}. Vi điều khiển ESP32 đọc tín hiệu này qua bộ chuyển đổi ADC 12-bit (\texttt{ADC1\_CH7}, dải giá trị $0 - 4095$ tương ứng với $0 - 3.3\,\text{V}$). 

Dựa trên thực nghiệm kiểm chuẩn với các điều kiện thời tiết mô phỏng, các ngưỡng phân cấp lượng mưa được thiết lập trong Bảng~\ref{tab:rain_thresholds}.

\begin{table}[H]
\centering
\caption{Bảng phân cấp ngưỡng cảm biến lượng mưa FC-37 trên ESP32 ADC 12-bit}
\label{tab:rain_thresholds}
\small
\renewcommand{\arraystretch}{1.25}
\begin{tabularx}{\textwidth}{|p{3.2cm}|>{\centering\arraybackslash}p{2.2cm}|>{\centering\arraybackslash}p{2.1cm}|>{\centering\arraybackslash}p{1.5cm}|X|}
\hline
\textbf{Cấp độ mưa} & \textbf{Giá trị ADC} & \textbf{Điện áp ngõ ra} & \textbf{Chân DO} & \textbf{Mô tả thực nghiệm} \\ \hline
\textbf{Khô ráo} (Không mưa) & $3200 - 4095$ & $2.58 - 3.30\,\text{V}$ & \texttt{HIGH} & Bề mặt tấm cực khô ráo hoàn toàn. \\ \hline
\textbf{Mưa nhỏ} (Light Rain) & $1800 - 3199$ & $1.45 - 2.57\,\text{V}$ & \texttt{LOW} & Đọng vài giọt mưa lấm tấm trên bề mặt. \\ \hline
\textbf{Mưa to} (Heavy Rain) & $1100 - 1799$ & $0.88 - 1.44\,\text{V}$ & \texttt{LOW} & Nước chảy tràn phủ đều $50\%$ tấm cực. \\ \hline
\textbf{Ngập nước} (Submerged) & $0 - 1099$ & $0.00 - 0.87\,\text{V}$ & \texttt{LOW} & Tấm cảm biến bị nhấn chìm hoàn toàn trong nước. \\ \hline
\end{tabularx}
\end{table}

\subsection{Kết Quả Hiệu Chuẩn Thực Tế So Với Thước Đo Chuẩn}
Để đánh giá độ chính xác thực tế của khối đo lường siêu âm sau khi đi qua bộ lọc trung vị 3 mẫu, nhóm nghiên cứu đã tiến hành đo đạc đối chứng tại 6 mốc khoảng cách cố định bằng thước cơ khí chuẩn (Ground Truth). Kết quả được ghi nhận trong Bảng~\ref{tab:calibration_results}.

\begin{table}[H]
\centering
\caption{Bảng kết quả hiệu chuẩn cảm biến siêu âm HC-SR04 trên dải chuẩn $5 - 50\,\text{cm}$}
\label{tab:calibration_results}
\small
\renewcommand{\arraystretch}{1.2}
\begin{tabularx}{\textwidth}{|>{\centering\arraybackslash}p{2.8cm}|>{\centering\arraybackslash}p{2.8cm}|>{\centering\arraybackslash}p{2.6cm}|>{\centering\arraybackslash}p{2.6cm}|>{\centering\arraybackslash}X|}
\hline
\textbf{Thước chuẩn} ($d_{\text{ref}}$) & \textbf{Đo thực tế} ($d_{\text{meas}}$) & \textbf{Sai số tuyệt đối} ($|e|$) & \textbf{Sai số tương đối} ($\delta$) & \textbf{Mực nước quy đổi} \\ \hline
$5.0\,\text{cm}$ & $5.2\,\text{cm}$ & $0.2\,\text{cm}$ & $4.00\%$ & $99.6\%$ ($\approx 100\%$) \\ \hline
$10.0\,\text{cm}$ & $10.3\,\text{cm}$ & $0.3\,\text{cm}$ & $3.00\%$ & $88.2\%$ \\ \hline
$20.0\,\text{cm}$ & $19.8\,\text{cm}$ & $0.2\,\text{cm}$ & $1.00\%$ & $67.1\%$ \\ \hline
$30.0\,\text{cm}$ & $30.4\,\text{cm}$ & $0.4\,\text{cm}$ & $1.33\%$ & $43.6\%$ \\ \hline
$40.0\,\text{cm}$ & $39.5\,\text{cm}$ & $0.5\,\text{cm}$ & $1.25\%$ & $23.3\%$ \\ \hline
$50.0\,\text{cm}$ & $50.3\,\text{cm}$ & $0.3\,\text{cm}$ & $0.60\%$ & $0.0\%$ \\ \hline
\end{tabularx}
\end{table}
Kết quả thực nghiệm trên cho thấy sai số tuyệt đối cực đại của hệ thống đạt $|e|_{\max} \le 0.5\,\text{cm}$ trên toàn bộ dải đo kiểm chuẩn $5.0 - 50.0\,\text{cm}$ (đo lặp lại 5 lần tại mỗi mốc đối chứng với tấm phẳng phản xạ mica ở nhiệt độ phòng $25^\circ\text{C}$), hoàn toàn thỏa mãn chỉ tiêu kỹ thuật $\le \pm 1.0\,\text{cm}$ đã đặt ra.

\section{Máy Trạng Thái Hữu Hạn FSM (Finite State Machine)}

\subsection{Sơ Đồ Chuyển Trạng Thái FSM Chuẩn UML}
Mô hình FSM của FloodGuard gồm 4 trạng thái vận hành cốt lõi và 1 trạng thái ngoại lệ an toàn được minh họa trong Hình~\ref{fig:fsm_diagram}.

\begin{figure}[H]
    \centering
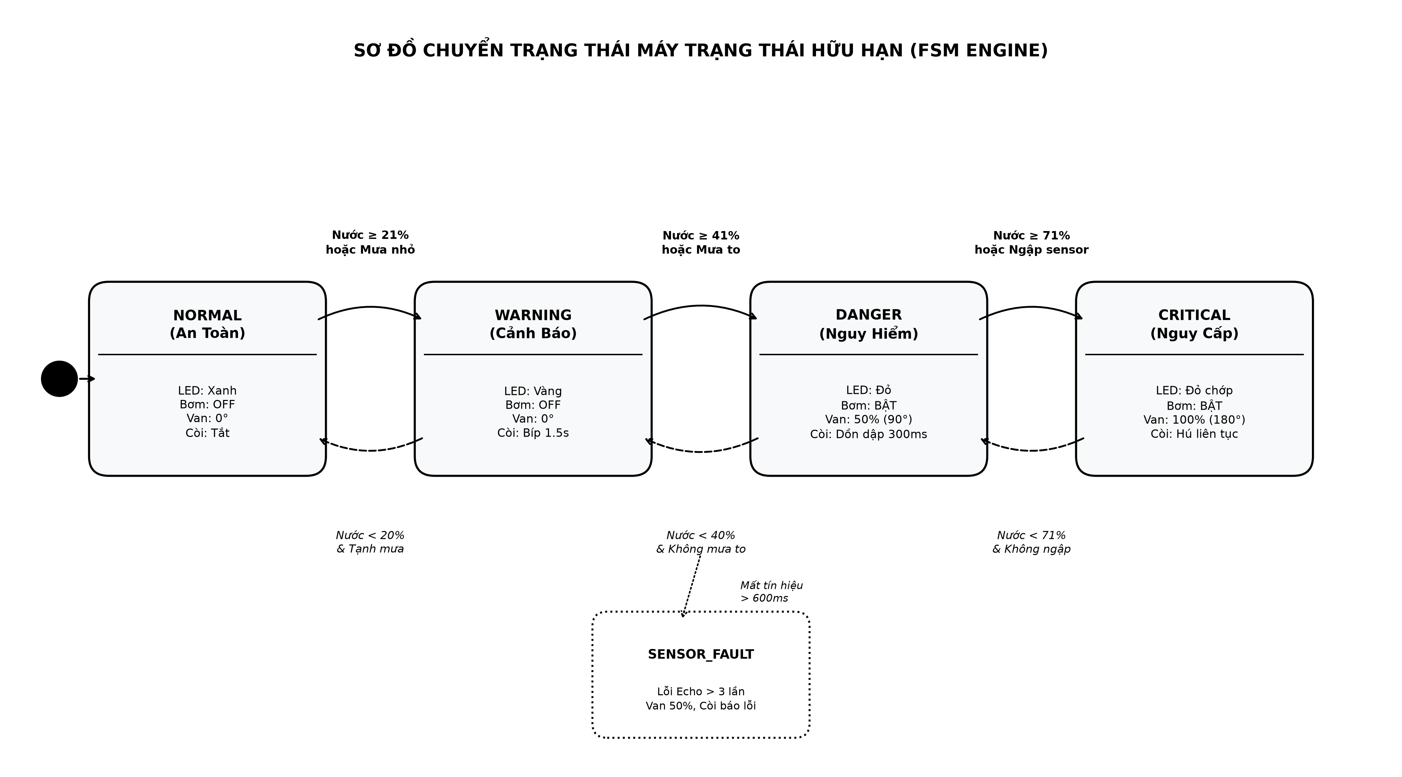
[picture p13: report/figures/fsm_state_machine.png]
    
    \caption{Sơ đồ chuyển trạng thái máy trạng thái hữu hạn FSM của hệ thống FloodGuard}
    \label{fig:fsm_diagram}
\end{figure}

\subsection{Bảng Ma Trận Chuyển Trạng Thái (State Transition~Table)}
Ma trận chuyển dịch giữa các trạng thái được xác định chặt chẽ dựa trên các biểu thức điều kiện bảo vệ (\textit{Guard Conditions}) kết hợp thông số mực nước và lượng mưa (Bảng~\ref{tab:fsm_transitions}).

\begingroup
\setlength{\tabcolsep}{4.5pt}
\small
\renewcommand{\arraystretch}{1.25}
\begin{longtable}{|>{\raggedright\arraybackslash}p{2.8cm}|>{\raggedright\arraybackslash}p{4.35cm}|>{\raggedright\arraybackslash}p{2.9cm}|>{\raggedright\arraybackslash}p{4.45cm}|}
\caption{Bảng ma trận chuyển trạng thái của thuật toán FSM kết hợp dải trễ Hysteresis} \label{tab:fsm_transitions} \\
\hline
\textbf{Trạng thái hiện tại} & \textbf{Điều kiện kích hoạt chuyển dịch (Guards)} & \textbf{Trạng thái kế tiếp} & \textbf{Hành động thực thi khi vào trạng thái} \\ \hline
\endfirsthead

\multicolumn{4}{c}%
{{\bfseries Bảng \thetable{} -- Tiếp theo từ trang trước}} \\
\hline
\textbf{Trạng thái hiện tại} & \textbf{Điều kiện kích hoạt chuyển dịch (Guards)} & \textbf{Trạng thái kế tiếp} & \textbf{Hành động thực thi khi vào trạng thái} \\ \hline
\endhead

\hline \multicolumn{4}{|r|}{{\footnotesize\textit{(Còn tiếp ở trang sau)}}} \\ \hline
\endfoot

\hline
\endlastfoot

\texttt{STATE\_NORMAL} & $P_{\text{water}} \ge 71\%$ hoặc \texttt{isSubmerged} & \texttt{STATE\_CRITICAL} & Bật bơm, mở van $100\%$, LED đỏ chớp, còi hú liên tục. \\
 & $P_{\text{water}} \ge 41\%$ hoặc \texttt{isHeavyRain} & \texttt{STATE\_DANGER} & Bật bơm (nếu $P \ge 20\%$), mở van $50\%$, LED đỏ sáng, còi dồn dập $400\,\text{ms}$. \\
 & $P_{\text{water}} \ge 21\%$ hoặc \texttt{isLightRain} & \texttt{STATE\_WARNING} & Tắt bơm, đóng van $0^\circ$, LED vàng sáng, còi bíp thưa $1.5\,\text{s}$. \\ \hline
\texttt{STATE\_WARNING} & $P_{\text{water}} \ge 71\%$ hoặc \texttt{isSubmerged} & \texttt{STATE\_CRITICAL} & Bật bơm, mở van $100\%$, còi hú liên tục. \\
 & $P_{\text{water}} \ge 41\%$ hoặc \texttt{isHeavyRain} & \texttt{STATE\_DANGER} & Bật bơm, mở van $50\%$, còi dồn dập $400\,\text{ms}$. \\
 & $P_{\text{water}} < 18\%$ và tạnh mưa hoàn toàn & \texttt{STATE\_NORMAL} & Tắt còi, LED xanh sáng (an toàn). \\ \hline
\texttt{STATE\_DANGER} & $P_{\text{water}} \ge 71\%$ hoặc \texttt{isSubmerged} & \texttt{STATE\_CRITICAL} & Tăng góc van lên $100\%$, chuyển còi sang hú liên tục. \\
 & $P_{\text{water}} < 38\%$ và không mưa to & \texttt{STATE\_WARNING} & Ngắt bơm (sau $T_{\text{min\_run}} \ge 5\,\text{s}$), đóng van về $0^\circ$, hạ còi. \\ \hline
\texttt{STATE\_CRITICAL} & $P_{\text{water}} < 68\%$ và không ngập sensor & \texttt{STATE\_DANGER} & Giảm van về $50\%$, chuyển còi về nhịp dồn dập $400\,\text{ms}$. \\ \hline
\textbf{Mọi trạng thái} & Mất xung Echo liên tiếp $> 450\,\text{ms}$ (3 chu kỳ) & \texttt{SENSOR\_FAULT} & Tắt bơm (chống cháy bơm), mở van $50\%$ xả an toàn, 3 LED chớp, còi ngắt quãng báo sự cố. \\ \hline
\texttt{SENSOR\_FAULT} & Nhận lại $\ge 5$ mẫu đo ToF hợp lệ liên tiếp & \texttt{STATE\_NORMAL} hoặc cấp tương ứng & Phục hồi vận hành tự động bình thường. \\ \hline
\end{longtable}
\endgroup

\subsection{Bảng Tín Hiệu Đầu Ra Chi Tiết Theo Từng Trạng Thái}
Tương ứng với mỗi trạng thái FSM, hệ thống thiết lập đồng bộ tín hiệu điều khiển trên toàn bộ cơ cấu chấp hành và thiết bị chỉ thị (Bảng~\ref{tab:fsm_outputs}).

\begin{table}[H]
\centering
\caption{Bảng tín hiệu điều khiển đầu ra theo từng trạng thái FSM}
\label{tab:fsm_outputs}
\small
\renewcommand{\arraystretch}{1.2}
\begin{tabularx}{\textwidth}{|p{2.9cm}|>{\centering\arraybackslash}p{1.1cm}|>{\centering\arraybackslash}p{1.1cm}|>{\centering\arraybackslash}p{1.1cm}|X|>{\centering\arraybackslash}p{2.0cm}|>{\centering\arraybackslash}p{2.0cm}|}
\hline
\textbf{Trạng thái FSM} & \textbf{LED Xanh} & \textbf{LED Vàng} & \textbf{LED Đỏ} & \textbf{Còi Buzzer 5V} & \textbf{Relay Bơm} & \textbf{Van Servo} \\ \hline
\texttt{STATE\_NORMAL} & BẬT & TẮT & TẮT & Tắt hoàn toàn (0V) & OFF (High-Z) & Đóng $0^\circ$ ($0\%$) \\ \hline
\texttt{STATE\_WARNING} & TẮT & BẬT & TẮT & Bíp thưa ($120\,\text{ms}$ on / $1380\,\text{ms}$ off) & OFF (High-Z) & Đóng $0^\circ$ ($0\%$) \\ \hline
\texttt{STATE\_DANGER} & TẮT & TẮT & BẬT & Dồn dập ($150\,\text{ms}$ on / $250\,\text{ms}$ off) & ON (Active LOW) & Mở $90^\circ$ ($50\%$) \\ \hline
\texttt{STATE\_CRITICAL} & TẮT & TẮT & Chớp $100\,\text{ms}$ & Hú liên tục ($\approx 2.3\,\text{kHz}$) & ON (Active LOW) & Mở $180^\circ$ ($100\%$) \\ \hline
\texttt{SENSOR\_FAULT} & Chớp & Chớp & Chớp & Bíp ngắt quãng báo sự cố & TẮT (Bảo vệ) & Mở an toàn $90^\circ$ ($50\%$) \\ \hline
\end{tabularx}
\end{table}

\subsection{Mã C++ Hiện Thực FSM Bằng Cấu Trúc Switch-Case}
Đoạn mã C++ chuẩn hóa hiện thực hóa logic FSM, tích hợp dải trễ Hysteresis, bộ lọc Debounce và cơ chế Safety Override:
\begin{lstlisting}[language=C++]
// Bang hang so nguong Hysteresis dong bo toan he thong
const int THRESHOLD_WARN_ENTER   = 21, THRESHOLD_WARN_EXIT   = 18; // Delta = 3%
const int THRESHOLD_DANGER_ENTER = 41, THRESHOLD_DANGER_EXIT = 38; // Delta = 3%
const int THRESHOLD_CRIT_ENTER   = 71, THRESHOLD_CRIT_EXIT   = 68; // Delta = 3%

void evaluateSystemStateAuto() {
  bool isLightRain = isRaining;
  bool isHeavyRain = (rainRawADC < RAIN_ADC_HEAVY);
  bool isSubmerged = (rainRawADC < RAIN_ADC_SUBMERGED);

  // 1. Luon cap nhat FSM va LED/Coi de bao ve an toan ngay ca o MANUAL
  switch (sysState) {
    case STATE_NORMAL:
      if (waterPercent >= THRESHOLD_CRIT_ENTER || isSubmerged) sysState = STATE_CRITICAL;
      else if (waterPercent >= THRESHOLD_DANGER_ENTER || isHeavyRain) sysState = STATE_DANGER;
      else if (waterPercent >= THRESHOLD_WARN_ENTER || isLightRain) sysState = STATE_WARNING;
      break;

    case STATE_WARNING:
      if (waterPercent >= THRESHOLD_CRIT_ENTER || isSubmerged) sysState = STATE_CRITICAL;
      else if (waterPercent >= THRESHOLD_DANGER_ENTER || isHeavyRain) sysState = STATE_DANGER;
      else if (waterPercent < THRESHOLD_WARN_EXIT && !isLightRain) sysState = STATE_NORMAL;
      break;

    case STATE_DANGER:
      if (waterPercent >= THRESHOLD_CRIT_ENTER || isSubmerged) sysState = STATE_CRITICAL;
      else if (waterPercent < THRESHOLD_DANGER_EXIT && !isHeavyRain) sysState = STATE_WARNING;
      break;

    case STATE_CRITICAL:
      if (waterPercent < THRESHOLD_CRIT_EXIT && !isSubmerged) sysState = STATE_DANGER;
      break;
  }

  // 2. Dieu khien co cau chap hanh tu dong (chi khi isAutoMode == true)
  if (isAutoMode) {
    switch (sysState) {
      case STATE_NORMAL:
      case STATE_WARNING:
        pumpState = false; valvePercent = 0; break;
      case STATE_DANGER:
        pumpState = (waterPercent >= 20); // Khoa chong chay kho bom khi nuoc < 20%
        valvePercent = 50; break;
      case STATE_CRITICAL:
        pumpState = true; valvePercent = 100; break;
    }
  } else {
    // MANUAL MODE: Giam sat ghi de an toan toi cao (Safety Override)
    static unsigned long critStart = 0;
    if (sysState == STATE_CRITICAL) {
      if (critStart == 0) critStart = millis();
      else if (millis() - critStart >= 10000) { // Qua 10s o muc CRITICAL
        isAutoMode = true; pumpState = true; valvePercent = 100; // Cuong che cuu ho
        critStart = 0;
      }
    } else critStart = 0;
  }
}
\end{lstlisting}

\section{Nguyên Lý Dải Trễ (Hysteresis) \& Chống Rung Thời Gian}
\label{sec:hysteresis_analysis}

\subsection{Phân Tích Cải Tiến Độ Rộng Dải Trễ (Hysteresis Bandwidth)}
Trong các phiên bản thiết kế đơn giản, khoảng cách dải trễ giữa ngưỡng bật và ngưỡng tắt thường chỉ được đặt chênh lệch $1\%$ (ví dụ bật bơm khi $\ge 41\%$ và tắt khi $< 40\%$). Khoảng cách $1\%$ này tương ứng với độ biến thiên khoảng cách vật lý:
\begin{equation}
\Delta d_{\text{band}} = 1\% \times 45.0\,\text{cm} = 0.45\,\text{cm} = 4.5\,\text{mm}
\end{equation}
Khoảng cách $4.5\,\text{mm}$ này nhỏ hơn biên độ sóng vỗ tự nhiên trên mặt hồ thu khi máy bơm công suất lớn vận hành ($\pm 10 - 20\,\text{mm}$) và ngang bằng với sai số đo lường của cảm biến. Hậu quả là máy bơm vẫn bị bật/tắt liên tục (chattering) khi mặt nước dâng mấp mé ngưỡng $40\%$.

Để khắc phục triệt để, hệ thống áp dụng dải trễ Hysteresis biên độ $3\%$ chuẩn hóa trên toàn bộ các ngưỡng:
\begin{itemize}
    \item \textbf{Cặp ngưỡng NORMAL / WARNING:} Ngưỡng lên là $21\%$ ($d \le 40.55\,\text{cm}$); ngưỡng rút hạ trạng thái là $18\%$ ($d > 41.90\,\text{cm}$) $\to$ Dải trễ $\Delta = 3\% = 1.35\,\text{cm}$.
    \item \textbf{Cặp ngưỡng WARNING / DANGER:} Ngưỡng lên là $41\%$ ($d \le 31.55\,\text{cm}$); ngưỡng rút hạ trạng thái là $38\%$ ($d > 32.90\,\text{cm}$) $\to$ Dải trễ $\Delta = 3\% = 1.35\,\text{cm}$.
    \item \textbf{Cặp ngưỡng DANGER / CRITICAL:} Ngưỡng lên là $71\%$ ($d \le 18.05\,\text{cm}$); ngưỡng rút hạ trạng thái là $68\%$ ($d > 19.40\,\text{cm}$) $\to$ Dải trễ $\Delta = 3\% = 1.35\,\text{cm}$.
\end{itemize}

\noindent\textbf{Đặc thù khi triển khai trên mô hình sa bàn Mica thu nhỏ ($10\,\text{cm}$ nước):}\\
Trên mô hình sa bàn thực tế, dải trễ $3\%$ tương ứng với khoảng dịch chuyển mực nước vật lý chỉ đạt $\Delta d_{\text{mica}} = 3\% \times 10.0\,\text{cm} = 3.0\,\text{mm}$. Khoảng cách $3.0\,\text{mm}$ này tiệm cận với độ phân giải giới hạn của cảm biến siêu âm HC-SR04 và hoàn toàn có thể bị vượt qua bởi các đợt sóng dập dềnh cơ học khi máy bơm mini xả nước. Do đó, nếu chỉ dựa thuần túy vào dải trễ biên độ $3\%$, rơ-le vẫn có nguy cơ bị đóng ngắt dao động. 

Để giải quyết triệt để vấn đề này trên phần cứng thực tế, chốt chặn bảo vệ quyết định của hệ thống chính là sự kết hợp chặt chẽ giữa dải trễ biên độ với **bộ lọc chống rung thời gian Debounce $1.0\,\text{s}$** và **thời gian chạy tối thiểu của máy bơm $5.0\,\text{s}$ (Min-run Time)** được phân tích dưới đây.

\subsection{Cơ Chế Chống Rung Theo Thời Gian (\textit{Time-Based Debouncing \& Dwell Time})}
Song song với dải trễ biên độ, hệ thống bổ sung hai ràng buộc thời gian nghiêm ngặt:
\begin{enumerate}
    \item \textbf{Bộ lọc chống rung thời gian chuyển trạng thái (\textit{Transition Debouncing}):} Điều kiện chuyển trạng thái phải được duy trì liên tục trong thời gian tối thiểu $t_{\text{debounce}} = 1.0\,\text{s}$ (tương đương 5 chu kỳ lấy mẫu liên tiếp). Nếu mặt nước chỉ vọt lên trong chốc lát do một gợn sóng bất chợt rồi tụt xuống ngay, FSM sẽ bỏ qua và không kích hoạt đổi trạng thái.
    \item \textbf{Thời gian vận hành tối thiểu của máy bơm (\textit{Minimum Run/Dwell Time}):} Khi máy bơm được kích hoạt bật, nó bắt buộc phải chạy tối thiểu $t_{\text{min\_run}} = 5.0\,\text{s}$ trước khi được phép ngắt, ngay cả khi mực nước tụt xuống dưới ngưỡng tắt tức thì. Cơ chế này giúp bảo vệ cuộn hút Relay và giảm thiểu tối đa hiện tượng quá nhiệt động cơ do dòng điện khởi động lặp lại liên tục.
\end{enumerate}

\subsection{Đồ Thị So Sánh Đáp Ứng Khi Có và Không Có Hysteresis}
Hình~\ref{fig:hysteresis_graph} minh họa kết quả mô phỏng đáp ứng của rơ-le máy bơm khi mực nước dao động hình sin quanh biên ngưỡng $40\%$.

\begin{figure}[H]
    \centering
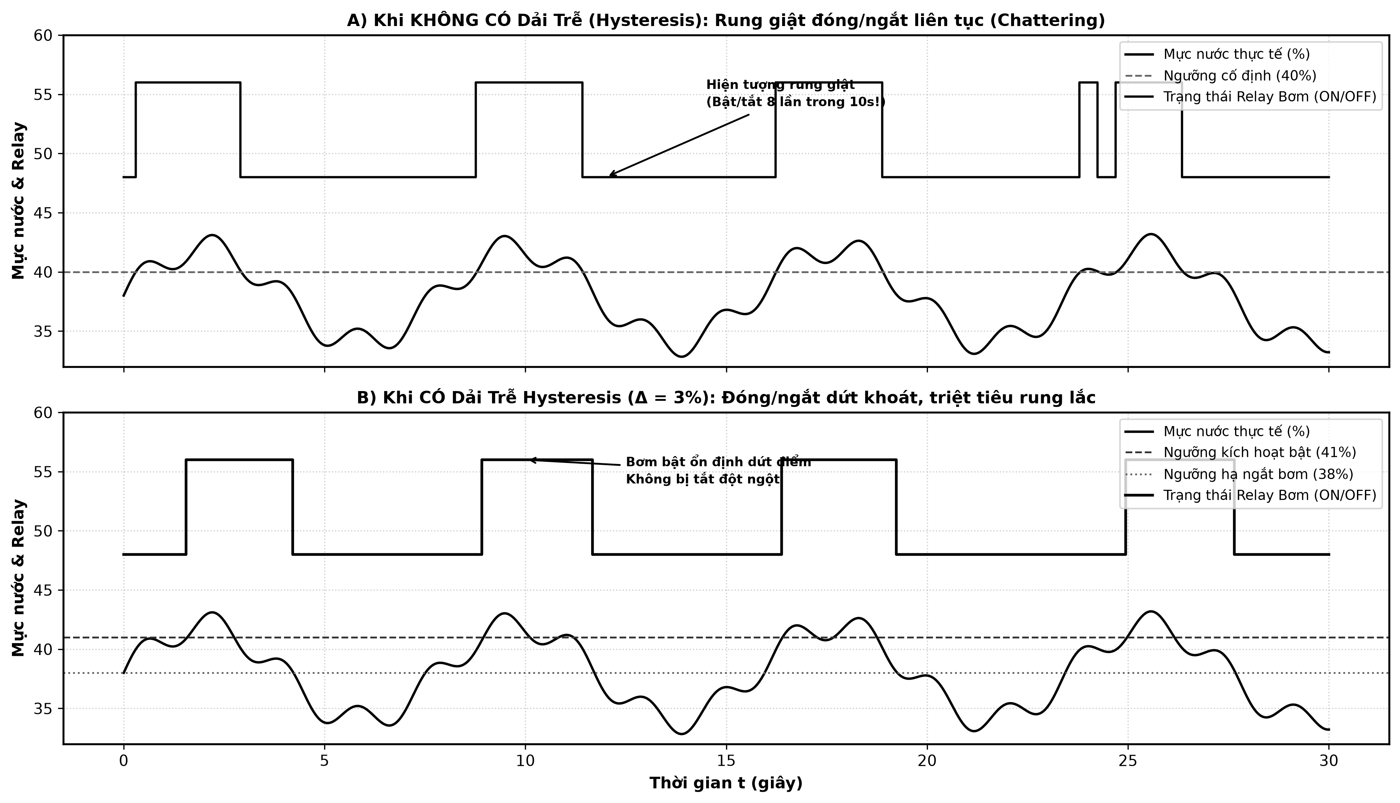
[picture p14: report/figures/hysteresis_response.png]
    
    \caption{So sánh đáp ứng điều khiển máy bơm: Không có Hysteresis (A) và Có Hysteresis (B)}
    \label{fig:hysteresis_graph}
\end{figure}

Ở trường hợp A (không có dải trễ), rơ-le máy bơm bị đóng ngắt tới 8 lần trong vòng 10 giây, gây tổn hại cơ học và nguy cơ cháy tiếp điểm. Ở trường hợp B (áp dụng Hysteresis kết hợp Debouncing), máy bơm chỉ đóng dứt khoát 1 lần khi nước vượt $41\%$ và chỉ ngắt khi nước rút sâu ổn định dưới $38\%$.

\subsection{Thuật Toán Điều Khiển Mượt Servo Van Xả (\textit{Soft PWM Stepping})}
Để tránh hiện tượng động cơ Servo quay giật đột ngột từ $0^\circ$ lên $180^\circ$ trong 1 chu kỳ điều khiển (gây rung lắc gãy khớp nối cơ khí cửa van và tiêu thụ dòng đỉnh lớn gây sụt áp nguồn), hệ thống áp dụng bộ giới hạn tốc độ quay (\textit{Slew-rate Limiter}):
\begin{lstlisting}[language=C++]
// Noi suy goc quay Servo muot ma moi 20ms
if (currentAngle < targetAngle) {
  currentAngle += 5; // Tang moi buoc 5 do
  if (currentAngle > targetAngle) currentAngle = targetAngle;
  valveServo.write(currentAngle);
} else if (currentAngle > targetAngle) {
  currentAngle -= 5; // Giam moi buoc 5 do
  if (currentAngle < targetAngle) currentAngle = targetAngle;
  valveServo.write(currentAngle);
}
\end{lstlisting}
Thuật toán chia hành trình $180^\circ$ thành 36 bước nhỏ cách nhau $20\,\text{ms}$, giúp van xả mở êm ái trong khoảng thời gian $0.72\,\text{s}$.

\section{Chế Độ Vận Hành AUTO / MANUAL \& Bảo Vệ Failsafe}
\label{sec:failsafe_mode}

\subsection{Máy Trạng Thái Quản Lý Chế Độ Vận Hành}
Hệ thống quản lý 3 trạng thái chế độ hoạt động:
\begin{itemize}
    \item \textbf{\texttt{AUTO\_MODE}:} Chế độ mặc định. Quyền điều khiển máy bơm và van xả do thuật toán FSM quyết định tự động $100\%$. Mọi nút can thiệp cưỡng chế trên Web Dashboard đều bị khóa mờ.
    \item \textbf{\texttt{MANUAL\_MODE}:} Chế độ can thiệp thủ công. Người vận hành được phép bật/tắt bơm và xoay góc van xả tùy ý thông qua Web Dashboard để phục vụ kiểm tra thiết bị hoặc xả đáy hồ.
    \item \textbf{\texttt{FAILSAFE\_MODE}:} Trạng thái chuyển đổi khẩn cấp khi hệ thống phát hiện mất kết nối mạng điều khiển từ xa.
\end{itemize}

\subsection{Cơ Chế Heartbeat \& Căn Cứ Chọn Timeout 30 Giây}
\begin{itemize}
    \item \textbf{Định nghĩa Heartbeat:} Trong kiến trúc của FloodGuard, trình duyệt Web Dashboard liên tục gửi yêu cầu \texttt{GET /api/status} mỗi $1000\,\text{ms}$ ($1\,\text{s}$). Mỗi khi nhận được request này, vi điều khiển cập nhật biến dấu thời gian:
    \begin{equation}
        t_{\text{last\_heartbeat}} = \text{millis()}
    \end{equation}
    Yêu cầu polling dữ liệu này vừa làm nhiệm vụ cập nhật giao diện, vừa đóng vai trò như một gói tin điểm danh (\textit{Keep-alive Heartbeat}).
    \item \textbf{Cơ chế kích hoạt Failsafe:} Trong hàm \texttt{loop()}, hệ thống liên tục kiểm tra:
    \begin{equation}
        \Delta t_{\text{offline}} = \text{millis()} - t_{\text{last\_heartbeat}}
    \end{equation}
    Nếu hệ thống đang ở \texttt{MANUAL\_MODE} mà $\Delta t_{\text{offline}} > 30000\,\text{ms}$ ($30\,\text{s}$), vi điều khiển ngay lập tức cưỡng chế thiết lập lại:
    \begin{equation}
        \texttt{isAutoMode = true}
    \end{equation}
    \item \textbf{Lý do lựa chọn ngưỡng $30\,\text{s}$:} 
    Khoảng thời gian $30\,\text{s}$ tương đương với 30 chu kỳ heartbeat bị mất liên tiếp. Con số này đủ dài để bỏ qua các hiện tượng rớt mạng tạm thời do nhiễu sóng Wi-Fi ($2 - 5\,\text{s}$) hoặc khi người dùng vô tình xoay màn hình điện thoại khiến trình duyệt reload, nhưng đủ ngắn để đảm bảo rằng nếu trạm đang bị dâng nước nhanh trong mưa bão, mực nước sẽ không thể dâng vượt quá dung tích hồ thu trước khi hệ thống tự động tiếp quản.
\end{itemize}

\subsection{Hành Vi Khôi Phục Kết Nối \& Quy Tắc Ghi Đè An Toàn Tối Cao}
\begin{itemize}
    \item \textbf{Khôi phục kết nối:} Khi mạng Wi-Fi được kết nối lại và trình duyệt gửi request tiếp theo, ESP32 sẽ trả về chuỗi JSON chứa trường cờ \texttt{"failsafe": true}. Giao diện Web Dashboard sẽ lập tức hiển thị một thanh thông báo màu cam với nội dung: *"Hệ thống đã tự động chuyển về chế độ AUTO do mất kết nối quá 30 giây"*. Để tiếp tục can thiệp thủ công, người vận hành bắt buộc phải nhấp nút xác nhận trên Web để chuyển lại sang MANUAL.
    \item \textbf{Quy tắc ghi đè an toàn tối cao (\textit{Safety Priority Override}):} Ngay cả khi đang ở chế độ MANUAL, nếu mực nước đo được đạt mức nguy cấp CRITICAL ($\ge 71\%$) mà sau $10\,\text{s}$ người vận hành không ra lệnh bật bơm hoặc mở van, hệ thống sẽ tự động tước quyền MANUAL, chuyển về AUTO và kích hoạt toàn bộ cơ cấu xả lũ hết công suất để chống tràn hồ.

\end{itemize}

\section{Phân Tích Đặc Tính Thời Gian Thực (Real-Time Performance Analysis)}

\subsection{Chu Kỳ Vòng Lặp Thực Tế \& Đánh Giá Độ Trễ}
Thời gian thực thi một chu kỳ vòng lặp \texttt{loop()} được đo đạc thực tế bằng hàm \texttt{micros()} trên vi điều khiển ESP32:
\begin{itemize}
    \item \textbf{Khi không có kết nối Web (Chu kỳ nền):} Thời gian chạy một vòng lặp chỉ mất $2 - 5\,\text{ms}$, phần lớn thời gian CPU ở trạng thái rảnh hoặc thực thi băm xung nhịp còi.
    \item \textbf{Tại chu kỳ trích mẫu cảm biến (mỗi $150\,\text{ms}$):} Mất khoảng $36 - 38\,\text{ms}$ (chủ yếu là thời gian đo xung ToF của cảm biến siêu âm qua hàm \texttt{pulseIn()}).
    \item \textbf{Khi xử lý yêu cầu HTTP JSON:} Mất khoảng $8 - 15\,\text{ms}$ để đọc thông số, định dạng chuỗi JSON và gửi qua ngăn xếp TCP/IP.
\end{itemize}

\subsection{Thời Gian Phản Ứng Tối Đa (Worst-Case Reaction Time - WCRT)}
\label{sec:wcrt_analysis}
Thời gian phản ứng tồi tệ nhất trong tình huống khẩn cấp ($T_{\text{WCRT\_urgent}}$) được tính từ thời điểm mực nước thực tế chạm ngưỡng nguy hiểm hoặc ngập tràn khẩn cấp cho tới khi tiếp điểm Relay đóng hoàn toàn để cấp điện cho máy bơm (không qua bộ lọc thời gian debounce hoặc khi debounce đã tích lũy đủ):
\begin{equation}
T_{\text{WCRT\_urgent}} = T_{\text{sample\_wait}} + T_{\text{filter\_typical}} + T_{\text{FSM}} + T_{\text{relay\_delay}}
\end{equation}
Trong đó:
\begin{itemize}
    \item $T_{\text{sample\_wait}} = 150\,\text{ms}$: Thời gian chờ tối đa giữa hai chu kỳ kích hoạt đọc cảm biến.
    \item $T_{\text{filter\_typical}} = 36\,\text{ms}$: Thời gian đo 3 mẫu siêu âm của bộ lọc trung vị trong điều kiện bình thường ($3 \times 12\,\text{ms}$).
    \item $T_{\text{FSM}} = 2\,\text{ms}$: Thời gian tính toán thuật toán FSM và cập nhật chân GPIO.
    \item $T_{\text{relay\_delay}} = 15\,\text{ms}$: Thời gian trễ cơ học để tiếp điểm lá đồng của Relay 5V đóng kín hoàn toàn mạch điện.
\end{itemize}
Tổng thời gian phản ứng khẩn cấp:
\begin{equation}
T_{\text{WCRT\_urgent}} = 150 + 36 + 2 + 15 = 203\,\text{ms} < 250\,\text{ms}
\end{equation}
Kết quả chứng minh hệ thống đáp ứng xuất sắc ràng buộc thời gian thực $\le 250\,\text{ms}$ đối với các tình huống phản ứng khẩn cấp, đảm bảo máy bơm được kích hoạt gần như tức thời khi nước vừa chạm ngưỡng tràn.

\noindent\textbf{Thời gian đáp ứng ổn định có lọc chống rung (\textit{Debounced Stable Transition}):}\\
Đối với quá trình chuyển trạng thái FSM thông thường giữa các cấp độ nhằm tránh rung tiếp điểm rơ-le do sóng vỗ dao động, điều kiện chuyển trạng thái cần được duy trì ổn định liên tục qua bộ lọc thời gian $t_{\text{debounce}} = 1.0\,\text{s}$. Do đó, thời gian đáp ứng tổng thể của hệ thống khi xác lập trạng thái chuyển cấp FSM bền vững là:
\begin{equation}
T_{\text{stable}} = T_{\text{WCRT\_urgent}} + t_{\text{debounce}} \approx 203\,\text{ms} + 1000\,\text{ms} \approx 1.203\,\text{s}
\end{equation}
Việc phân định rõ hai mốc thời gian này giúp hệ thống vừa bảo đảm an toàn cơ học cho rơ-le trong vận hành thông thường, vừa bảo đảm thời gian phát hiện và xử lý khẩn cấp dưới $250\,\text{ms}$.

\noindent\textbf{Phân tích độ trễ chặn luồng tối đa khi mất tín hiệu siêu âm:}\\
Cần lưu ý rằng hàm \texttt{pulseIn()} trong ESP32 Arduino Core là hàm chặn CPU (\textit{blocking}). Trong kịch bản xấu nhất khi cảm biến siêu âm bị mất xung Echo hoàn toàn, mỗi lượt đo sẽ phải chờ hết thời gian timeout $30\,\text{ms}$. Với bộ lọc 3 mẫu, CPU sẽ bị chặn tối đa $T_{\text{filter\_worst}} = 3 \times 30\,\text{ms} = 90\,\text{ms}$. Ngay cả trong kịch bản tồi tệ này, tổng thời gian chu kỳ quét vẫn nằm trong mức $150 + 90 + 2 = 242\,\text{ms} < 250\,\text{ms}$ trước khi rơi vào cơ chế bảo vệ giữ mẫu.

\subsection{Cơ Chế Phục Vụ Yêu Cầu Mạng Wi-Fi / HTTP}
Thư viện \texttt{WebServer.h} của ESP32 Arduino Core hoạt động theo kiến trúc đồng bộ tuần tự (\textit{synchronous polling}) trên cùng luồng chính \texttt{loopTask}. Trong hàm \texttt{loop()}, lời gọi \texttt{server.handleClient()} thực hiện kiểm tra và xử lý các kết nối socket TCP đang chờ từ lớp mạng lwIP. Trong điều kiện bình thường khi không có yêu cầu mới, hàm trả về quyền điều khiển rất nhanh ($< 0.1\,\text{ms}$), không ảnh hưởng đến chu kỳ đo lường.

Tuy nhiên, do hoạt động đồng bộ, nếu máy khách truyền dữ liệu chập chờn (\textit{slow client}) hoặc gửi yêu cầu vào đúng thời điểm vi điều khiển đang xử lý, thời gian chiếm dụng CPU có thể kéo dài $10 - 30\,\text{ms}$. Để triệt tiêu tối đa hiện tượng trễ vòng lặp này:
\begin{itemize}
    \item Toàn bộ dữ liệu phản hồi API JSON được thu gọn tối đa ($\approx 210$ byte), truyền trực tiếp trong một khung mạng TCP duy nhất.
    \item Trang Web Dashboard tĩnh được lưu trong bộ nhớ Flash và truyền phát bằng phương thức \texttt{server.send\_P()}, tránh hoàn toàn việc cấp phát bộ nhớ động RAM (heap) và giảm thiểu số vòng lặp chờ xử lý.
\end{itemize}

\subsection{Bảo Vệ Hệ Thống Bằng Phần Cứng Task Watchdog Timer (TWDT)}
Khác với cơ chế bảo vệ Failsafe $30\,\text{s}$ ở tầng ứng dụng mạng Web (Mục~\ref{sec:failsafe_mode}), để phòng ngừa tình huống vi điều khiển bị treo CPU do sốc điện, xung nhiễu nguồn hoặc bẫy lặp phần mềm vô hạn, FloodGuard tích hợp trực tiếp bộ giám sát Task Watchdog Timer (TWDT) của hệ điều hành thời gian thực ESP-IDF FreeRTOS.

Bộ giám sát TWDT được gắn vào tác vụ chính \texttt{loopTask} thông qua API \texttt{esp\_task\_wdt\_add(NULL)} với chu kỳ timeout được cấu hình là $3000\,\text{ms}$ ($3\,\text{s}$). Lệnh xóa cờ \texttt{esp\_task\_wdt\_reset()} được gọi đều đặn ở đầu mỗi chu kỳ \texttt{loop()}. Nếu sau $3\,\text{s}$ vòng lặp không thể quay lại điểm xóa cờ (ví dụ do hàm \texttt{pulseIn()} bị treo phần cứng hoặc hàm Web bị nghẽn socket), ngắt phần cứng TWDT sẽ ngay lập tức được kích hoạt, ghi lại nhật ký lỗi (core dump) và thực hiện Reset phần cứng tự động để đưa toàn bộ trạm về trạng thái an toàn ban đầu.

\section{Xử Lý Sự Cố \& Ma Trận An Toàn (Fault Handling Matrix)}

Bảng~\ref{tab:fault_matrix} tổng hợp toàn bộ các kịch bản lỗi phần cứng và phần mềm, cùng các phản ứng xử lý an toàn tương ứng được cài đặt sẵn trong firmware.

\begin{table}[H]
\centering
\caption{Ma trận xử lý sự cố và trạng thái an toàn của trạm FloodGuard}
\label{tab:fault_matrix}
\small
\renewcommand{\arraystretch}{1.3}
\begin{tabularx}{\textwidth}{|p{3.2cm}|p{3.8cm}|X|}
\hline
\textbf{Tình huống sự cố} & \textbf{Cơ chế phát hiện} & \textbf{Hành vi ứng phó an toàn của hệ thống} \\ \hline
\textbf{HC-SR04 mất xung Echo} (đứt dây, bám bẩn màng loa) & \texttt{pulseIn()} trả về $0$ hoặc quá timeout $30\,\text{ms}$. & Giữ mẫu hợp lệ gần nhất trong 3 chu kỳ ($450\,\text{ms}$). Nếu lỗi kéo dài $\ge 3$ chu kỳ: chuyển sang \texttt{SENSOR\_FAULT}, còi bíp cảnh báo lỗi, ngắt máy bơm tránh chạy cạn, mở van xả $50\%$ phòng ngừa ngập úng. Tự động phục hồi về FSM bình thường khi có $\ge 5$ mẫu siêu âm hợp lệ liên tiếp. \\ \hline
\textbf{Mực nước dâng vượt miệng cảm biến} ($d < d_{\text{full}}$) & Cảm biến đo khoảng cách $< 5.0\,\text{cm}$. & Đây là tình huống ngập tràn khẩn cấp (\textit{water surge}), hệ thống lập tức cưỡng chế FSM lên trạng thái \texttt{CRITICAL}, bật bơm hết công suất và mở van xả $100\%$ để thoát lũ, không xem là lỗi cảm biến. \\ \hline
\textbf{Khoảng cách ngoài dải đáy bể} ($d > d_{\text{empty}}$) & Cảm biến đo khoảng cách $> 50.0\,\text{cm}$. & Bể cạn hoàn toàn hoặc đáy sâu bất thường; hệ thống tự động kẹp (\textit{clamp}) giá trị về $0\%$, ngắt bơm ngay lập tức để chống chạy khô. \\ \hline
\textbf{Cảm biến mưa hở mạch / đứt dây tín hiệu AO} & Chân GPIO35 (Input-only, không pull-up nội) bị thả nổi. & Nếu thả nổi, ADC có thể đọc ngẫu nhiên về mức thấp kích hoạt nhầm \texttt{isSubmerged}. Thiết kế phần cứng bắt buộc gắn trở kéo ngoài $100\,\text{k}\Omega$ lên $3.3\,\text{V}$ để khi đứt dây, ADC luôn đọc $4095$ (khô ráo), hệ thống tự hành an toàn dựa vào mực nước siêu âm. \\ \hline
\textbf{Mất kết nối Wi-Fi / Đứt mạng Web Client} & Không nhận được gói tin heartbeat quá $30\,\text{s}$. & Tự động hủy chế độ MANUAL, cưỡng chế chuyển về AUTO, trao quyền cho FSM để tự hành chống tràn bể. \\ \hline
\textbf{Sụt áp nguồn cấp (Brown-out)} & Điện áp vi điều khiển tụt dưới ngưỡng $2.8\,\text{V}$. & Bộ giám sát Brown-out Reset nội của ESP32 tự động ngắt vi điều khiển và khởi động lại an toàn khi nguồn ổn định. \\ \hline
\end{tabularx}
\end{table}
