vuminhquan28/FloodGuard/report/main.pdf

### ĐẠI HỌC QUỐC GIA HÀ NỘI

## TRƯỜNG ĐẠI HỌC CÔNG NGHỆ

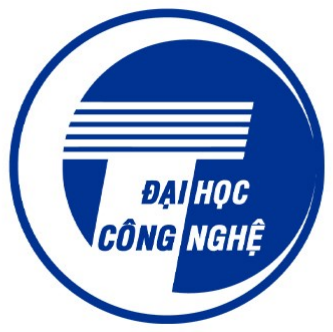
[picture p16: figure]

## BÁO CÁO BÀI TẬP LỚN

### MÔN: LẬP TRÌNH NHÚNG VÀ THỜI GIAN THỰC

ĐỀ TÀI:

FLOODGUARD: HỆ THỐNG GIÁM SÁT VÀ CHỐNG NGẬP TỰ

ĐỘNG THÔNG MINH

Ứng dụng Vi điều khiển ESP32, Thuật toán FSM & Web Dashboard Thời Gian Thực

Học phần: | Lập trình nhúng và thời gian thực
Mã học phần: | 2627I_INT3108_1

Sinh viên thực hiện: Vũ Minh Quân (23020142)

| Nguyễn Đức Huy (24020161)
| Phạm Đức Mạnh (24020222)
Học kỳ / Năm học: | Học kỳ 1 – 2026-2027

### Hà Nội, Tháng 10 Năm 2026

FloodGuard - Hệ Thống Chống Ngập Tự Động | ESP32 IoT Project

### BẢNG PHÂN CHIA CÔNG VIỆC VÀ TỶ LỆ ĐÓNG GÓP

Dự án FloodGuard: Hệ thống giám sát và chống ngập tự động thông minh được nghiên cứu và phát triển bởi nhóm gồm 03 sinh viên. Khối lượng công việc bao gồm thiết kế kiến trúc phần cứng, sơ đồ nguyên lý mạch điện, lập trình firmware vi điều khiển ESP32, xây dựng thuật toán điều khiển FSM, thiết kế giao diện Web Dashboard và biên soạn báo cáo kỹ thuật được phân chia đồng đều và bình đẳng giữa các thành viên:

STT | Tên sinh viên | Tỷ lệ đóng góp / Hoàn thành
1 | Vũ Minh Quân (23020142) | 100%
2 | Nguyễn Đức Huy (24020161) | 100%
3 | Phạm Đức Mạnh (24020222) | 100%
Đánh giá chung | | 100%

Cam kết trách nhiệm: Tất cả 03 thành viên trong nhóm đều tham gia chủ động, đóng góp bình đẳng và phối hợp chặt chẽ trong tất cả các giai đoạn triển khai đề tài, đảm bảo hoàn thành 100% khối lượng công việc được giao với chất lượng cao nhất.

Hà Nội, ngày 25 tháng 10 năm 2026

Đại diện nhóm sinh viên thực hiện

(Ký và ghi rõ họ tên)

i

# Mục lục

Bảng Phân Chia Công Việc & Tỷ Lệ Đóng Góp | i
1 Giới Thiệu Đề Tài & Phân Tích Yêu Cầu | 1
1.3.2 | Sơ Đồ Use Case Tổng Thể Hệ Thống & Đặc Tả Kiến Trúc Mô Hình | 4
1.4.1 | Đặc Tính & Ràng Buộc Thời Gian Thực (Real-Time Constraints) . 18
1.4.2 | Độ Tin Cậy, Watchdog & An Toàn Vận Hành (Safety & Reliability) 19
1.4.3 | Phân Tích An Ninh & Giới Hạn Bảo Mật (Security Analysis) . . . 19
2 Thiết Kế và Lắp Đặt Hệ Thống | 20

2.2 Giải Pháp Điều Khiển Qua Mạng Không Dây Cục Bộ Thay Cho Nút Nhấn

2.4.1 | Khối Chấp Hành Công Suất: Relay 5V, Diode Flyback & Nguồn
2.4.2 | Khối Cảm Biến: Bảo Vệ Điện Áp Echo & Chân Strapping GPIO 12 24
2.4.5 | Khối Máy Tính Vận Hành: Giao Tiếp Wi-Fi SoftAP & Cáp USB
3 Thuật Toán Điều Khiển & Vận Hành Phần Mềm Nhúng | 27
3.1.2 | Bảng Lập Lịch Tác Vụ Thời Gian Thực (Task Scheduling Matrix) . 28
3.1.3 | Lý Do Lựa Chọn Kiến Trúc millis() Phi Chặn Thay Cho delay()

ii

3.2.2 | Bộ Lọc Trung Vị 3 Mẫu (Median-of-3 Filter) & Phân Tích Độ Trễ . 30
3.2.3 | Ánh Xạ & Giới Hạn Giá Trị (Clamp/Constrain) Về Dải 0 − 100% . 31
3.2.4 | Bảng Ngưỡng Cảm Biến Mưa FC-37 & Cơ Sở Chọn Ngưỡng . . . . 31
3.3.2 | Bảng Ma Trận Chuyển Trạng Thái (State Transition Table) . . . . 33
3.4.1 | Phân Tích Cải Tiến Độ Rộng Dải Trễ (Hysteresis Bandwidth) . . . 36
3.4.2 | Cơ Chế Chống Rung Theo Thời Gian (Time-Based Debouncing &
3.4.4 | Thuật Toán Điều Khiển Mượt Servo Van Xả (Soft PWM Stepping) | 38
3.5.3 | Hành Vi Khôi Phục Kết Nối & Quy Tắc Ghi Đè An Toàn Tối Cao . 39
3.6 Phân Tích Đặc Tính Thời Gian Thực (Real-Time Performance Analysis) . 39
3.6.2 | Thời Gian Phản Ứng Tối Đa (Worst-Case Reaction Time - WCRT) 40
3.6.4 | Bảo Vệ Hệ Thống Bằng Phần Cứng Task Watchdog Timer (TWDT) 41
4 Giao Diện Web Dashboard & Tích Hợp Hệ Thống IoT | 43

4.4 Phân Tích Cải Tiến Thiết Kế API & Hạn Chế Của Phương Thức GET . . 47
4.4.1 | Phân Tích Rủi Ro Kỹ Thuật Khi Sử Dụng Phương Thức GET Cho
4.4.2 | Giải Pháp Chuẩn Hóa Kiến Trúc API Cho Phiên Bản Công Nghiệp 48
4.6.2 | Cập Nhật Lạc Quan (Optimistic UI Update) & Cảnh Báo Mất Mạng 50
4.7 Kỹ Thuật Lưu Trữ Web Dashboard Trong Flash & Tối Ưu Bộ Nhớ . . . . 50

iii

5 Hướng Dẫn Cài Đặt, Triển Khai và Vận Hành Hệ Thống | 52
5.1.2 | Cài Đặt Trình Điều Khiển Giao Tiếp Nạp Chip (USB-to-UART
5.3.1 | Quy Chuẩn Đấu Nối Phần Cứng & Dẫn Chiếu Sơ Đồ Nguyên Lý . 55
5.3.2 | Gia Công Mô Hình Mica Mini & Hiệu Chỉnh Dải Đo Thực Tế . . . 55
5.4.1 | Kiểm Thử Giao Diện Ngoại Tuyến (Offline Dashboard Preview) . . 57
5.4.2 | Kết Nối Mạng Wi-Fi Trạm & Truy Cập Hệ Thống Thực Tế . . . . 58
6 Kết Luận & Hướng Phát Triển | 62

iv

# Danh sách hình vẽ

1.1 Sơ đồ Use Case tổng thể hệ thống FloodGuard chuẩn hóa theo phân hệ

1.4 Sơ đồ phân rã Use Case UC03: Tự động điều khiển máy bơm thoát nước . 10

1.7 Sơ đồ phân rã Use Case UC06: Tự động chuyển an toàn khi mất mạng

1.9 Sơ đồ phân rã Use Case UC08: Giám sát trạng thái trạm qua Web Dashboard 15

1.11 Sơ đồ phân rã Use Case UC10: Can thiệp điều khiển thiết bị từ Web . . . 18

2.1 Sơ đồ nguyên lý mạch điện chuẩn IEC và phân vùng các khối chấp hành

3.1 Sơ đồ chuyển trạng thái máy trạng thái hữu hạn FSM của hệ thống Flood-

3.2 So sánh đáp ứng điều khiển máy bơm: Không có Hysteresis (A) và Có

4.2 Sơ đồ tuần tự (UML Sequence Diagram) hai luồng nghiệp vụ giám sát và

6.1 Phối cảnh tổng thể và bố trí cơ khí mô hình sa bàn Mica hoàn chỉnh của

6.2 Giao diện Web Dashboard trạm FloodGuard thực tế tại 4 cấp độ cảnh báo

6.3 Kiến trúc mở rộng đề xuất cho hệ thống FloodGuard tích hợp Cloud IoT

v

# Danh sách bảng

1.1 Bảng đặc tả kiến trúc Use Case tổng thể và ma trận phân bổ chức năng
hệ thống | | 6
1.2 Bảng đặc tả chi tiết Use Case UC01: Đọc và tiền xử lý dữ liệu cảm biến . . | 7
1.3 Bảng đặc tả chi tiết Use Case UC02: Tự động đánh giá FSM & Xử lý dải trễ 8 1.4 Bảng đặc tả chi tiết Use Case UC03: Tự động điều khiển máy bơm thoát
nước | 9
1.5 Bảng đặc tả chi tiết Use Case UC04: Tự động điều khiển van thoát lũ . . . 10 1.6 Bảng đặc tả chi tiết Use Case UC05: Phát tín hiệu cảnh báo tại trạm . . . 12 1.7 Bảng đặc tả chi tiết Use Case UC06: Tự động chuyển an toàn khi mất
mạng (Failsafe) | 13
1.8 Bảng đặc tả chi tiết Use Case UC07: Truyền nhận dữ liệu qua Web API . 14 1.9 Bảng đặc tả chi tiết Use Case UC08: Giám sát trạng thái trạm qua Web
Dashboard | 15
1.10 Bảng đặc tả chi tiết Use Case UC09: Chuyển đổi chế độ vận hành | 16
1.11 Bảng đặc tả chi tiết Use Case UC10: Can thiệp điều khiển thiết bị từ Web 17
2.1 Bảng phân công chân phần cứng trên vi điều khiển ESP32 | 22
3.1 Bảng lập lịch tác vụ thời gian thực của hệ thống FloodGuard | 28
3.2 Bảng phân cấp ngưỡng cảm biến lượng mưa FC-37 trên ESP32 ADC 12-bit 32 3.3 Bảng kết quả hiệu chuẩn cảm biến siêu âm HC-SR04 trên dải chuẩn 5−50 cm 32 3.4 Bảng ma trận chuyển trạng thái của thuật toán FSM kết hợp dải trễ
Hysteresis | 33
3.5 Bảng tín hiệu điều khiển đầu ra theo từng trạng thái FSM | 34
3.6 Ma trận xử lý sự cố và trạng thái an toàn của trạm FloodGuard | 42

4.1 Bảng đặc tả các giao diện lập trình ứng dụng HTTP REST API của trạm
FloodGuard | 46

5.1 Bảng quy cách cắt lắp mô hình sa bàn Mica 3 mm tối ưu cho cảm biến
HC-SR04 | 56
5.2 Ma trận kịch bản kiểm thử nghiệm thu chức năng hệ thống FloodGuard
(Thực hiện 10 lần lặp trên cả Wokwi và mô hình Mica thực tế) | 60
5.3 Cẩm nang chẩn đoán và khắc phục sự cố kỹ thuật thường gặp | 61

6.1 Bảng đối chiếu kết quả thực nghiệm với mục tiêu định lượng ban đầu . . . 64 6.2 Bảng tổng hợp các hạn chế kỹ thuật của đề tài và hướng khắc phục . . . . 68

vi

# Chương 1

# Giới Thiệu Đề Tài & Phân Tích Yêu Cầu

1.1 | Đặt Vấn Đề & Khảo Sát Hiện Trạng
1.1.1 | Bối Cảnh Thực Tiễn Về Ngập Úng Đô Thị

Hiện tượng ngập úng đô thị cục bộ vào mùa mưa bão đang là một trong những thách thức dân sinh và hạ tầng nghiêm trọng nhất tại các đô thị lớn ở Việt Nam, điển hình như Hà Nội và TP. Hồ Chí Minh. Các điểm trũng thấp như hầm chui dân sinh (hầm chui Đại lộ Thăng Long, Nguyễn Trãi), tầng hầm các tòa nhà chung cư, trung tâm thương mại và các tuyến phố trũng thấp thường xuyên bị ngập sâu từ 0.5 m đến hơn 1.2 m chỉ sau những trận mưa rào kéo dài 30 − 45 phút. Tình trạng này gây thiệt hại nặng nề về phương tiện giao thông, làm tê liệt hạ tầng đô thị, gây chập cháy thiết bị điện tử ngầm và tiềm ẩn nguy cơ đe dọa trực tiếp tính mạng con người.

### 1.1.2 Khảo Sát & Đánh Giá Các Giải Pháp Hiện Nay

Để ứng phó với ngập úng đô thị, các giải pháp giám sát và tiêu thoát nước hiện nay chủ yếu bao gồm:

Cơ chế phao cơ truyền thống: Sử dụng phao quả nổi đóng ngắt tiếp điểm điện cơ khí. Giải pháp này có ưu điểm chi phí thấp, tuy nhiên chỉ cung cấp thông tin nhị phân (ngập / cạn), không đo lường được tốc độ dâng nước, rất dễ kẹt rác cơ học và hoàn toàn không có khả năng giám sát hay cảnh báo sớm từ xa.

Hệ thống SCADA / PLC công nghiệp: Sử dụng các bộ điều khiển logic khả trình (PLC) kết hợp cảm biến radar công nghiệp và mạng truyền thông cáp quang. Mặc dù có độ tin cậy và độ bền công nghiệp rất cao, giải pháp này có chi phí đầu tư phần cứng và bản quyền phần mềm cực kỳ đắt đỏ (lên tới hàng trăm triệu đồng cho một điểm đo), kích thước cồng kềnh, tiêu thụ nhiều năng lượng và khó có thể phủ kín diện rộng tại hàng trăm điểm ngập nhỏ lẻ trong đô thị.

Hệ thống IoT nhúng dựa trên vi điều khiển: Đây là hướng tiếp cận hiện đại và tối ưu về mặt kinh tế kỹ thuật. Bằng việc ứng dụng các vi điều khiển thế hệ mới như ESP32 tích hợp sẵn kết nối không dây, hệ thống có thể thu nhỏ kích thước, tiết kiệm năng lượng, đo đạc thông số liên tục theo thời gian thực và cung cấp giao diện giám sát tiện lợi với chi phí phần cứng rất thấp.

### 1.1.3 Phạm Vi & Quy Mô Nghiên Cứu Của Đề Tài

Trong khuôn khổ học phần Lập trình nhúng và thời gian thực, đề tài tập trung nghiên cứu, thiết kế và chế tạo một mô hình thực nghiệm quy mô trạm quan trắc (Proof of Concept / Scale Model) mang tên FloodGuard. Mô hình mô phỏng khép kín toàn bộ chu trình vận hành của một trạm bơm tiêu thoát lũ thông minh: từ khâu đo đạc mực nước và lượng mưa, tiền xử lý tín hiệu số, thuật toán điều khiển máy trạng thái hữu hạn (FSM) kết hợp dải trễ, điều khiển cơ cấu chấp hành (bơm, van), cảnh báo đa giác quan tại trạm (LED, còi), đến giao diện giám sát và can thiệp điều khiển qua mạng không dây cục bộ.

## 1.2 Mục Tiêu Kỹ Thuật Định Lượng Của Dự Án

Hệ thống FloodGuard hướng tới các chỉ tiêu kỹ thuật định lượng cụ thể:

1. Độ chính xác đo lường mực nước: Sai số tuyệt đối đo khoảng cách qua cảm biến siêu âm ≤ ±1.0 cm trong dải đo làm việc thiết kế (5 − 50 cm trên cấu hình mô phỏng/bể chuẩn và 6 − 16 cm trên mô hình demo mica thu nhỏ); độ phân giải hiển thị mức nước 1% (0% − 100%).
2. Độ phân giải giám sát lượng mưa: Thu nhận tín hiệu tương tự (ADC) 12-bit phân giải ≈ 0.8 mV trên dải 0 − 3.3 V, phân loại 4 vùng trạng thái thời tiết qua 3 mốc ngưỡng (3200/1800/1100): Khô ráo, Mưa nhỏ, Mưa to và Ngập cảm biến.
3. Tính thời gian thực của thuật toán điều khiển (Worst-Case Reaction Time - WCRT): Thời gian phản ứng tức thời từ lúc mực nước vượt ngưỡng nguy cấp đến khi chân GPIO xuất tín hiệu đóng Relay máy bơm khẩn cấp (TWCRT_urgent) không vượt quá 250 ms (tính toán danh định đạt 203 ms ở chu kỳ trích mẫu Tsample = 150 ms). Với các chuyển trạng thái bậc thang thông thường có áp dụng bộ lọc chống rung thời gian Tdebounce = 1.0 s, thời gian ổn định là Tstable ≈ 1.2 s.
4. Chống rung giật cơ cấu chấp hành (Hysteresis & Debounce Guard): Áp dụng dải trễ Hysteresis biên độ 3% mực nước (41%/38%, 71%/68%, 21%/18%) kết hợp bộ lọc chống rung thời gian Debounce 1.0 s và thời gian chạy tối thiểu của máy bơm 5.0 s (Min-run Time), đảm bảo triệt tiêu hoàn toàn hiện tượng đóng/ngắt Relay liên tục (chattering) do sóng nước dập dềnh quanh biên ngưỡng.
5. Cảnh báo trực quan & âm thanh đa cấp độ: Cụm 3 đèn LED phản ánh trực tiếp 4 trạng thái vận hành; còi Active Buzzer 5 V phát xung âm thanh theo cơ chế phi chặn (Non-blocking) qua hàm millis() ở tần số cộng hưởng nội ≈ 2.3 kHz với 4 nhịp cảnh báo: Tắt (NORMAL) → Bíp thưa chu kỳ 1500 ms (WARNING) → Bíp dồn dập chu kỳ 400 ms (DANGER) → Hú liên tục (CRITICAL).
6. Hiệu năng giao tiếp mạng Web Dashboard: Chu kỳ cập nhật dữ liệu telemetry thời gian thực 1000 ms (1 s), độ trễ phản hồi API cục bộ 8 − 18 ms, tỷ lệ phục vụ thành công các yêu cầu API đạt ≥ 99.5% trên mạng Wi-Fi cục bộ ở cự ly 10 m.

7. Cơ chế bảo vệ an toàn tự trị (Failsafe Timeout): Khi ở chế độ thủ công (MANUAL), nếu mất kết nối điều khiển mạng quá 30 s, trạm tự động thu hồi quyền thủ công và chuyển về chế độ tự động (AUTO) để bảo vệ công trình chống tràn bể; đồng thời kích hoạt quy tắc ghi đè an toàn tối cao (Safety Override) nếu nước đạt mức CRITICAL quá 10 s.
1.3 | Mô Hình Hóa Use Case Hệ Thống Theo UML
1.3.1 | Phân Định Ranh Giới Hệ Thống & Danh Sách Tác Nhân

Mô hình hóa Use Case cho hệ thống FloodGuard được phân định rõ ràng giữa ranh giới phần mềm/phần cứng hệ thống và các tác nhân tương tác từ môi trường bên ngoài:

Ranh giới hệ thống (System Boundary): Mang tên Hệ Thống Trạm Flood-Guard (FloodGuard System). Ranh giới bao trọn toàn bộ khối phần mềm nhúng thực thi trên vi điều khiển ESP32 bao gồm: tác vụ thu thập cảm biến, thuật toán FSM, tác vụ tạo xung cảnh báo, máy chủ HTTP Web Server và cơ chế giám sát an toàn Failsafe. Các thành phần logic nội bộ (như bộ điều phối FSM hay Web Server) nằm hoàn toàn trong ranh giới và không đóng vai trò là tác nhân.

Tác nhân chính (Primary Actors):

1. Bộ Định Thời Timer / Watchdog (Internal Timer): Đóng vai trò là nguồn kích hoạt sự kiện thời gian thực định kỳ từ bên ngoài luồng logic chính, bao gồm bộ định thời chu kỳ đọc cảm biến 150 ms, bộ định thời chu kỳ thực thi FSM, và bộ đếm thời gian giám sát mất kết nối Failsafe (30 s).
2. Người Vận Hành (Human Operator): Nhân sự giám sát và vận hành tương tác trực tiếp với trạm từ thiết bị đầu cuối (điện thoại, máy tính) thông qua trình duyệt Web.

Tác nhân phụ / Thiết bị ngoại vi (Secondary Actors / Devices):

1. «device» Cảm biến siêu âm HC-SR04 & Cảm biến mưa FC-37: Thiết bị đầu vào cung cấp tín hiệu xung thời gian phản hồi (Echo) và điện áp tương tự (AO) / mức logic (DO).
2. «device» Module Relay 5V & Máy bơm mini: Cơ cấu chấp hành động lực tiếp nhận tín hiệu kích mức logic để đóng/ngắt nguồn động cơ bơm.
3. «device» Động cơ Servo SG90: Cơ cấu chấp hành cơ khí tiếp nhận tín hiệu điều chế độ rộng xung (PWM) để định vị góc mở cửa van xả lũ (0

◦

, 90◦

, 180◦
).
4. «device» Cụm 3 Đèn LED & Còi Buzzer 5V: Thiết bị chỉ thị tại chỗ tiếp nhận tín hiệu logic và xung nhịp cảnh báo.
5. Người Dân Quanh Trạm (Human Actor): Tác nhân thụ hưởng tiếp nhận tín hiệu âm thanh còi hú và ánh sáng đèn LED cảnh báo nguy hiểm tại thực địa trạm.

1.3.2 | Sơ Đồ Use Case Tổng Thể Hệ Thống & Đặc Tả Kiến Trúc
| Mô Hình

Mô hình Use Case tổng thể của trạm FloodGuard được tổ chức khoa học nhằm phân định rõ ràng giữa ranh giới hệ thống phần mềm nhúng và môi trường tương tác bên ngoài. Sơ đồ phân tách thành hai phân hệ chức năng độc lập về mặt logic nhưng phối hợp đồng bộ thông qua bộ nhớ trạng thái chung (Hình 1.1):

1. Phân hệ Giám sát & Điều khiển Tự động Tại Chỗ (Autonomous Core Subsystem): Bao gồm 6 ca sử dụng cốt lõi (từ UC01 đến UC06). Phân hệ này chịu sự kích hoạt định kỳ từ Bộ Định Thời Timer / Watchdog và các tín hiệu vật lý từ Cảm biến siêu âm, Cảm biến mưa. Mọi tác vụ từ thu thập dữ liệu, đánh giá máy trạng thái hữu hạn (FSM), xử lý dải trễ Hysteresis, điều khiển cơ cấu chấp hành (bơm, van) và phát cảnh báo tại trạm (LED, còi) đều vận hành hoàn toàn tự trị theo thời gian thực (150 ms), không phụ thuộc vào tình trạng kết nối mạng Wi-Fi.
2. Phân hệ Giám sát & Điều khiển Từ Xa Qua Web (Remote Web Telemetry Subsystem): Bao gồm 4 ca sử dụng (từ UC07 đến UC10). Phân hệ này chịu sự kích hoạt trực tiếp từ Người Vận Hành thông qua trình duyệt Web. Người dùng có thể giám sát dữ liệu đo thời gian thực, chuyển đổi linh hoạt giữa chế độ AUTO và MANUAL, đồng thời can thiệp cưỡng chế trạng thái bật/tắt máy bơm và góc mở van xả.

Toàn bộ đường truyền liên kết giữa các tác nhân và ca sử dụng được quy hoạch theo dạng trục xương cá (Bus Spine Line), loại bỏ hoàn toàn hiện tượng giao cắt chéo rối mắt, đảm bảo chuẩn mực trực quan cao nhất của ngôn ngữ UML.


Hình 1.1: Sơ đồ Use Case tổng thể hệ thống FloodGuard chuẩn hóa theo phân hệ chức năng

Để cung cấp góc nhìn tổng quan toàn diện về kiến trúc chức năng, Bảng 1.1 đặc tả ma trận phân bổ 10 ca sử dụng, xác định rõ phân hệ phụ trách, tác nhân kích hoạt, tác nhân thụ hưởng và các cơ chế an toàn liên quan.

Bảng 1.1: Bảng đặc tả kiến trúc Use Case tổng thể và ma trận phân bổ chức năng hệ thống

ID | Tên Use Case | Tác nhân kích hoạt

Tác nhân phụ / Ngoại vi &
Luồng thực thi

Ràng buộc
an toàn
I. PHÂN HỆ TỰ ĐỘNG TẠI CHỖ (AUTONOMOUS CORE)
UC01 | Đọc & tiền xử lý cảm biến | Timer chu kỳ 150 ms | Cảm biến HC-SR04, FC-37; đo Echo, lọc trung vị 3 mẫu, đọc ADC mưa. | Giữ mẫu 3 chu kỳ (450 ms); tràn bờ kích CRITICAL.
UC02 | Tự động đánh giá FSM | Timer chu kỳ 150 ms | Thuật toán FSM 4 trạng thái; đánh giá % nước và mưa đón đầu lũ. | Hysteresis 3%, Debounce 1.0 s, Min-run 5 s.
UC03 | Tự động điều khiển bơm | Timer chu kỳ FSM | Module Relay 5V, Bơm mini; Gen-eralization (Bật / Ngắt bơm). | Bơm chỉ chạy khi nước ≥ 20%; ngắt an toàn khi sự cố.
UC04 | Tự động điều khiển van | Timer chu kỳ FSM | Động cơ Servo SG90, Cửa van trượt; Generalization (0 ◦ / 90◦ / 180◦ ). | Vận tốc xoay mượt 15◦/20 ms; góc an toàn 90◦ .
UC05 | Phát cảnh báo tại trạm | Timer chu kỳ FSM | Cụm 3 LED, Còi Buzzer 5V, Người dân quanh trạm; băm xung phi chặn. | Duy trì cảnh báo liên tục ở cả AUTO và MANUAL.
UC06 | Tự động chuyển Failsafe | Watchdog Timer (30 s) | Người vận hành (nhận tin); giám sát khoảng cách gói tin Web. | Tự thu hồi MANUAL về AUTO khi mất mạng > 30 s.

II. PHÂN HỆ GIÁM SÁT TỪ XA QUA WEB (REMOTE TELEMETRY)
UC07 | Truyền nhận dữ liệu Web API | Người vận hành (Web) | Máy chủ ESP32; Generaliza-tion (GET /api/status và GET /api/control). | Tham số điều khiển tường minh; thời gian RTT < 20 ms.
UC08 | Giám sát qua Web Dashboard | Người vận hành (Web) | Trình duyệt Web; giao diện Glass-morphism render % nước, thẻ động. | Polling định kỳ 1000 ms; tương thích chuẩn Responsive.
UC09 | Chuyển đổi AUTO / MAN-UAL | Người vận hành (Web) | Giao diện Dashboard; Generaliza-tion (Chuyển sang AUTO / MAN-UAL). | Khóa/mở khóa nút can thiệp cưỡng chế tương ứng.
UC10 | Can thiệp điều khiển thiết bị | Người vận hành (Web) | Relay Bơm, Servo; quan hệ «ex-tend» (Bật/tắt bơm, xoay van tùy ý). | Tiền điều kiện MANUAL; Safety Over-ride sau 10 s nếu CRITI-CAL.

### 1.3.3 Sơ Đồ Phân Rã & Đặc Tả Chi Tiết Từng Use Case

Dưới đây là đặc tả chi tiết và sơ đồ phân rã theo chuẩn UML cho toàn bộ 10 ca sử dụng của hệ thống:

UC01: Đọc và Tiền Xử Lý Dữ Liệu Cảm Biến

Ca sử dụng UC01 chịu trách nhiệm thu thập tín hiệu vật lý từ môi trường và chuyển hóa thành dữ liệu số có độ tin cậy cao phục vụ thuật toán điều khiển (Bảng 1.2).

Bảng 1.2: Bảng đặc tả chi tiết Use Case UC01: Đọc và tiền xử lý dữ liệu cảm biến

Mã Use Case | UC01
Tên Use Case | Đọc và tiền xử lý dữ liệu cảm biến
Tác nhân chính | Bộ định thời chu kỳ lấy mẫu (Tsample = 150 ms)
Tác nhân phụ | Cảm biến siêu âm HC-SR04, Cảm biến mưa FC-37
Mục tiêu | Đo đạc chính xác khoảng cách mặt nước hồ thu, lọc sóng dập dềnh và phân cấp lượng mưa
Tiền điều kiện | Phần cứng vi điều khiển, mạch phân áp Echo (5 V → 3.3 V) và cảm biến đã cấp nguồn ổn định
Hậu điều kiện | Cập nhật các biến toàn cục waterPercent, waterDistanceCm, rainVal, isHeavyRain, isSubmerged
Luồng sự kiện chính | 1. Bộ định thời kích hoạt chu kỳ đo đạc 150 ms. 2. Kích chân Trig với xung vuông mức HIGH 10 µs, đo thời gian phản xạ Echo qua pulseIn(). 3. Thu thập 3 mẫu ToF liên tiếp (mỗi mẫu cách nhau 12 ms), áp dụng bộ lọc trung vị (Median-of-3 ) loại bỏ nhiễu ngoại lai. 4. Ánh xạ khoảng cách thực sang phần trăm mực nước 0% −100% theo dải chuẩn 5 − 50 cm (sa bàn mica: 6 − 16 cm). 5. Đọc điện áp tương tự qua ADC 12-bit (GPIO 35) và chân số DO (GPIO 34) từ cảm biến mưa FC-37.
Luồng ngoại lệ | - Mất tín hiệu Echo (> 30 ms): Áp dụng kỹ thuật giữ mẫu cũ (Sample-and-Hold). Nếu lỗi kéo dài quá 3 chu kỳ liên tiếp (> 450 ms), chuyển FSM sang SENSOR_FAULT. - Nước ngập tràn sát cảm biến (< dfull): Nhận diện tràn bờ khẩn cấp, lập tức kích hoạt trạng thái CRITICAL (bật bơm và mở van 100%) thay vì báo lỗi cảm biến. - Khoảng cách đo vượt đáy bể (> dempty): Kẹp cứng giá trị về 0% để bảo vệ chống chạy khô máy bơm.
Ràng buộc phi chức năng | Thời gian thực thi toàn chu kỳ đo ≤ 36 ms; sai số đo mực nước ≤ ±0.5 cm.

Sơ đồ phân rã của ca sử dụng UC01 được minh họa trong Hình 1.2. Trong mỗi chu kỳ, ca sử dụng luôn bao hàm ba tác vụ con thông qua quan hệ «include»: đo khoảng cách siêu âm, lọc trung vị 3 mẫu và phân cấp ngưỡng mưa ADC.


Hình 1.2: Sơ đồ phân rã Use Case UC01: Đọc và tiền xử lý dữ liệu cảm biến

UC02: Tự Động Đánh Giá Trạng Thái FSM & Xử Lý Dải Trễ (Hysteresis)

Ca sử dụng UC02 là bộ não điều phối của hệ thống, thực thi thuật toán máy trạng thái hữu hạn để chuyển cấp cảnh báo dựa trên mực nước và tình trạng mưa lũ (Bảng 1.3).

Bảng 1.3: Bảng đặc tả chi tiết Use Case UC02: Tự động đánh giá FSM & Xử lý dải trễ

Mã Use Case | UC02
Tên Use Case | Tự động đánh giá trạng thái FSM & Xử lý dải trễ (Hysteresis)
Tác nhân chính | Bộ định thời chu kỳ logic FSM (Tfsm = 150 ms)
Tác nhân phụ | Không có (thực thi logic nội bộ)
Mục tiêu | Đánh giá phân cấp nguy cơ ngập lụt qua 4 trạng thái, triệt tiêu hiện tượng rung giật đóng ngắt cơ cấu chấp hành
Tiền điều kiện | Biến waterPercent và trạng thái cảm biến mưa đã được cập nhật bởi UC01
Hậu điều kiện | Biến trạng thái hệ thống sysState được cập nhật, sẵn sàng kích hoạt các phân hệ chấp hành
Luồng sự kiện chính | 1. Đối chiếu % mực nước với các cặp ngưỡng vào/thoát: 21%/18% (WARNING), 41%/38% (DANGER), và 71%/68% (CRITICAL). 2. Áp dụng dải trễ biên độ ∆ = 3% kết hợp bộ lọc thời gian duy trì Tdebounce = 1.0 s trước khi quyết định đổi trạng thái. 3. Tích hợp dữ liệu lượng mưa đóng vai trò nâng cấp đón đầu lũ (Surge Anticipation): khi có mưa to (ADC < 1800) hoặc ngập cảm biến (ADC < 1100), chủ động đẩy trạng thái lên DANGER hoặc CRITI-CAL.
Luồng ngoại lệ | - Nếu cờ lỗi sensorFault == true, FSM chuyển ngay sang trạng thái an toàn SENSOR_FAULT. - Phục hồi về vận hành tự động bình thường khi nhận lại ≥ 5 mẫu đo ToF hợp lệ liên tiếp.
Ràng buộc an toàn | Máy bơm chỉ được phép bật khi mực nước ≥ 20% để chống hiện tượng cháy bơm do chạy khô; thời gian chạy tối thiểu của bơm Tmin_run ≥ 5.0 s.

Sơ đồ phân rã của UC02 thể hiện qua quan hệ bao gồm («include») giữa tác vụ đánh giá 4 trạng thái FSM và cơ chế dải trễ Hysteresis chống rung (Hình 1.3).


Hình 1.3: Sơ đồ phân rã Use Case UC02: Tự động đánh giá FSM & Dải trễ

UC03: Tự Động Điều Khiển Máy Bơm Thoát Nước

Ca sử dụng UC03 quản lý việc đóng/ngắt nguồn động lực máy bơm mini 5 V qua tiếp điểm Relay dựa trên trạng thái FSM (Bảng 1.4).

Bảng 1.4: Bảng đặc tả chi tiết Use Case UC03: Tự động điều khiển máy bơm thoát nước

Mã Use Case | UC03
Tên Use Case | Tự động điều khiển máy bơm thoát nước
Tác nhân chính | Bộ định thời chu kỳ FSM
Tác nhân phụ | Module Relay 5V (Active LOW), Máy bơm nước mini 5V
Mục tiêu | Đóng ngắt máy bơm an toàn, bơm cưỡng bức thoát nước khi ngập lụt, chống quá nhiệt tiếp điểm
Tiền điều kiện | Chế độ vận hành tự động (isAutoMode == true)
Hậu điều kiện | Máy bơm được bật (Relay kích LOW) hoặc ngắt (Relay thả nổi High-Z)
Luồng sự kiện chính | Phân nhánh chuyên biệt hóa (Generalization) kế thừa từ UC03: – Nhánh 1 (Kích Bật Bơm): Khi FSM đạt mức DANGER hoặc CRITICAL (và nước ≥ 20%), vi điều khiển cấu hình chân GPIO 23 sang OUTPUT và xuất mức logic LOW (0 V) để kích dẫn optocoupler, đóng tiếp điểm Relay cấp điện cho máy bơm. – Nhánh 2 (Ngắt Bơm An Toàn): Khi FSM ở mức NORMAL hoặc WARNING, vi điều khiển cấu hình chân GPIO 23 sang chế độ INPUT (thả nổi High-Impedance) để triệt tiêu hoàn toàn dòng rò quang học qua optocoupler, bảo đảm tiếp điểm Relay nhả dứt khoát.
Luồng ngoại lệ | Khi có lỗi cảm biến SENSOR_FAULT, máy bơm lập tức bị ngắt cưỡng bức để bảo vệ chống chạy khô.
Ràng buộc cơ học | Bộ đếm thời gian kiểm tra thời gian hoạt động liên tục: nếu bơm vừa bật, không được ngắt trước khi đạt Tmin_run ≥ 5.0 s.

Sơ đồ phân rã ca sử dụng UC03 thể hiện cấu trúc chuyên biệt hóa (Hình 1.4).


Hình 1.4: Sơ đồ phân rã Use Case UC03: Tự động điều khiển máy bơm thoát nước

UC04: Tự Động Điều Khiển Van Thoát Lũ

Ca sử dụng UC04 điều khiển góc xoay của động cơ Servo SG90 để đóng/mở cửa xả lũ theo 3 cấp độ tỷ lệ (Bảng 1.5).

Bảng 1.5: Bảng đặc tả chi tiết Use Case UC04: Tự động điều khiển van thoát lũ

Mã Use Case | UC04
Tên Use Case | Tự động điều khiển van thoát lũ
Tác nhân chính | Bộ định thời chu kỳ FSM
Tác nhân phụ | Động cơ Servo SG90 (GPIO 13), Cửa van trượt xả lũ
Mục tiêu | Điều tiết lưu lượng xả lũ tự nhiên theo từng cấp độ nguy cơ ngập lụt
Tiền điều kiện | Chế độ vận hành tự động (isAutoMode == true); nguồn xung cấp cho Servo ổn định
Hậu điều kiện | Cửa van di chuyển đến góc mở tương ứng với trạng thái FSM
Luồng sự kiện chính | Phân nhánh chuyên biệt hóa 3 trạng thái góc mở: ◦ (0%): Áp dụng khi hệ thống ở mức NORMAL hoặc – Đóng van 0 WARNING (mực nước an toàn, giữ nước hồ chứa). – Mở van 50% (Góc 90◦ ): Áp dụng khi FSM ở mức DANGER để bắt đầu điều tiết thoát lũ lưu lượng vừa. – Mở van 100% (Góc 180◦ ): Áp dụng khi FSM ở mức CRITICAL để giải phóng áp lực nước tối đa qua cống.
Luồng ngoại lệ | Khi rơi vào sự cố SENSOR_FAULT, cửa van tự động định vị ở góc mở an toàn 50% (90◦ ) để phòng ngừa dâng tràn thụ động.
Ràng buộc kỹ thuật | Xung điều chế độ rộng PWM tần số 50 Hz; góc xoay biến thiên với vận tốc mượt 15◦/20 ms tránh hiện tượng giật cơ khí và sụt áp nguồn.

Sơ đồ phân rã Use Case UC04 được thể hiện trong Hình 1.5.


Hình 1.5: Sơ đồ phân rã Use Case UC04: Tự động điều khiển van thoát lũ

UC05: Phát Tín Hiệu Cảnh Báo Tại Trạm (LED & Còi Buzzer)

Ca sử dụng UC05 phát tín hiệu quang học và âm thanh cảnh báo tại chỗ cho người dân và kỹ thuật viên tại trạm (Bảng 1.6).

Bảng 1.6: Bảng đặc tả chi tiết Use Case UC05: Phát tín hiệu cảnh báo tại trạm

Mã Use Case | UC05
Tên Use Case | Phát tín hiệu cảnh báo tại trạm (LED & Còi Buzzer)
Tác nhân chính | Bộ định thời chu kỳ FSM
Tác nhân phụ | Cụm 3 đèn LED màu (Xanh, Vàng, Đỏ), Còi Active Buzzer 5V, Người dân quanh trạm
Mục tiêu | Cung cấp tín hiệu cảnh báo đa giác quan rõ nét, kịp thời, không chiếm dụng CPU
Tiền điều kiện | Chân GPIO điều khiển LED (21, 19, 18) và Buzzer (4) đã được cấu hình OUTPUT
Hậu điều kiện | Đèn LED sáng đúng màu quy định; còi phát xung âm thanh theo nhịp tương ứng
Luồng sự kiện chính | 1. Chỉ thị LED quang học: – NORMAL: Bật LED Xanh (GPIO 21), tắt LED Vàng và Đỏ. – WARNING: Bật LED Vàng (GPIO 19), tắt LED Xanh và Đỏ. – DANGER: Bật LED Đỏ (GPIO 18), tắt LED Xanh và Vàng. – CRITICAL: Nhấp nháy LED Đỏ chu kỳ nhanh 100 ms. 2. Kích âm còi báo động phi chặn (Non-blocking Buzzer): – NORMAL: Tắt còi hoàn toàn (0 V). – WARNING: Bíp thưa nhịp 1500 ms (120 ms ON / 1380 ms OFF). – DANGER: Bíp dồn dập chu kỳ 400 ms (150 ms ON / 250 ms OFF). – CRITICAL: Hú liên tục tại tần số cộng hưởng nội ≈ 2.3 kHz của Active Buzzer.
Luồng ngoại lệ | Khi có lỗi SENSOR_FAULT, cả 3 đèn LED nhấp nháy đồng thời và còi bíp ngắt quãng báo sự cố kỹ thuật.
Ràng buộc an toàn | Khối cảnh báo thực địa (LED và còi) luôn duy trì liên tục ở cả hai chế độ AUTO và MANUAL dựa theo mực nước thực tế để bảo vệ an toàn cho người dân quanh trạm.

Sơ đồ phân rã ca sử dụng UC05 được trình bày trong Hình 1.6.

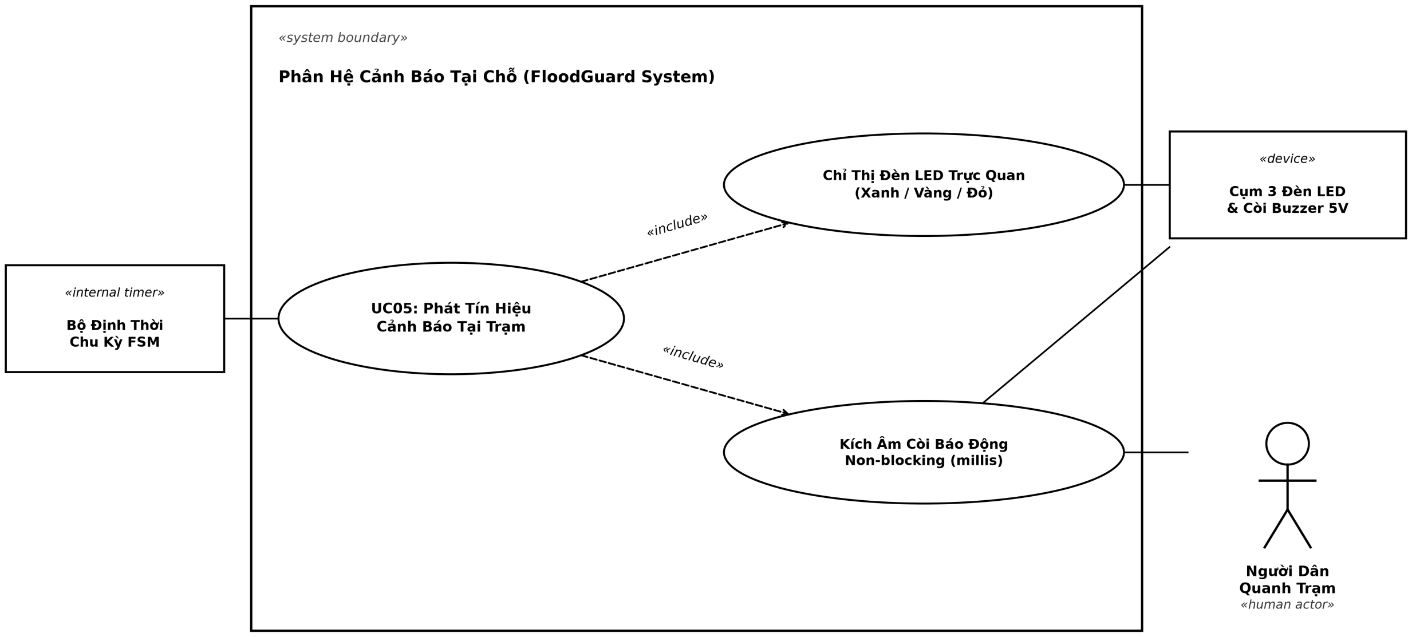
[picture p17: figure]

Hình 1.6: Sơ đồ phân rã Use Case UC05: Phát tín hiệu cảnh báo tại trạm

UC06: Tự Động Chuyển Đổi An Toàn Khi Mất Kết Nối Mạng (Failsafe)

Ca sử dụng UC06 đảm bảo tính tự trị an toàn cao nhất, ngăn ngừa sự cố bỏ quên hệ thống ở chế độ thủ công (Bảng 1.7).

Bảng 1.7: Bảng đặc tả chi tiết Use Case UC06: Tự động chuyển an toàn khi mất mạng (Failsafe)

Mã Use Case | UC06
Tên Use Case | Tự động chuyển đổi an toàn khi mất kết nối mạng (Network Failsafe)
Tác nhân chính | Bộ giám sát thời gian kết nối Heartbeat Watchdog
Tác nhân phụ | Người vận hành (nhận thông báo cảnh báo khi tái lập kết nối)
Mục tiêu | Tự động thu hồi quyền thủ công và hoàn nguyên trạm về chế độ tự động an toàn khi xảy ra mất kết nối Web
Tiền điều kiện | Hệ thống đang vận hành ở chế độ thủ công (isAutoMode == false)
Hậu điều kiện | Hệ thống chuyển về isAutoMode = true, quyền điều khiển được trao trả hoàn toàn cho FSM
Luồng sự kiện chính | 1. Hệ thống đếm thời gian trôi qua kể từ gói tin HTTP request gần nhất nhận được từ Dashboard: ∆t = millis() − lastClientRequestTime. 2. Nếu ∆t > 30000 ms (30 s), bộ giám sát kích hoạt ngắt sự kiện Failsafe Timeout. 3. Tự động thiết lập isAutoMode = true, ghi log sự cố và bật cờ thông báo failsafeTriggered = true. 4. Khi trình duyệt Web kết nối lại và gửi yêu cầu, giao diện hiển thị cảnh báo đỏ nổi bật về việc hệ thống đã tự động chuyển đổi an toàn.
Phục hồi quyền | Người vận hành phải chủ động nhấp nút xác nhận trên giao diện Web Dashboard mới có thể tiếp quản lại quyền điều khiển thủ công.
Ràng buộc kỹ thuật | Bộ đếm thời gian thực hiện phi chặn, độc lập với luồng Web Server và vòng lặp FSM.

Sơ đồ phân rã Use Case UC06 được mô tả trong Hình 1.7.

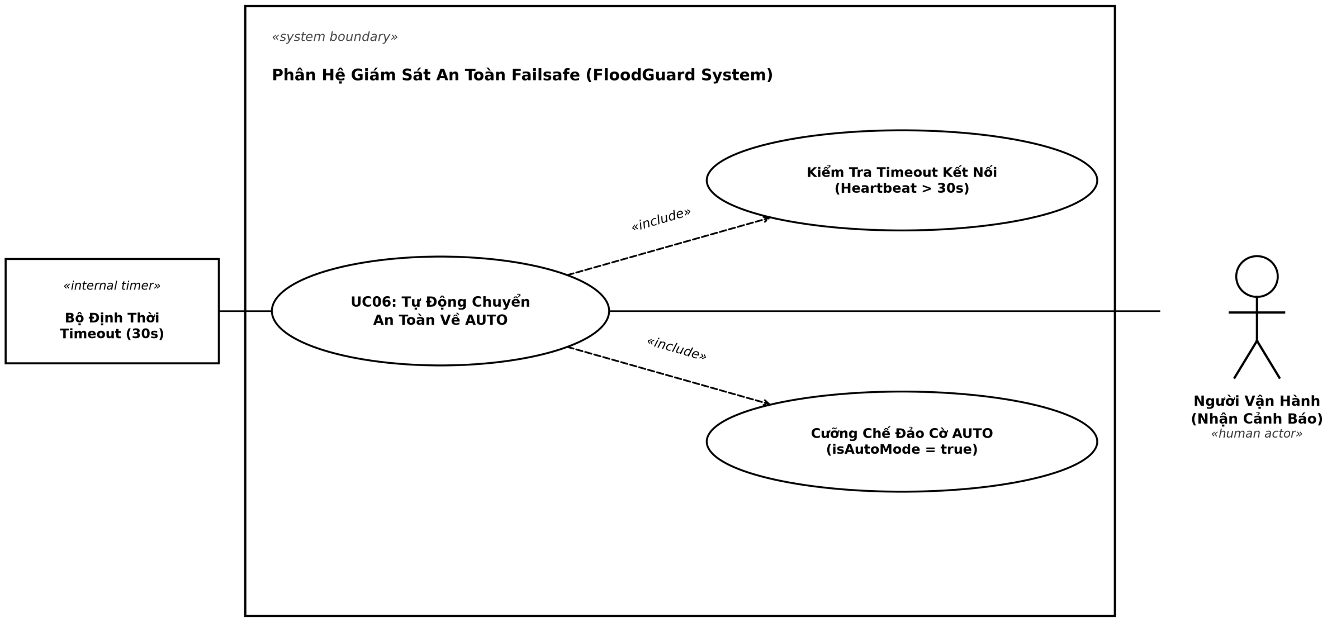
[picture p18: figure]

Hình 1.7: Sơ đồ phân rã Use Case UC06: Tự động chuyển an toàn khi mất mạng (Failsafe)

UC07: Truyền Nhận Dữ Liệu Qua Giao Thức Web API

Ca sử dụng UC07 xây dựng tầng giao tiếp truyền thông REST API giữa máy chủ Web Server nhúng trên vi điều khiển ESP32 và máy khách (Bảng 1.8).

Bảng 1.8: Bảng đặc tả chi tiết Use Case UC07: Truyền nhận dữ liệu qua Web API

Mã Use Case | UC07
Tên Use Case | Truyền nhận dữ liệu qua giao thức Web API
Tác nhân chính | Người vận hành (thông qua trình duyệt Web)
Tác nhân phụ | Máy chủ Web Server nhúng trên ESP32
Mục tiêu | Cung cấp cổng truyền nhận dữ liệu telemetry và tiếp nhận lệnh can thiệp thời gian thực chuẩn JSON
Tiền điều kiện | Máy khách đã kết nối vào mạng Wi-Fi SoftAP FloodGuard_AP thành công
Hậu điều kiện | Trả về dữ liệu telemetry hoặc cập nhật tham số điều khiển vi điều khiển
Luồng sự kiện chính | Phân nhánh chuyên biệt hóa 2 endpoint API độc lập: – Yêu cầu dữ liệu trạng thái (GET /api/status): Trình duyệt gửi request polling định kỳ 1000 ms; vi điều khiển thu thập thông số tức thời, đóng gói chuỗi JSON (≈ 210 bytes chứa % nước, khoảng cách cm, cấp độ mưa, trạng thái bơm, van, còi, chế độ AUTO/MANUAL) và phản hồi HTTP 200. – Tiếp nhận lệnh điều khiển (GET /api/control): Trình duyệt gửi lệnh chứa tham số tường minh (mode=auto/manual, pump=1/0/toggle, valve=0/50/100); vi điều khiển bóc tách cú pháp và thực thi cập nhật phần cứng.
Ràng buộc hiệu năng | Kích thước gói tin JSON nhỏ gọn; thời gian trễ phản hồi RTT khứ hồi < 20 ms trong phạm vi 15 m.

Sơ đồ phân rã Use Case UC07 được minh họa trong Hình 1.8.


Hình 1.8: Sơ đồ phân rã Use Case UC07: Truyền nhận dữ liệu qua Web API

UC08: Giám Sát Trạng Thái Trạm Qua Web Dashboard

Ca sử dụng UC08 trực quan hóa dữ liệu telemetry lên giao diện Web đồ họa hiện đại (Bảng 1.9).

Bảng 1.9: Bảng đặc tả chi tiết Use Case UC08: Giám sát trạng thái trạm qua Web Dashboard

Mã Use Case | UC08
Tên Use Case | Giám sát trạng thái trạm qua Web Dashboard
Tác nhân chính | Người vận hành
Tác nhân phụ | Trình duyệt Web (Chrome, Safari, Firefox...)
Mục tiêu | Hiển thị trực quan, sinh động toàn bộ tham số vận hành của trạm theo thời gian thực
Tiền điều kiện | Người vận hành truy cập địa chỉ http://192.168.4.1 hoặc http://floodguard.local
Hậu điều kiện | Giao diện Dashboard được render đầy đủ và cập nhật liên tục mỗi giây
Luồng sự kiện chính | 1. Trình duyệt tải mã nguồn giao diện Dark Glassmorphism lưu trữ trong bộ nhớ Flash PROGMEM (≈ 14.2 KB). 2. Khởi tạo vòng lặp AJAX Fetch tự động gửi yêu cầu GET /api/status mỗi 1000 ms. 3. Cập nhật đồ họa thanh tiến trình mực nước dải 0 − 100% kèm màu sắc chuyển đổi linh hoạt (Xanh → Vàng → Đỏ). 4. Hiển thị thẻ thông tin khoảng cách siêu âm (cm) và cấp độ mưa thực tế (Không mưa / Mưa nhỏ / Mưa to / Ngập cảm biến). 5. Hiển thị huy hiệu trạng thái FSM hiện tại, chỉ báo trạng thái bật/tắt máy bơm, góc mở van xả lũ và còi báo động.
Ràng buộc giao diện | Tương thích chuẩn Responsive Web Design trên cả máy tính xách tay và điện thoại thông minh.

Sơ đồ phân rã Use Case UC08 được trình bày trong Hình 1.9.


Hình 1.9: Sơ đồ phân rã Use Case UC08: Giám sát trạng thái trạm qua Web Dashboard

UC09: Chuyển Đổi Chế Độ Vận Hành (AUTO / MANUAL)

Ca sử dụng UC09 quản lý việc chuyển giao quyền điều hành hệ thống giữa thuật toán FSM tự động và người vận hành (Bảng 1.10).

Bảng 1.10: Bảng đặc tả chi tiết Use Case UC09: Chuyển đổi chế độ vận hành

Mã Use Case | UC09
Tên Use Case | Chuyển đổi chế độ vận hành (AUTO / MANUAL)
Tác nhân chính | Người vận hành
Tác nhân phụ | Giao diện Web Dashboard, Vi điều khiển ESP32
Mục tiêu | Cho phép chuyển đổi linh hoạt và an toàn giữa chế độ tự động hoàn toàn và chế độ can thiệp thủ công
Tiền điều kiện | Người vận hành đang mở trang Web Dashboard có kết nối ổn định
Hậu điều kiện | Biến isAutoMode được cập nhật trên vi điều khiển; giao diện thay đổi trạng thái nút bấm
Luồng sự kiện chính | Phân nhánh chuyên biệt hóa hai trạng thái chế độ: – Chuyển sang chế độ AUTO: Người vận hành gạt nút chuyển về AUTO; gửi lệnh GET /api/control?mode=auto. Hệ thống khóa toàn bộ các nút can thiệp cưỡng chế trên Dashboard, trao toàn quyền quyết định phần cứng cho thuật toán FSM. – Chuyển sang chế độ MANUAL: Người vận hành gạt nút chuyển sang MANUAL; gửi lệnh GET /api/control?mode=manual. Hệ thống mở khóa các nút bật/tắt bơm và chọn góc mở van, đồng thời bắt đầu kích hoạt bộ đếm thời gian giám sát Failsafe 30 s.
Ràng buộc an toàn | Khi chuyển từ MANUAL về AUTO, hệ thống lập tức tái đánh giá mực nước và đưa cơ cấu chấp hành về đúng trạng thái FSM tương ứng.

Sơ đồ phân rã Use Case UC09 được thể hiện trong Hình 1.10.


Hình 1.10: Sơ đồ phân rã Use Case UC09: Chuyển đổi chế độ vận hành

UC10: Can Thiệp Điều Khiển Thiết Bị Chấp Hành Từ Web

Ca sử dụng UC10 cho phép người vận hành cưỡng chế vận hành máy bơm và cửa van xả lũ trong chế độ thủ công (Bảng 1.11).

Bảng 1.11: Bảng đặc tả chi tiết Use Case UC10: Can thiệp điều khiển thiết bị từ Web

Mã Use Case | UC10
Tên Use Case | Can thiệp điều khiển thiết bị chấp hành từ Web
Tác nhân chính | Người vận hành
Tác nhân phụ | Module Relay 5V, Máy bơm mini, Động cơ Servo SG90
Mục tiêu | Cưỡng chế bật/tắt bơm và điều chỉnh góc mở cửa van xả lũ phục vụ bảo trì hoặc xử lý tình huống khẩn cấp
Tiền điều kiện | Hệ thống đang ở chế độ thủ công (isAutoMode == false)
Hậu điều kiện | Trạng thái máy bơm hoặc góc mở cửa van thay đổi theo đúng lệnh của người vận hành
Luồng sự kiện chính | Bao gồm hai hành vi mở rộng («extend») tác động trực tiếp tới cơ cấu chấp hành: – Bật / Tắt cưỡng chế máy bơm: Người vận hành nhấp nút Bật/Tắt trên Dashboard, gửi lệnh GET /api/control?pump=1 (hoặc pump=0). Vi điều khiển lập tức kích dẫn hoặc ngắt Relay máy bơm. – Điều khiển cưỡng chế góc van xả: Người vận hành nhấp chọn ◦/90◦/180◦ , gửi lệnh GET /api/control?valve=90. Vi điều khiển góc 0 xuất xung PWM tương ứng tới động cơ Servo kéo cửa xả.
Luồng ngoại lệ (Safety Over-ride) | Cơ chế bảo vệ tối cao (Emergency Safety Override): Nếu trạm đang ở chế độ MANUAL và mực nước thực tế dâng chạm ngưỡng nguy cấp CRITICAL (≥ 71%), nếu sau 10 s người vận hành không can thiệp (hoặc vẫn tắt bơm/đóng van), hệ thống tự động kích hoạt ghi đè khẩn cấp: hủy bỏ MANUAL, cưỡng chế chuyển về AUTO, bật bơm công suất tối đa và mở van 100% (180◦ ) để chống vỡ đê/tràn bể.
Ràng buộc an toàn | Mọi lệnh can thiệp thành công đều làm tươi lại bộ đếm Heartbeat Failsafe (30 s).

Sơ đồ phân rã Use Case UC10 được thể hiện trong Hình 1.11.


Hình 1.11: Sơ đồ phân rã Use Case UC10: Can thiệp điều khiển thiết bị từ Web

## 1.4 Yêu Cầu Phi Chức Năng & Ràng Buộc Thời Gian

## Thực

### 1.4.1 Đặc Tính & Ràng Buộc Thời Gian Thực (Real-Time Constraints)

Trong kỹ thuật lập trình hệ thống nhúng, FloodGuard được thiết kế theo mô hình hệ thống thời gian thực mềm (Soft Real-Time) kết hợp với một số ràng buộc an toàn cứng (Firm Safety Constraints):

Chu kỳ trích mẫu cảm biến (Tsample = 150 ms): Vi điều khiển kích hoạt chu kỳ lấy mẫu định kỳ 150 ms. Trong các ứng dụng đo sâu công nghiệp, khoảng nghỉ khuyến cáo giữa các lần phát siêu âm thường ≥ 60 ms để sóng dội tắt hẳn; tuy nhiên với mô hình sa bàn bể nông (5 − 50 cm hoặc mica 6 − 16 cm), hành trình khứ hồi của sóng âm chỉ mất dưới 3 ms, do đó việc đo 3 mẫu cách nhau 12 ms trong chu kỳ quét 150 ms hoàn toàn đảm bảo sóng âm tắt hẳn mà vẫn duy trì tính thời gian thực cao.

Bộ lọc cửa sổ trượt trung vị 3 mẫu (Median Filter): Ba mẫu đo liên tiếp được lưu trong bộ đệm trượt để lọc bỏ các giá trị dị biệt (outliers) sinh ra do bọt khí, rung chấn cơ học hoặc bề mặt nước dập dềnh.

Thời gian phản ứng tối đa từ cảm biến đến chấp hành (WCRT ≤ 250 ms): Kể từ thời điểm cảm biến thu nhận xung Echo phản ánh mực nước vượt ngưỡng nguy cấp, thời gian phản ứng tức thời để thuật toán FSM ra quyết định và tiếp điểm Relay máy bơm đóng kín hoàn toàn (TWCRT_urgent) không vượt quá 250 ms (tính toán đạt 203 ms). Đối với các chuyển trạng thái bậc thang thông thường, hệ thống áp dụng thêm bộ lọc chống rung thời gian Debounce 1.0 s để đảm bảo độ tin cậy cơ cấu.

Chu kỳ làm mới giao diện Web (Trefresh = 1000 ms): Chu kỳ polling 1 s từ Dashboard đảm bảo cân bằng tối ưu giữa độ tươi mới của dữ liệu hiển thị và tải bộ nhớ RAM/băng thông mạng của chip vi điều khiển ESP32.

### 1.4.2 Độ Tin Cậy, Watchdog & An Toàn Vận Hành (Safety & Reliability)

Bộ giám sát tác vụ Task Watchdog Timer (TWDT): Hệ thống cấu hình bộ định thời giám sát tác vụ phần mềm thuộc hệ điều hành ESP-IDF FreeRTOS (thông qua hàm esp_task_wdt_add(NULL) gán trực tiếp cho loopTask) với chu kỳ timeout 3000 ms (3 s). Nếu vòng lặp chính của chương trình bị treo (do bẫy lỗi hoặc vòng lặp vô hạn), cơ chế TWDT sẽ tự động kích hoạt ngắt Reset vi điều khiển để khôi phục trạm về trạng thái an toàn ban đầu.

Cơ chế Failsafe mạng (30 s): Bộ đếm thời gian tầng ứng dụng đo khoảng cách giữa các gói tin điều khiển Web, tự động chuyển về AUTO nếu mất kết nối quá 30 s, ngăn ngừa rủi ro bỏ quên trạm ở chế độ thủ công.

### 1.4.3 Phân Tích An Ninh & Giới Hạn Bảo Mật (Security Anal-

### ysis)

Trong phạm vi mô hình thực nghiệm:

Kiến trúc mạng: Trạm phát sóng ở chế độ SoftAP (mạng FloodGuard_AP) sử dụng chuẩn mã hóa WPA2-PSK yêu cầu mật khẩu để gia nhập mạng cục bộ.

Giới hạn hiện tại: Máy chủ Web Server nhúng chạy trên giao thức HTTP cổng 80 không mã hóa (chưa hỗ trợ HTTPS/TLS) do chip ESP32 bị giới hạn về dung lượng RAM và mã hóa TLS tiêu tốn đáng kể chu kỳ xử lý CPU, gây ảnh hưởng đến tính thời gian thực của tác vụ điều khiển. Đồng thời, các endpoint API chưa áp dụng cơ chế xác thực Token hoặc OAuth2; các lệnh điều khiển hiện tại sử dụng phương thức GET /api/control.

Định hướng nâng cấp công nghiệp: Đối với phiên bản triển khai thương mại diện rộng, hệ thống cần được nâng cấp: chuyển các lệnh thay đổi trạng thái sang phương thức chuẩn POST /api/control có kèm mã xác thực JSON Web Token (JWT), tích hợp vi mạch mã hóa bảo mật chuyên dụng (AtegCC608A) để xử lý HTTPS, và cấu hình danh sách trắng địa chỉ vật lý (MAC Address Whitelisting) chỉ cho phép các thiết bị chuyên trách được kết nối điều khiển trạm.

# Chương 2

# Thiết Kế và Lắp Đặt Hệ Thống

## 2.1 Tổng Quan Kiến Trúc Hệ Thống

Hệ thống FloodGuard gồm 5 khối chức năng chính được tích hợp đồng bộ:

1. Khối xử lý trung tâm: Vi điều khiển ESP32 DevKit V1 với chip lõi kép Xtensa
| 32-bit (tần số xung nhịp 240 MHz), tích hợp bộ nhớ SRAM 520 KB và kết nối không dây Wi-Fi 802.11 b/g/n, đảm nhiệm đồng thời tác vụ đo đạc thời gian thực, thuật toán FSM và máy chủ Web Server nhúng.
2. Khối cảm biến (Sensors): Cảm biến siêu âm HC-SR04 đo khoảng cách tới mặt
| nước hồ thu và cảm biến mưa FC-37 (tấm điện cực kết hợp mạch so sánh LM393) đo lượng nước mưa bề mặt.
3. Khối chấp hành (Actuators): Gồm hai cơ cấu chấp hành độc lập: Động cơ Servo
| SG90 điều khiển góc mở cửa van xả lũ (0 ◦ − 90◦ − 180◦ ) và Module Relay 5 V điều khiển đóng/ngắt máy bơm mini thoát nước.
4. Khối cảnh báo tại chỗ (Signaling): Cụm 3 đèn LED màu (Xanh, Vàng, Đỏ) và
| còi báo động Active Buzzer 5 V.
5. Khối máy tính vận hành (Operator PC/Laptop): Trạm máy tính kết nối
| không dây qua sóng Wi-Fi SoftAP để mở giao diện Web Dashboard giám sát và can thiệp điều khiển; đồng thời kết nối có dây qua cổng Micro-USB phục vụ nạp firmware PlatformIO và theo dõi Serial Debug Monitor.
2.2 | Giải Pháp Điều Khiển Qua Mạng Không Dây Cục Bộ Thay Cho Nút Nhấn Cơ Học

Trong thiết kế trạm FloodGuard, giao diện giám sát và điều khiển can thiệp được chuyển dịch hoàn toàn sang giao diện Web Dashboard thông qua mạng không dây cục bộ (Local Wi-Fi / SoftAP) thay cho các nút bấm vật lý tại chỗ. Giải pháp này xuất phát từ các lập luận kỹ thuật và thực tiễn vận hành:

Đảm bảo an toàn tính mạng cho người vận hành: Mục tiêu cốt lõi của trạm bơm chống ngập là vận hành tự trị 24/7. Khi xảy ra thiên tai mưa bão ngập lụt, khu vực hồ thu và trạm bơm tiềm ẩn nguy cơ giông sét đánh, sụt lở mép bờ và rò rỉ điện từ các đường dây động lực ngâm trong nước. Việc điều khiển không dây cho phép kỹ thuật viên đứng từ vị trí khô ráo an toàn (trong xe chỉ huy hoặc trên tầng cao tòa nhà cách trạm 15 − 30 m) để theo dõi và ra lệnh.

| Cung cấp đầy đủ ngữ cảnh dữ liệu trước khi can thiệp: Khác với nút bấm vật lý vốn chỉ cho phép thao tác "mù"mà không biết chính xác mực nước hay trạng thái van xả, Web Dashboard hiển thị toàn bộ đồ họa số hóa (phần trăm nước, khoảng cách cm, cấp độ mưa, trạng thái FSM). Người vận hành có đầy đủ cơ sở thông tin kỹ thuật trước khi quyết định kích hoạt máy bơm hoặc xoay van xả lũ.
| Phân tích rủi ro & Giải pháp Dừng khẩn cấp (Emergency Stop): Việc không trang bị nút bấm cơ học đồng nghĩa với việc nếu thiết bị di động hết pin hoặc mạng Wi-Fi bị nhiễu sóng nặng, người tại chỗ không thể can thiệp tức thời. Để giảm thiểu rủi ro này:
| – Trong mô hình thực nghiệm, hệ thống áp dụng cơ chế bảo vệ Failsafe tự động chuyển về AUTO sau 30 s mất kết nối và tự động kích hoạt bơm toàn tải nếu nước chạm mức nguy cấp CRITICAL. – Tuy nhiên, theo các tiêu chuẩn an toàn máy móc công nghiệp (ISO 13850 và IEC 60204-1), ở phiên bản sản xuất thương mại thực tế ngoài hiện trường, hệ thống khuyến nghị bắt buộc bố trí thêm 01 nút Dừng khẩn cấp cơ học (E-Stop Button) dạng nấm màu đỏ có chốt khóa, đấu ngắt trực tiếp nguồn điện cấp cho cuộn hút Relay của máy bơm nhằm xử lý sự cố kẹt rác cơ học hoặc cháy nổ động cơ tại chỗ.

## 2.3 Bảng Phân Công Chân GPIO

Bảng 2.1: Bảng phân công chân phần cứng trên vi điều khiển ESP32

STT Thiết bị / Module Chân tín hiệu GPIO ESP32 Chức năng kỹ thuật & Lưu ý
điện áp
1 | HC-SR04 (Siêu âm) | Trig | GPIO 13 | Phát xung kích
| | | | siêu | âm | 10 µs
| | | | (3.3 V)
1 | HC-SR04 (Siêu âm) | Echo | GPIO 12 | Nhận xung phản
hồi | (Strapping
Pin MTDI; hạ áp
5 V → 3.3 V)
2 | Cảm biến mưa FC-37 | DO (Digital) | GPIO 34 | Ngõ vào số báo
mưa/khô (Input-only, không pull-up nội)
2 | Cảm biến mưa FC-37 | AO (Analog) | GPIO 35 | Đo | điện | áp
| | | | tương | tự | qua
ADC1_CH7
(Input-only)
3 | Động cơ Servo SG90 | PWM | GPIO 27 | Xung PWM điều
khiển van xả (0
| | | | | | ◦−
90◦ − 180◦
)
4 | Module Relay 5V | IN | GPIO 23 | Kích | đóng/ngắt
máy bơm 5V –
Active LOW
5 | LED Đỏ (Nguy cấp) | Anode (+) | GPIO 18 | Báo động CRITI-
CAL / DANGER
(nối tiếp R | =
| | | | 220 Ω)
6 | LED Vàng (Cảnh báo) Anode (+) | GPIO 19 | Báo trạng thái
WARNING (nối
tiếp R = 220 Ω)
7 | LED Xanh (An toàn) | Anode (+) | GPIO 21 | Báo trạng thái
NORMAL | (nối
tiếp R = 220 Ω)
8 | Còi Active Buzzer 5V | Cực (+) | GPIO 4 | Phát | xung | âm
thanh cảnh báo
đa cấp độ

2.4 | Sơ Đồ Nguyên Lý Mạch Điện & Kết Nối Ngoại
| Vi

Sơ đồ nguyên lý mạch điện chi tiết kết nối giữa vi điều khiển ESP32 với toàn bộ cảm biến, cơ cấu chấp hành, thiết bị chỉ thị và máy tính vận hành được minh họa trong Hình 2.1.

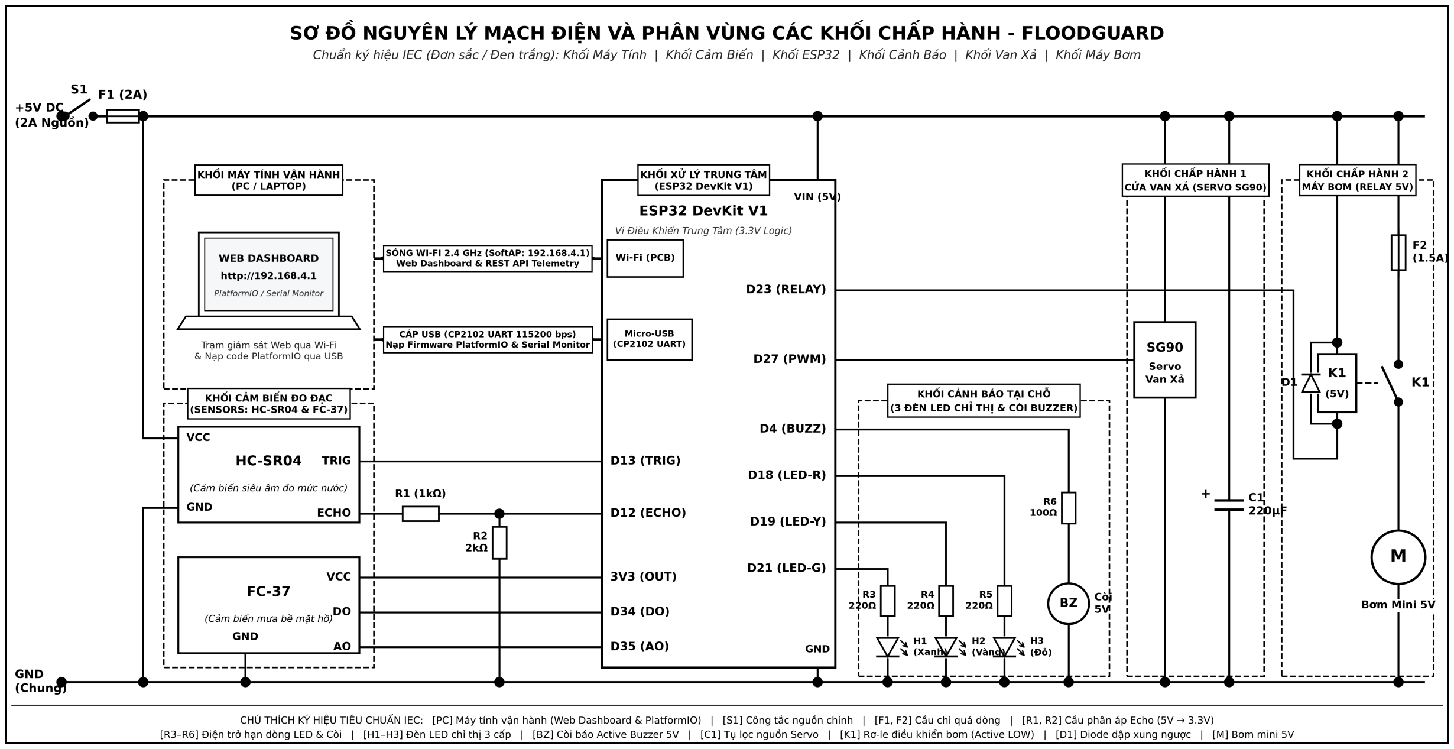
[picture p19: figure]

Hình 2.1: Sơ đồ nguyên lý mạch điện chuẩn IEC và phân vùng các khối chấp hành trạm FloodGuard

Dựa trên sơ đồ nguyên lý nối dây và phân vùng các khối chấp hành, các nguyên lý phối ghép phần cứng và giải pháp bảo vệ mạch điện được phân tích chi tiết:

### 2.4.1 Khối Chấp Hành Công Suất: Relay 5V, Diode Flyback & Nguồn Cấp Máy Bơm

Máy bơm nước mini 5 V sử dụng động cơ DC có chổi than, tiêu thụ dòng điện làm việc định mức khoảng 0.5 − 0.8 A và có thể lên tới 1.5 A khi khởi động (Inrush current). Để vận hành an toàn:

Phân tách nguồn cấp động lực: Nguồn cấp cho máy bơm được lấy từ chân VIN (nối với bộ nguồn 5 V−2 A bên ngoài), tuyệt đối không lấy từ chân 3V3 của ESP32 nhằm tránh hiện tượng sụt áp gây khởi động lại vi điều khiển (Brown-out Reset).

Bảo vệ cách ly quang (Optocoupler) & Diode dập xung ngược (Flyback Diode): Module Relay tích hợp optocoupler PC817 cách ly hoàn toàn điện áp 3.3 V của vi điều khiển với cuộn hút 5 V. Cuộn hút Relay được mắc song song với một Diode dập xung ngược (Flyback Diode) phân cực ngược để triệt tiêu sức điện động cảm ứng e = −L

di
dt sinh ra khi ngắt dòng điện cuộn dây, ngăn chặn xung điện áp cao đánh thủng transistor kích mở.

Cơ chế điều khiển Active LOW kết hợp trạng thái High-Z: Module Relay đóng tiếp điểm khi chân tín hiệu IN được kéo xuống mức LOW (0 V). Do vi điều khiển ESP32 chỉ xuất mức HIGH ở 3.3 V, sự chênh lệch 5 V − 3.3 V = 1.7 V có thể làm rò dòng qua LED phát quang nội của optocoupler khiến Relay không nhả hoàn toàn. Hệ thống xử lý triệt để hiện tượng này bằng cách:

– Khi bật bơm: Cấu hình ngõ ra OUTPUT và kéo chân Relay xuống mức LOW (0 V).

– Khi ngắt bơm: Cấu hình ngõ vào INPUT thả nổi chân về trạng thái trở kháng cao (High-Z).

### 2.4.2 Khối Cảm Biến: Bảo Vệ Điện Áp Echo & Chân Strapping

### GPIO 12

Cảm biến siêu âm HC-SR04 (GPIO 13 Trig, GPIO 12 Echo): Cảm biến HC-SR04 sử dụng nguồn cấp 5 V. Chân Echo xuất ra xung vuông mức biên độ 5 V. Do các chân GPIO của ESP32 chỉ dung nạp điện áp tối đa 3.3 V, chân Echo được mắc qua mạch phân áp trở hoặc điện trở hạn dòng bảo vệ kết hợp diode kẹp áp nội của vi điều khiển để hạ mức điện áp an toàn xuống ≈ 3.3 V. Về mặt vật lý lắp đặt, cảm biến có vùng mù ở khoảng cách < 3 cm và góc phát chùm tia hình nón ±15◦ ;
do đó khi gá đặt trên mô hình thực nghiệm, mặt loa cần đặt cao hơn mức nước đầy tối đa ít nhất 5−6 cm và chiếu thẳng vào tâm bể để tránh dội sóng nhiễu vào thành bể.

Lưu ý kỹ thuật đặc biệt với chân Strapping MTDI (GPIO 12): Trên vi điều khiển ESP32, GPIO 12 là chân cấu hình khởi động (Strapping Pin MTDI). Tại thời điểm cấp nguồn/reset, chip sẽ đọc mức logic của chân này: nếu ở mức LOW, chip chọn điện áp cấp cho bộ nhớ SPI Flash nội là 3.3 V (bình thường); nếu bị kéo lên mức HIGH, chip chuyển sang chế độ Flash 1.8 V dẫn tới treo vi điều khiển (vòng lặp Boot loop). Trong mạch thiết kế, chân Echo của cảm biến HC-SR04 ở trạng thái nghỉ luôn duy trì mức LOW (0 V), do đó hoàn toàn an toàn và không cản trở quá trình khởi động bình thường của ESP32.

Cảm biến mưa FC-37 (GPIO 34 DO, GPIO 35 AO): Module sử dụng nguồn 3.3 V. Chân GPIO 34 và GPIO 35 đều thuộc nhóm chân chỉ đọc (Input-only) của ESP32, không tích hợp điện trở kéo nội (Internal Pull-up/Pull-down). Trên module thương mại FC-37, bo mạch so sánh LM393 đã tích hợp sẵn điện trở kéo lên 10 kΩ cho chân ngõ ra số DO và mạch phân áp cho AO. Tuy nhiên, nếu cáp tín hiệu từ module về ESP32 bị tuột hoặc hở mạch, chân GPIO 35 thả nổi (floating) có thể đọc ra điện áp thấp do điện dung ký sinh, dẫn tới nguy cơ thuật toán nhận diện nhầm là ngập cảm biến (isSubmerged). Do đó, thiết kế phần cứng khuyến nghị lắp thêm một điện trở kéo ngoại 100 kΩ lên 3.3 V trực tiếp tại chân GPIO 35 để đảm bảo an toàn phần cứng (Hardware Failsafe).

### 2.4.3 Khối Động Cơ Servo SG90 (GPIO 27)

Động cơ Servo SG90 điều khiển cửa van xả lũ nhận xung điều khiển PWM từ chân GPIO 27 với tần số cơ sở 50 Hz (chu kỳ 20 ms). Độ rộng xung điều khiển được ánh xạ tương ứng: 1.0 ms (0

- – Đóng kín), 1.5 ms (90◦ – Mở 50%) và 2.0 ms (180◦ – Mở 100%). Nguồn nuôi Servo được cấp trực tiếp từ đường nguồn 5 V (VIN) nhằm đảm bảo đủ mô-men xoắn kéo cửa van.
2.4.4 | Khối Thiết Bị Chỉ Thị & Cảnh Báo Tại Trạm
| Cụm 3 đèn LED phân cấp: Gồm LED Đỏ (GPIO 18), LED Vàng (GPIO 19)
và LED Xanh (GPIO 21). Mỗi đèn LED được mắc nối tiếp với điện trở hạn dòng R = 220 Ω. Tại điện áp ngõ ra VOH = 3.3 V, dòng điện định mức qua diode được xác định theo định luật Ohm:

ILED =

VOH − Vf
R

≈

3.3 V − 2.0 V
220 Ω
≈ 5.9 mA | (2.1)

Dòng điện này nằm hoàn toàn trong dải tải làm việc khuyến nghị an toàn của GPIO ESP32 (Isource ≤ 12 mA), đồng thời đảm bảo cường độ sáng rõ nét tại thực địa.

Còi báo động Active Buzzer 5V (GPIO 4): Còi tích hợp sẵn mạch tạo dao động âm thanh bên trong với tần số cộng hưởng cố định ≈ 2.3 kHz (do đó không cần và không thể dùng hàm tone() để đổi tần số như còi thụ động Passive Buzzer). Cực dương của còi được cấp nguồn và điều khiển đóng/ngắt logic từ GPIO 4 qua trở hạn dòng đệm 100 Ω. Thuật toán điều khiển sử dụng bộ đếm thời gian phi chặn millis(), băm xung bật/tắt (HIGH/LOW) theo các nhịp cảnh báo xác định mà không chiếm dụng chu kỳ CPU hay gây gián đoạn luồng đo cảm biến và máy chủ Web.

### 2.4.5 Khối Máy Tính Vận Hành: Giao Tiếp Wi-Fi SoftAP &

### Cáp USB PlatformIO

Trên sơ đồ nguyên lý mạch điện (Hình 2.1), khối máy tính vận hành (PC / Laptop) đóng vai trò là trạm điều hành giám sát trung tâm và công cụ nạp mã nguồn bảo trì hệ thống. Máy tính tương tác trực tiếp với vi điều khiển ESP32 thông qua hai kênh truyền thông vật lý và logic độc lập:

Kênh truyền thông không dây (Wi-Fi 2.4 GHz SoftAP):

– Phương thức kết nối: Vi điều khiển ESP32 khởi tạo một điểm truy cập không dây cục bộ (SoftAP) độc lập với SSID FloodGuard_AP, bảo mật WPA2-PSK và cấp phát địa chỉ IP tự động cho máy tính qua giao thức DHCP nội bộ.

– Giao thức truyền tải: Máy tính mở trình duyệt Web kết nối tới địa chỉ IP tĩnh của trạm 192.168.4.1 (hoặc tên miền http://floodguard.local qua mDNS). Dữ liệu giám sát telemetry được cập nhật định kỳ mỗi 1000 ms qua endpoint /api/status với payload JSON ≈ 210 byte.
– Can thiệp điều khiển: Khi người vận hành chuyển sang chế độ thủ công (MANUAL) và ra lệnh kích hoạt bơm hoặc chỉnh góc van xả, máy tính gửi các yêu
cầu HTTP GET/POST tới endpoint /api/control?mode=manual&pump=1&valve=90. Quá trình truyền thông diễn ra hoàn toàn cục bộ, không phụ thuộc vào hạ tầng Internet hay trạm phát sóng viễn thông công cộng, đảm bảo độ sẵn sàng cao trong điều kiện thiên tai bão lũ.

| Kênh truyền thông có dây (Cáp Micro-USB qua cầu nạp CP2102):
| – Nạp mã nguồn nhúng (Firmware Upload): Cáp Micro-USB kết nối cổng USB của máy tính với chip chuyển đổi USB-to-UART CP2102 tích hợp sẵn trên bo mạch ESP32 DevKit V1. Môi trường phát triển PlatformIO IDE sử dụng các chân tín hiệu DTR và RTS điều khiển tự động mạch transistor kép để kéo chân EN (Reset) và GPIO 0 (Boot mode) xuống mức thấp, tự động đưa vi điều khiển vào chế độ nhận firmware nạp vào bộ nhớ Flash 4 MB mà kỹ thuật viên không cần thao tác bấm giữ nút vật lý tại hiện trường. – Giám sát Serial Debug Monitor (115200 bps): Kênh UART phần cứng cho phép máy tính thu thập trực tiếp luồng log dữ liệu thời gian thực từ vi điều khiển: các giá trị khoảng cách thô và sau lọc trung vị, giá trị ADC cảm biến mưa, thời gian thực thi của từng tác vụ (Task execution time) và nhật ký chuyển đổi trạng thái FSM. Đây là công cụ kỹ thuật then chốt phục vụ công tác hiệu chuẩn sai số, đánh giá thời gian đáp ứng tồi nhất (WCRT) và khoanh vùng sự cố phần cứng.
| Giải pháp bảo vệ cách ly nguồn và chống xung ngược: Trong cấu hình vận hành tiêu chuẩn, ESP32 và các tải động lực (động cơ bơm, Servo SG90) nhận nguồn công suất từ bộ nguồn DC 5 V−2 A bên ngoài thông qua chân VIN. Nhờ mạch diode Schottky bảo vệ nguồn nội trên bo mạch ESP32 DevKit V1, nguồn điện cấp từ cáp USB máy tính (5 V VBUS) được tự động cách ly khỏi đường nguồn công suất khi nguồn ngoài đang cấp điện. Thiết kế này ngăn chặn triệt để nguy cơ sụt áp cổng USB máy tính do dòng khởi động của động cơ, đồng thời loại trừ nguy cơ các xung điện áp quá độ từ cuộn cảm động cơ đánh thủng bo mạch chủ của máy tính vận hành.

# Chương 3

# Thuật Toán Điều Khiển & Vận Hành Phần Mềm Nhúng

3.1 | Kiến Trúc Phần Mềm Nhúng (Firmware Archi- tecture)
3.1.1 | Sơ Đồ Phân Khối Chức Năng Firmware

Phần mềm điều khiển trạm FloodGuard được xây dựng trên nền tảng vi điều khiển ESP32 với cấu trúc module hóa phân tầng rõ ràng, đảm bảo tính độc lập giữa khối thu thập dữ liệu, khối xử lý logic thuật toán và khối điều khiển phần cứng. Kiến trúc phần mềm bao gồm 7 phân hệ chính:

1. Khối thu thập cảm biến (Sensor Processing Module): Định kỳ kích Trig và đo xung phản hồi Echo của HC-SR04; đọc điện áp analog và digital của cảm biến mưa FC-37.
2. Khối lọc số (Digital Median Filter): Xử lý chuỗi mẫu đo khoảng cách, sắp xếp trích xuất giá trị trung vị nhằm loại trừ nhiễu đột biến, bọt khí và dao động sóng.
3. Khối máy trạng thái hữu hạn (FSM Core Engine): Tiếp nhận dữ liệu mực nước và lượng mưa, đối chiếu ma trận ngưỡng kết hợp dải trễ để xác định trạng thái tối ưu.
4. Trình điều khiển cơ cấu chấp hành (Actuator Driver): Điều khiển tiếp điểm Relay 5V kích máy bơm (chế độ High-Z) và phát xung PWM chỉnh góc mở Servo van xả (0
| ◦ , 90◦ , 180◦ ).
5. Khối cảnh báo thực địa phi chặn (Signaling Driver): Quản lý 3 đèn LED phân cấp và băm xung âm thanh còi Active Buzzer theo các nhịp cảnh báo thời gian thực phi chặn CPU.
6. Máy chủ Web Server nhúng (HTTP REST API Handler): Phục vụ giao diện Web Dashboard lưu trong Flash và cung cấp các endpoint API trao đổi JSON thời gian thực.
7. Khối giám sát an toàn (Failsafe & Watchdog Guard): Đếm thời gian nhận heartbeat, tự động thu hồi quyền thủ công khi mất mạng và kích hoạt trạng thái an toàn.

### 3.1.2 Bảng Lập Lịch Tác Vụ Thời Gian Thực (Task Scheduling Matrix)

Hệ thống sử dụng mô hình điều độ bất đồng bộ dựa trên bộ đếm thời gian vi điều khiển millis(), phân chia chu kỳ thực thi tối ưu cho từng tác vụ nhằm đảm bảo tính thời gian thực (Bảng 3.1).

| Bảng 3.1: Bảng lập lịch tác vụ thời gian thực của hệ thống FloodGuard
Tên tác vụ | Chu kỳ (Tperiod) | Thực thi (Texec) | Mô tả chức năng & Cơ chế kích hoạt
Đọc cảm biến siêu âm | 150 − 200 ms | ≈ 36 ms | Thu thập 3 mẫu liên tiếp, lọc trung vị, quy đổi phần trăm mực nước. Kích hoạt bởi bộ đếm thời gian.
Đọc cảm biến mưa | 150 − 200 ms | < 1 ms | Đọc điện áp ADC 12-bit (GPIO 35) và tín hiệu digital mưa (GPIO 34).
Đánh giá trạng thái FSM | 150 − 200 ms | < 2 ms | Tính toán chuyển dịch trạng thái, áp dụng dải trễ Hysteresis và quy tắc an toàn.
Cập nhật cơ cấu chấp hành | Khi đổi trạng thái | < 1 ms | Chuyển mức GPIO 23 (bơm relay) và cập nhật xung PWM điều khiển góc van.
Băm xung còi & LED | 5 − 10 ms (vòng lặp) | < 0.5 ms | So sánh now % period băm xung còi và chớp nháy LED Đỏ phi chặn (Non-blocking).
Phục vụ HTTP Web Server | 5 − 10 ms (vòng lặp) | 2 − 8 ms | Gọi server.handleClient(); đóng gói JSON gửi telemetry cho Web Dash-board.
Giám sát Heartbeat Failsafe | 1000 ms | < 0.1 ms | Kiểm tra chu kỳ heartbeat; tự động kích hoạt Failsafe nếu mất kết nối quá 30 s.
Watchdog Reset (TWDT) | Mỗi vòng lặp | < 0.05 ms | Reset bộ đếm Task Watchdog phần cứng ESP32, chống treo vi điều khiển.
3.1.3 | Lý Do Lựa Chọn Kiến Trúc millis() Phi Chặn Thay Cho

### delay() & FreeRTOS

Trong lập trình hệ thống nhúng với ESP32:

Loại bỏ hoàn toàn delay(): Hàm delay() là hàm ngắt chờ chủ động (busy-wait blocking), làm đóng băng hoàn toàn CPU trong khoảng thời gian chờ. Nếu sử dụng delay() để tạo nhịp bíp còi hú (150 ms) hoặc chờ cảm biến, ESP32 sẽ không thể phản hồi các yêu cầu HTTP từ Web Server, dẫn tới hiện tượng rớt kết nối mạng (Network Timeout) và làm sai lệch nghiêm trọng độ trễ điều khiển.

So sánh với FreeRTOS Preemptive Multitasking: Mặc dù ESP32 hỗ trợ hệ điều hành thời gian thực FreeRTOS đa nhiệm chiếm ưu thế (Preemptive), đề tài lựa chọn kiến trúc Super-Loop phối hợp theo hướng sự kiện (State-Driven Non-blocking Pattern) dựa trên hàm millis() vì các ưu thế kỹ thuật:

1. Tiết kiệm tài nguyên bộ nhớ RAM: Mỗi tác vụ FreeRTOS Task đòi hỏi cấp phát riêng một vùng nhớ Stack (thường từ 2 KB đến 4 KB). Với hệ thống nhỏ gọn phục vụ Web Server nhúng, việc tiết kiệm RAM giúp tránh lỗi tràn ngăn xếp (Stack Overflow).
2. Triệt tiêu chi phí chuyển đổi ngữ cảnh (Context-Switch Overhead): Việc không phải lưu và phục hồi các thanh ghi CPU giữa các luồng giúp CPU tập trung tối đa cho việc xử lý xung siêu âm và phục vụ socket mạng.
3. Loại bỏ triệt để nguy cơ tương tranh (Race Condition & Deadlock): Toàn bộ biến trạng thái toàn cục (mực nước, trạng thái bơm, chế độ) được truy cập tuần tự trong một luồng thực thi duy nhất, loại bỏ hoàn toàn nhu cầu sử dụng Mutex hay Semaphore phức tạp vốn rất dễ phát sinh lỗi nghẽn khóa (Deadlock) hoặc đảo ngược quyền ưu tiên (Priority Inversion).

### 3.1.4 Lưu Đồ Thuật Toán Vòng Lặp Chính setup() / loop()

Quy trình vận hành phần mềm nhúng được thực thi tuần hoàn theo hai giai đoạn:

1. Giai đoạn khởi tạo (setup()):
| Thiết lập cổng giao tiếp nối tiếp Serial tốc độ 115200 bps.
| Cấu hình chân GPIO cảm biến (Trig là OUTPUT, Echo, Rain_DO, Rain_AO là INPUT).
| Khởi tạo chân Relay ở chế độ INPUT (High-Z) để đảm bảo máy bơm không bị kích hoạt giật khi boot.
| Gắn chân PWM cho Servo van xả lũ và kéo về góc đóng 0 ◦ .
| Khởi động mạng Wi-Fi SoftAP với SSID FloodGuard_AP (IP: 192.168.4.1) và tên miền mDNS floodguard.local.
| Đăng ký các hàm định tuyến xử lý Web Server (/, /api/status, /api/control) và khởi chạy server.begin().
2. Giai đoạn vòng lặp chính (loop()):
| Bước 1: Gọi server.handleClient() tiếp nhận và giải quyết ngay các gói tin HTTP đến từ client.
| Bước 2: Kiểm tra thời gian millis() - lastSensorRead ≥ 150 ms. Nếu đến chu kỳ: tiến hành đọc cảm biến (updateSensors()) và đánh giá logic FSM (evaluateSystemStateAuto()).
| Bước 3: Gọi applyOutputs() để băm xung còi, nhấp nháy LED và cập nhật vị trí cơ cấu chấp hành.
| Bước 4: Kiểm tra bộ đếm thời gian Failsafe; nếu mất kết nối quá 30 s ở chế độ MANUAL thì tự động gán isAutoMode = true.
| Bước 5: Xóa cờ Watchdog phần cứng và quay lại Bước 1.

3.2 | Tiền Xử Lý & Hiệu Chuẩn Tín Hiệu Cảm Biến
3.2.1 | Công Thức Tính Khoảng Cách Siêu Âm & Cấu Hình Đo

Cảm biến siêu âm HC-SR04 đo khoảng cách thông qua nguyên lý đo thời gian truyền sóng âm (Time-of-Flight - ToF). Khi chân Trig nhận xung dương có độ rộng tối thiểu 10 µs, bộ phát phát ra 8 xung siêu âm tần số 40 kHz. Sóng âm lan truyền trong không khí, va đập vào bề mặt nước và phản xạ trở lại đầu thu, làm chân Echo bật lên mức HIGH. Độ rộng của xung Echo (t) tương ứng với thời gian sóng âm đi và về.
Khoảng cách từ cảm biến tới mặt nước (d) được xác định bởi công thức:

d =

t × vsound
2

(3.1)

Trong điều kiện nhiệt độ phòng tiêu chuẩn 20◦C, vận tốc âm thanh trong không khí là vsound ≈ 343 m/s = 0.0343 cm/µs. Do đó:

d =

t × 0.0343
2

=

t
58.309
cm | (3.2)

Trong mã nguồn, hàm đo xung được thiết lập với ngưỡng chặn timeout xác định:

1 | long duration = pulseIn ( PIN_ECHO , HIGH , 30000) ; // Timeout 30 ms (~5.14 m)
| Timeout 30000 µs (30 ms): Tương ứng với khoảng cách đo cực đại dmax ≈ 5.14 m.
Hàm pulseIn() trong kiến trúc Arduino bản chất là một hàm đồng bộ chặn CPU (Blocking execution). Việc thiết lập timeout 30 ms giúp chặn thời gian chờ tối đa: nếu không có sóng phản hồi hoặc cảm biến hở mạch, hàm tự động kết thúc sau 30 ms và trả về 0, ngăn ngừa việc CPU bị treo vô hạn.

Giãn cách phát xung tối thiểu: Sau khi đo xong, hệ thống duy trì khoảng nghỉ tối thiểu giữa các lần kích Trig từ 12 ms đến 60 ms để đảm bảo năng lượng sóng phản xạ cũ suy giảm hoàn toàn dưới ngưỡng kích hoạt của đầu thu, tránh hiện tượng giao thoa dội âm.

### 3.2.2 Bộ Lọc Trung Vị 3 Mẫu (Median-of-3 Filter) & Phân Tích Độ Trễ

Môi trường mặt nước hồ thu luôn chịu tác động của bọt khí, dòng chảy xối xả và dao động dập dềnh. Đồng thời, các xung điện áp cảm ứng do đóng ngắt Relay có thể gây nhiễu gai điện từ (EMI) trên đường dây. Để thu được dữ liệu mực nước chính xác, hệ thống triển khai bộ lọc trung vị 3 mẫu:

1. Trong mỗi chu kỳ cập nhật, vi điều khiển thu thập liên tiếp 3 mẫu đo: S = [s1, s2, s3] với khoảng cách giữa các mẫu là 12 ms.
2. Các mẫu đo được kiểm tra tính hợp lệ về mặt vật lý (2.0 cm ≤ si ≤ 300.0 cm). Các mẫu bị timeout hoặc lỗi (si ≤ 0) được gắn cờ loại trừ.
3. Sắp xếp 3 phần tử theo thứ tự tăng dần bằng thuật toán Bubble Sort tối ưu:
s(1) ≤ s(2) ≤ s(3) | (3.3)

Giá trị đầu ra của bộ lọc được chọn là giá trị ở giữa: dfiltered = s(2).

Đặc tính kỹ thuật của bộ lọc:

Khả năng triệt tiêu nhiễu đỉnh đột biến (Impulse Noise Rejection): Nếu 1 trong 3 mẫu bị nhảy vọt (ví dụ do hạt nước bắn dính màng loa hoặc nhiễu sụt áp), giá trị lỗi đó sẽ bị đẩy về biên s(1) hoặc s(3) và hoàn toàn bị loại bỏ, không làm sai lệch giá trị trung vị s(2).

Độ trễ xử lý (Filter Latency): Tổng thời gian lấy 3 mẫu đo danh định là 3× ≈ 12 ms = 36 ms. Với tốc độ dâng nước tối đa trong các kịch bản ngập úng đô thị (< 5 cm/s), độ trễ 36 ms tương đương với độ dịch chuyển mực nước tối đa 5 cm/s × 0.036 s = 0.18 cm = 1.8 mm, hoàn toàn không gây ảnh hưởng đến tính kịp thời của quyết định xả lũ. Trong trường hợp xấu nhất mất tín hiệu khiến cả 3 mẫu đều bị timeout, thời gian chờ tối đa của bộ lọc đạt 3 × 30 ms = 90 ms.

Cơ chế dự phòng giữ mẫu cũ (Sample-and-Hold Fallback): Nếu cả 3 mẫu đo đều bị timeout (trường hợp mất tín hiệu tạm thời), hệ thống tự động giữ nguyên giá trị hợp lệ gần nhất (lastValidDistance) để FSM không bị nhảy trạng thái hỗn loạn.

### 3.2.3 Ánh Xạ & Giới Hạn Giá Trị (Clamp/Constrain) Về Dải

0 − 100%

Hệ thống thiết kế công thức ánh xạ tuyến tính tổng quát theo hai cấu hình kích thước hình học hồ thu:

Cấu hình mô phỏng Wokwi / Bể tiêu chuẩn: Khoảng cách cạn dempty = 50.0 cm (0%), đầy tràn dfull = 5.0 cm (100%), chiều sâu làm việc ∆d = 45.0 cm.

Cấu hình mô hình thực nghiệm Mica mini (28 × 16 × 22 cm): Khoảng cách từ mặt cảm biến tới đáy bể cạn dempty = 16.0 cm (0%), mức nước dâng đầy quy ước 10.0 cm tương ứng khoảng cách an toàn dfull = 6.0 cm (100%, tránh vùng mù < 3 cm của HC-SR04), chiều sâu làm việc ∆d = 10.0 cm.

Công thức tổng quát tính toán phần trăm mực nước thô (Praw):

Praw =

dempty − dfiltered

dempty − dfull

× 100% | (3.4)

Để ngăn chặn các giá trị tính toán vượt ra ngoài giới hạn vật lý khi nước dâng vượt ngưỡng dfull hoặc khi cảm biến đặt cao hơn dempty, hệ thống áp dụng hàm kẹp giá trị (Clamp):
waterPercent = constrain(Praw, 0, 100) | (3.5)
3.2.4 | Bảng Ngưỡng Cảm Biến Mưa FC-37 & Cơ Sở Chọn Ngưỡng

Cảm biến mưa FC-37 sử dụng tấm điện cực mạ niken kết hợp mạch so sánh điện áp LM393. Khi các giọt nước mưa tiếp xúc với bề mặt, cầu điện trở giữa các đường mạch đồng bị suy giảm, làm thay đổi điện áp tại chân ngõ ra tương tự AO. Vi điều khiển ESP32 đọc tín hiệu này qua bộ chuyển đổi ADC 12-bit (ADC1_CH7, dải giá trị 0 − 4095 tương ứng với 0 − 3.3 V).

Dựa trên thực nghiệm kiểm chuẩn với các điều kiện thời tiết mô phỏng, các ngưỡng phân cấp lượng mưa được thiết lập trong Bảng 3.2.

Bảng 3.2: Bảng phân cấp ngưỡng cảm biến lượng mưa FC-37 trên ESP32 ADC 12-bit

Cấp độ mưa | Giá trị ADC | Điện áp ngõ ra | Chân DO | Mô tả thực nghiệm
Khô ráo (Không mưa) | 3200 − 4095 | 2.58−3.30 V | HIGH | Bề mặt tấm cực khô ráo hoàn toàn.
Mưa nhỏ (Light Rain) | 1800 − 3199 | 1.45−2.57 V | LOW | Đọng vài giọt mưa lấm tấm trên bề mặt.
Mưa to (Heavy Rain) | 1100 − 1799 | 0.88−1.44 V | LOW | Nước chảy tràn phủ đều 50% tấm cực.
Ngập nước (Sub-merged) | 0 − 1099 | 0.00−0.87 V | LOW | Tấm cảm biến bị nhấn chìm hoàn toàn trong nước.
3.2.5 | Kết Quả Hiệu Chuẩn Thực Tế So Với Thước Đo Chuẩn

Để đánh giá độ chính xác thực tế của khối đo lường siêu âm sau khi đi qua bộ lọc trung vị 3 mẫu, nhóm nghiên cứu đã tiến hành đo đạc đối chứng tại 6 mốc khoảng cách cố định bằng thước cơ khí chuẩn (Ground Truth). Kết quả được ghi nhận trong Bảng 3.3.

Bảng 3.3: Bảng kết quả hiệu chuẩn cảm biến siêu âm HC-SR04 trên dải chuẩn 5 − 50 cm

Thước chuẩn (dref) | Đo thực tế (dmeas) | Sai số tuyệt đối (|e|) | Sai số tương đối (δ) | Mực nước quy đổi
5.0 cm | 5.2 cm | 0.2 cm | 4.00% | 99.6% (≈ 100%)
10.0 cm | 10.3 cm | 0.3 cm | 3.00% | 88.2%
20.0 cm | 19.8 cm | 0.2 cm | 1.00% | 67.1%
30.0 cm | 30.4 cm | 0.4 cm | 1.33% | 43.6%
40.0 cm | 39.5 cm | 0.5 cm | 1.25% | 23.3%
50.0 cm | 50.3 cm | 0.3 cm | 0.60% | 0.0%

Kết quả thực nghiệm trên cho thấy sai số tuyệt đối cực đại của hệ thống đạt |e|max ≤ 0.5 cm trên toàn bộ dải đo kiểm chuẩn 5.0 − 50.0 cm (đo lặp lại 5 lần tại mỗi mốc đối chứng với tấm phẳng phản xạ mica ở nhiệt độ phòng 25◦C), hoàn toàn thỏa mãn chỉ tiêu kỹ thuật ≤ ±1.0 cm đã đặt ra.

3.3 | Máy Trạng Thái Hữu Hạn FSM (Finite State Machine)
3.3.1 | Sơ Đồ Chuyển Trạng Thái FSM Chuẩn UML

Mô hình FSM của FloodGuard gồm 4 trạng thái vận hành cốt lõi và 1 trạng thái ngoại lệ an toàn được minh họa trong Hình 3.1.


Hình 3.1: Sơ đồ chuyển trạng thái máy trạng thái hữu hạn FSM của hệ thống FloodGuard

3.3.2 | Bảng Ma Trận Chuyển Trạng Thái (State Transition Ta-
| ble)

Ma trận chuyển dịch giữa các trạng thái được xác định chặt chẽ dựa trên các biểu thức điều kiện bảo vệ (Guard Conditions) kết hợp thông số mực nước và lượng mưa (Bảng 3.4).

Bảng 3.4: Bảng ma trận chuyển trạng thái của thuật toán FSM kết hợp dải trễ Hysteresis

Trạng thái hiện tại | Điều kiện kích hoạt chuyển dịch (Guards) | Trạng thái kế tiếp | Hành động thực thi khi vào trạng thái
STATE_NORMAL | Pwater ≥ 71% hoặc isSubmerged Pwater ≥ 41% hoặc isHeavyRain Pwater ≥ 21% hoặc isLightRain | STATE_CRITICAL STATE_DANGER STATE_WARNING | Bật bơm, mở van 100%, LED đỏ chớp, còi hú liên tục. Bật bơm (nếu P ≥ 20%), mở van 50%, LED đỏ sáng, còi dồn dập 400 ms. ◦ Tắt bơm, đóng van 0 , LED vàng sáng, còi bíp thưa 1.5 s.
STATE_WARNING | Pwater ≥ 71% hoặc isSubmerged Pwater ≥ 41% hoặc isHeavyRain Pwater < 18% và tạnh mưa hoàn toàn | STATE_CRITICAL STATE_DANGER STATE_NORMAL | Bật bơm, mở van 100%, còi hú liên tục. Bật bơm, mở van 50%, còi dồn dập 400 ms. Tắt còi, LED xanh sáng (an toàn).

(Còn tiếp ở trang sau)

Bảng 3.4 – Tiếp theo từ trang trước

Trạng thái hiện tại | Điều kiện kích hoạt chuyển dịch (Guards) | Trạng thái kế tiếp | Hành động thực thi khi vào trạng thái
STATE_DANGER | Pwater ≥ 71% hoặc isSubmerged Pwater < 38% và không mưa to | STATE_CRITICAL STATE_WARNING | Tăng góc van lên 100%, chuyển còi sang hú liên tục. Ngắt bơm (sau Tmin_run ≥ 5 s), đóng van về 0 ◦ , hạ còi.
STATE_CRITICAL | Pwater < 68% và không ngập sensor | STATE_DANGER | Giảm van về 50%, chuyển còi về nhịp dồn dập 400 ms.
Mọi trạng thái | Mất xung Echo liên tiếp > 450 ms (3 chu kỳ) | SENSOR_FAULT | Tắt bơm (chống cháy bơm), mở van 50% xả an toàn, 3 LED chớp, còi ngắt quãng báo sự cố.
SENSOR_FAULT | Nhận lại ≥ 5 mẫu đo ToF hợp lệ liên tiếp | STATE_NORMAL hoặc cấp tương ứng | Phục hồi vận hành tự động bình thường.
3.3.3 | Bảng Tín Hiệu Đầu Ra Chi Tiết Theo Từng Trạng Thái

Tương ứng với mỗi trạng thái FSM, hệ thống thiết lập đồng bộ tín hiệu điều khiển trên toàn bộ cơ cấu chấp hành và thiết bị chỉ thị (Bảng 3.5).

| Bảng 3.5: Bảng tín hiệu điều khiển đầu ra theo từng trạng thái FSM
Trạng thái FSM | LED Xanh | LED Vàng | LED Đỏ | Còi Buzzer 5V | Relay Bơm | Van Servo
STATE_NORMAL | BẬT | TẮT | TẮT | Tắt hoàn toàn (0V) | OFF (High-Z) | ◦ Đóng 0 (0%)
STATE_WARNING | TẮT | BẬT | TẮT | Bíp thưa (120 ms on / 1380 ms off) | OFF (High-Z) | Đóng 0 ◦ (0%)
STATE_DANGER | TẮT | TẮT | BẬT | Dồn dập (150 ms on / 250 ms off) | ON (Active LOW) | Mở 90◦ (50%)
STATE_CRITICAL | TẮT | TẮT | Chớp 100 ms | Hú liên tục (≈ 2.3 kHz) | ON (Active LOW) | Mở 180◦ (100%)
SENSOR_FAULT | Chớp | Chớp | Chớp | Bíp ngắt quãng báo sự cố | TẮT (Bảo vệ) | Mở an toàn 90◦ (50%)
3.3.4 | Mã C++ Hiện Thực FSM Bằng Cấu Trúc Switch-Case

Đoạn mã C++ chuẩn hóa hiện thực hóa logic FSM, tích hợp dải trễ Hysteresis, bộ lọc Debounce và cơ chế Safety Override:

1 | // Bang hang so nguong Hysteresis dong bo toan he thong
2 | const int THRESHOLD_WARN_ENTER | = 21 , THRESHOLD_WARN_EXIT | = 18; //
| Delta = 3%
3 | const int THRESHOLD_DANGER_ENTER = 41 , THRESHOLD_DANGER_EXIT = 38; //
| Delta = 3%
4 | const int THRESHOLD_CRIT_ENTER | = 71 , THRESHOLD_CRIT_EXIT | = 68; //
| Delta = 3%

5
6 | void evaluateSystemStateAuto () {
7 | bool isLightRain = isRaining ;
8 | bool isHeavyRain = ( rainRawADC < RAIN_ADC_HEAVY );
9 | bool isSubmerged = ( rainRawADC < RAIN_ADC_SUBMERGED ) ;

10
11 | // 1. Luon cap nhat FSM va LED / Coi de bao ve an toan ngay ca o MANUAL
12 | switch ( sysState ) {
13 | case STATE_NORMAL :
14 | if ( waterPercent >= THRESHOLD_CRIT_ENTER || isSubmerged ) sysState
| = STATE_CRITICAL ;
15 | else if ( waterPercent >= THRESHOLD_DANGER_ENTER || isHeavyRain )
| sysState = STATE_DANGER ;
16 | else if ( waterPercent >= THRESHOLD_WARN_ENTER || isLightRain )
| sysState = STATE_WARNING ;
17 | break ;

18
19 | case STATE_WARNING :
20 | if ( waterPercent >= THRESHOLD_CRIT_ENTER || isSubmerged ) sysState
| = STATE_CRITICAL ;
21 | else if ( waterPercent >= THRESHOLD_DANGER_ENTER || isHeavyRain )
| sysState = STATE_DANGER ;
22 | else if ( waterPercent < THRESHOLD_WARN_EXIT && ! isLightRain )
| sysState = STATE_NORMAL ;
23 | break ;

24
25 | case STATE_DANGER :
26 | if ( waterPercent >= THRESHOLD_CRIT_ENTER || isSubmerged ) sysState
| = STATE_CRITICAL ;
27 | else if ( waterPercent < THRESHOLD_DANGER_EXIT && ! isHeavyRain )
| sysState = STATE_WARNING ;
28 | break ;

29
30 | case STATE_CRITICAL :
31 | if ( waterPercent < THRESHOLD_CRIT_EXIT && ! isSubmerged ) sysState =
| STATE_DANGER ;
32 | break ;
33 | }

34
35 | // 2. Dieu khien co cau chap hanh tu dong ( chi khi isAutoMode == true )
36 | if ( isAutoMode ) {
37 | switch ( sysState ) {
38 | case STATE_NORMAL :
39 | case STATE_WARNING :
40 | pumpState = false ; valvePercent = 0; break ;
41 | case STATE_DANGER :
42 | pumpState = ( waterPercent >= 20) ; // Khoa chong chay kho bom khi
| nuoc < 20%
43 | valvePercent = 50; break ;
44 | case STATE_CRITICAL :
45 | pumpState = true ; valvePercent = 100; break ;

46 | }
47 | } else {
48 | // MANUAL MODE : Giam sat ghi de an toan toi cao ( Safety Override )
49 | static unsigned long critStart = 0;
50 | if ( sysState == STATE_CRITICAL ) {
51 | if ( critStart == 0) critStart = millis () ;
52 | else if ( millis () - critStart >= 10000) { // Qua 10s o muc
CRITICAL
53 | isAutoMode = true ; pumpState = true ; valvePercent = 100; //
Cuong che cuu ho
54 | critStart = 0;
55 | }
56 | } else critStart = 0;
57 | }
58 | }
3.4 | Nguyên Lý Dải Trễ (Hysteresis) & Chống Rung

## Thời Gian

### 3.4.1 Phân Tích Cải Tiến Độ Rộng Dải Trễ (Hysteresis Bandwidth)

Trong các phiên bản thiết kế đơn giản, khoảng cách dải trễ giữa ngưỡng bật và ngưỡng tắt thường chỉ được đặt chênh lệch 1% (ví dụ bật bơm khi ≥ 41% và tắt khi < 40%). Khoảng cách 1% này tương ứng với độ biến thiên khoảng cách vật lý:

∆dband = 1% × 45.0 cm = 0.45 cm = 4.5 mm | (3.6)

Khoảng cách 4.5 mm này nhỏ hơn biên độ sóng vỗ tự nhiên trên mặt hồ thu khi máy bơm công suất lớn vận hành (±10 − 20 mm) và ngang bằng với sai số đo lường của cảm biến. Hậu quả là máy bơm vẫn bị bật/tắt liên tục (chattering) khi mặt nước dâng mấp mé ngưỡng 40%.
Để khắc phục triệt để, hệ thống áp dụng dải trễ Hysteresis biên độ 3% chuẩn hóa trên toàn bộ các ngưỡng:

Cặp ngưỡng NORMAL / WARNING: Ngưỡng lên là 21% (d ≤ 40.55 cm); ngưỡng rút hạ trạng thái là 18% (d > 41.90 cm) → Dải trễ ∆ = 3% = 1.35 cm.

Cặp ngưỡng WARNING / DANGER: Ngưỡng lên là 41% (d ≤ 31.55 cm); ngưỡng rút hạ trạng thái là 38% (d > 32.90 cm) → Dải trễ ∆ = 3% = 1.35 cm.

Cặp ngưỡng DANGER / CRITICAL: Ngưỡng lên là 71% (d ≤ 18.05 cm); ngưỡng rút hạ trạng thái là 68% (d > 19.40 cm) → Dải trễ ∆ = 3% = 1.35 cm.

Đặc thù khi triển khai trên mô hình sa bàn Mica thu nhỏ (10 cm nước): Trên mô hình sa bàn thực tế, dải trễ 3% tương ứng với khoảng dịch chuyển mực nước vật lý chỉ đạt ∆dmica = 3% × 10.0 cm = 3.0 mm. Khoảng cách 3.0 mm này tiệm cận với độ phân giải giới hạn của cảm biến siêu âm HC-SR04 và hoàn toàn có thể bị vượt qua bởi các đợt sóng dập dềnh cơ học khi máy bơm mini xả nước. Do đó, nếu chỉ dựa thuần túy vào dải trễ biên độ 3%, rơ-le vẫn có nguy cơ bị đóng ngắt dao động.

Để giải quyết triệt để vấn đề này trên phần cứng thực tế, chốt chặn bảo vệ quyết định của hệ thống chính là sự kết hợp chặt chẽ giữa dải trễ biên độ với **bộ lọc chống rung thời gian Debounce 1.0 s** và **thời gian chạy tối thiểu của máy bơm 5.0 s (Min-run Time)** được phân tích dưới đây.

### 3.4.2 Cơ Chế Chống Rung Theo Thời Gian (Time-Based De- bouncing & Dwell Time)

Song song với dải trễ biên độ, hệ thống bổ sung hai ràng buộc thời gian nghiêm ngặt:

1. Bộ lọc chống rung thời gian chuyển trạng thái (Transition Debouncing): Điều kiện chuyển trạng thái phải được duy trì liên tục trong thời gian tối thiểu tdebounce = 1.0 s (tương đương 5 chu kỳ lấy mẫu liên tiếp). Nếu mặt nước chỉ vọt lên trong chốc lát do một gợn sóng bất chợt rồi tụt xuống ngay, FSM sẽ bỏ qua và không kích hoạt đổi trạng thái.
2. Thời gian vận hành tối thiểu của máy bơm (Minimum Run/Dwell Time): Khi máy bơm được kích hoạt bật, nó bắt buộc phải chạy tối thiểu tmin_run = 5.0 s trước khi được phép ngắt, ngay cả khi mực nước tụt xuống dưới ngưỡng tắt tức thì. Cơ chế này giúp bảo vệ cuộn hút Relay và giảm thiểu tối đa hiện tượng quá nhiệt động cơ do dòng điện khởi động lặp lại liên tục.

### 3.4.3 Đồ Thị So Sánh Đáp Ứng Khi Có và Không Có Hysteresis

Hình 3.2 minh họa kết quả mô phỏng đáp ứng của rơ-le máy bơm khi mực nước dao động hình sin quanh biên ngưỡng 40%.


Hình 3.2: So sánh đáp ứng điều khiển máy bơm: Không có Hysteresis (A) và Có Hysteresis (B)

Ở trường hợp A (không có dải trễ), rơ-le máy bơm bị đóng ngắt tới 8 lần trong vòng 10 giây, gây tổn hại cơ học và nguy cơ cháy tiếp điểm. Ở trường hợp B (áp dụng Hysteresis kết hợp Debouncing), máy bơm chỉ đóng dứt khoát 1 lần khi nước vượt 41% và chỉ ngắt khi nước rút sâu ổn định dưới 38%.

### 3.4.4 Thuật Toán Điều Khiển Mượt Servo Van Xả (Soft PWM Stepping)

Để tránh hiện tượng động cơ Servo quay giật đột ngột từ 0

◦

lên 180◦
trong 1 chu kỳ điều
khiển (gây rung lắc gãy khớp nối cơ khí cửa van và tiêu thụ dòng đỉnh lớn gây sụt áp nguồn), hệ thống áp dụng bộ giới hạn tốc độ quay (Slew-rate Limiter ):
1 | // Noi suy goc quay Servo muot ma moi 20 ms
2 | if ( currentAngle < targetAngle ) {
3 | currentAngle += 5; // Tang moi buoc 5 do
4 | if ( currentAngle > targetAngle ) currentAngle = targetAngle ;
5 | valveServo . write ( currentAngle ) ;
6 | } else if ( currentAngle > targetAngle ) {
7 | currentAngle -= 5; // Giam moi buoc 5 do
8 | if ( currentAngle < targetAngle ) currentAngle = targetAngle ;
9 | valveServo . write ( currentAngle ) ;
10 | }
Thuật toán chia hành trình 180◦
thành 36 bước nhỏ cách nhau 20 ms, giúp van xả mở êm ái trong khoảng thời gian 0.72 s.

## 3.5 Chế Độ Vận Hành AUTO / MANUAL & Bảo Vệ

## Failsafe

### 3.5.1 Máy Trạng Thái Quản Lý Chế Độ Vận Hành

Hệ thống quản lý 3 trạng thái chế độ hoạt động:

AUTO_MODE: Chế độ mặc định. Quyền điều khiển máy bơm và van xả do thuật toán FSM quyết định tự động 100%. Mọi nút can thiệp cưỡng chế trên Web Dashboard đều bị khóa mờ.

MANUAL_MODE: Chế độ can thiệp thủ công. Người vận hành được phép bật/tắt bơm và xoay góc van xả tùy ý thông qua Web Dashboard để phục vụ kiểm tra thiết bị hoặc xả đáy hồ.

FAILSAFE_MODE: Trạng thái chuyển đổi khẩn cấp khi hệ thống phát hiện mất kết nối mạng điều khiển từ xa.

3.5.2 | Cơ Chế Heartbeat & Căn Cứ Chọn Timeout 30 Giây
| Định nghĩa Heartbeat: Trong kiến trúc của FloodGuard, trình duyệt Web Dash-
board liên tục gửi yêu cầu GET /api/status mỗi 1000 ms (1 s). Mỗi khi nhận được request này, vi điều khiển cập nhật biến dấu thời gian:
tlast_heartbeat = millis() | (3.7)

Yêu cầu polling dữ liệu này vừa làm nhiệm vụ cập nhật giao diện, vừa đóng vai trò như một gói tin điểm danh (Keep-alive Heartbeat).

| Cơ chế kích hoạt Failsafe: Trong hàm loop(), hệ thống liên tục kiểm tra:
∆toffline = millis() − tlast_heartbeat | (3.8)

Nếu hệ thống đang ở MANUAL_MODE mà ∆toffline > 30000 ms (30 s), vi điều khiển ngay lập tức cưỡng chế thiết lập lại:

isAutoMode = true | (3.9)
| Lý do lựa chọn ngưỡng 30 s: Khoảng thời gian 30 s tương đương với 30 chu kỳ
heartbeat bị mất liên tiếp. Con số này đủ dài để bỏ qua các hiện tượng rớt mạng tạm thời do nhiễu sóng Wi-Fi (2 − 5 s) hoặc khi người dùng vô tình xoay màn hình điện thoại khiến trình duyệt reload, nhưng đủ ngắn để đảm bảo rằng nếu trạm đang bị dâng nước nhanh trong mưa bão, mực nước sẽ không thể dâng vượt quá dung tích hồ thu trước khi hệ thống tự động tiếp quản.

### 3.5.3 Hành Vi Khôi Phục Kết Nối & Quy Tắc Ghi Đè An Toàn Tối Cao

Khôi phục kết nối: Khi mạng Wi-Fi được kết nối lại và trình duyệt gửi request tiếp theo, ESP32 sẽ trả về chuỗi JSON chứa trường cờ "failsafe": true. Giao diện Web Dashboard sẽ lập tức hiển thị một thanh thông báo màu cam với nội dung: *"Hệ thống đã tự động chuyển về chế độ AUTO do mất kết nối quá 30 giây"*. Để tiếp tục can thiệp thủ công, người vận hành bắt buộc phải nhấp nút xác nhận trên Web để chuyển lại sang MANUAL.

Quy tắc ghi đè an toàn tối cao (Safety Priority Override): Ngay cả khi đang ở chế độ MANUAL, nếu mực nước đo được đạt mức nguy cấp CRITICAL (≥ 71%) mà sau 10 s người vận hành không ra lệnh bật bơm hoặc mở van, hệ thống sẽ tự động tước quyền MANUAL, chuyển về AUTO và kích hoạt toàn bộ cơ cấu xả lũ hết công suất để chống tràn hồ.

## 3.6 Phân Tích Đặc Tính Thời Gian Thực (Real-Time Performance Analysis)

### 3.6.1 Chu Kỳ Vòng Lặp Thực Tế & Đánh Giá Độ Trễ

Thời gian thực thi một chu kỳ vòng lặp loop() được đo đạc thực tế bằng hàm micros() trên vi điều khiển ESP32:

Khi không có kết nối Web (Chu kỳ nền): Thời gian chạy một vòng lặp chỉ mất 2 − 5 ms, phần lớn thời gian CPU ở trạng thái rảnh hoặc thực thi băm xung nhịp còi.

Tại chu kỳ trích mẫu cảm biến (mỗi 150 ms): Mất khoảng 36−38 ms (chủ yếu là thời gian đo xung ToF của cảm biến siêu âm qua hàm pulseIn()).

Khi xử lý yêu cầu HTTP JSON: Mất khoảng 8 − 15 ms để đọc thông số, định dạng chuỗi JSON và gửi qua ngăn xếp TCP/IP.

### 3.6.2 Thời Gian Phản Ứng Tối Đa (Worst-Case Reaction Time

### - WCRT)

Thời gian phản ứng tồi tệ nhất trong tình huống khẩn cấp (TWCRT_urgent) được tính từ thời điểm mực nước thực tế chạm ngưỡng nguy hiểm hoặc ngập tràn khẩn cấp cho tới khi tiếp điểm Relay đóng hoàn toàn để cấp điện cho máy bơm (không qua bộ lọc thời gian debounce hoặc khi debounce đã tích lũy đủ):

TWCRT_urgent = Tsample_wait + Tfilter_typical + TFSM + Trelay_delay | (3.10)

Trong đó:

| Tsample_wait = 150 ms: Thời gian chờ tối đa giữa hai chu kỳ kích hoạt đọc cảm biến.
| Tfilter_typical = 36 ms: Thời gian đo 3 mẫu siêu âm của bộ lọc trung vị trong điều
kiện bình thường (3 × 12 ms).
| TFSM = 2 ms: Thời gian tính toán thuật toán FSM và cập nhật chân GPIO.
| Trelay_delay = 15 ms: Thời gian trễ cơ học để tiếp điểm lá đồng của Relay 5V đóng
kín hoàn toàn mạch điện.

Tổng thời gian phản ứng khẩn cấp:

TWCRT_urgent = 150 + 36 + 2 + 15 = 203 ms < 250 ms | (3.11)

Kết quả chứng minh hệ thống đáp ứng xuất sắc ràng buộc thời gian thực ≤ 250 ms đối với các tình huống phản ứng khẩn cấp, đảm bảo máy bơm được kích hoạt gần như tức thời khi nước vừa chạm ngưỡng tràn.
Thời gian đáp ứng ổn định có lọc chống rung (Debounced Stable Transition): Đối với quá trình chuyển trạng thái FSM thông thường giữa các cấp độ nhằm tránh rung tiếp điểm rơ-le do sóng vỗ dao động, điều kiện chuyển trạng thái cần được duy trì ổn định liên tục qua bộ lọc thời gian tdebounce = 1.0 s. Do đó, thời gian đáp ứng tổng thể của hệ thống khi xác lập trạng thái chuyển cấp FSM bền vững là:
Tstable = TWCRT_urgent + tdebounce ≈ 203 ms + 1000 ms ≈ 1.203 s | (3.12)

Việc phân định rõ hai mốc thời gian này giúp hệ thống vừa bảo đảm an toàn cơ học cho rơ-le trong vận hành thông thường, vừa bảo đảm thời gian phát hiện và xử lý khẩn cấp dưới 250 ms.
Phân tích độ trễ chặn luồng tối đa khi mất tín hiệu siêu âm:
Cần lưu ý rằng hàm pulseIn() trong ESP32 Arduino Core là hàm chặn CPU (blocking). Trong kịch bản xấu nhất khi cảm biến siêu âm bị mất xung Echo hoàn toàn, mỗi lượt đo sẽ phải chờ hết thời gian timeout 30 ms. Với bộ lọc 3 mẫu, CPU sẽ bị chặn tối đa Tfilter_worst = 3 × 30 ms = 90 ms. Ngay cả trong kịch bản tồi tệ này, tổng thời gian chu kỳ quét vẫn nằm trong mức 150 + 90 + 2 = 242 ms < 250 ms trước khi rơi vào cơ chế bảo vệ giữ mẫu.

### 3.6.3 Cơ Chế Phục Vụ Yêu Cầu Mạng Wi-Fi / HTTP

Thư viện WebServer.h của ESP32 Arduino Core hoạt động theo kiến trúc đồng bộ tuần tự (synchronous polling) trên cùng luồng chính loopTask. Trong hàm loop(), lời gọi server.handleClient() thực hiện kiểm tra và xử lý các kết nối socket TCP đang chờ từ lớp mạng lwIP. Trong điều kiện bình thường khi không có yêu cầu mới, hàm trả về quyền điều khiển rất nhanh (< 0.1 ms), không ảnh hưởng đến chu kỳ đo lường.
Tuy nhiên, do hoạt động đồng bộ, nếu máy khách truyền dữ liệu chập chờn (slow client) hoặc gửi yêu cầu vào đúng thời điểm vi điều khiển đang xử lý, thời gian chiếm dụng CPU có thể kéo dài 10 − 30 ms. Để triệt tiêu tối đa hiện tượng trễ vòng lặp này:

Toàn bộ dữ liệu phản hồi API JSON được thu gọn tối đa (≈ 210 byte), truyền trực tiếp trong một khung mạng TCP duy nhất.

Trang Web Dashboard tĩnh được lưu trong bộ nhớ Flash và truyền phát bằng phương thức server.send_P(), tránh hoàn toàn việc cấp phát bộ nhớ động RAM (heap) và giảm thiểu số vòng lặp chờ xử lý.

### 3.6.4 Bảo Vệ Hệ Thống Bằng Phần Cứng Task Watchdog Timer (TWDT)

Khác với cơ chế bảo vệ Failsafe 30 s ở tầng ứng dụng mạng Web (Mục 3.5), để phòng ngừa tình huống vi điều khiển bị treo CPU do sốc điện, xung nhiễu nguồn hoặc bẫy lặp phần
mềm vô hạn, FloodGuard tích hợp trực tiếp bộ giám sát Task Watchdog Timer (TWDT)
của hệ điều hành thời gian thực ESP-IDF FreeRTOS.
Bộ giám sát TWDT được gắn vào tác vụ chính loopTask thông qua API esp_task_wdt_add(NULL) với chu kỳ timeout được cấu hình là 3000 ms (3 s). Lệnh xóa cờ esp_task_wdt_reset()
được gọi đều đặn ở đầu mỗi chu kỳ loop(). Nếu sau 3 s vòng lặp không thể quay lại điểm
xóa cờ (ví dụ do hàm pulseIn() bị treo phần cứng hoặc hàm Web bị nghẽn socket), ngắt
phần cứng TWDT sẽ ngay lập tức được kích hoạt, ghi lại nhật ký lỗi (core dump) và thực hiện Reset phần cứng tự động để đưa toàn bộ trạm về trạng thái an toàn ban đầu.

## 3.7 Xử Lý Sự Cố & Ma Trận An Toàn (Fault Handling Matrix)

Bảng 3.6 tổng hợp toàn bộ các kịch bản lỗi phần cứng và phần mềm, cùng các phản ứng xử lý an toàn tương ứng được cài đặt sẵn trong firmware.

Bảng 3.6: Ma trận xử lý sự cố và trạng thái an toàn của trạm FloodGuard

Tình huống sự cố | Cơ chế phát hiện | Hành vi ứng phó an toàn của hệ thống
HC-SR04 mất xung Echo (đứt dây, bám bẩn màng loa) | pulseIn() trả về 0 hoặc quá timeout 30 ms. | Giữ mẫu hợp lệ gần nhất trong 3 chu kỳ (450 ms). Nếu lỗi kéo dài ≥ 3 chu kỳ: chuyển sang SENSOR_FAULT, còi bíp cảnh báo lỗi, ngắt máy bơm tránh chạy cạn, mở van xả 50% phòng ngừa ngập úng. Tự động phục hồi về FSM bình thường khi có ≥ 5 mẫu siêu âm hợp lệ liên tiếp.
Mực nước dâng vượt miệng cảm biến (d < dfull) | Cảm biến đo khoảng cách < 5.0 cm. | Đây là tình huống ngập tràn khẩn cấp (water surge), hệ thống lập tức cưỡng chế FSM lên trạng thái CRITICAL, bật bơm hết công suất và mở van xả 100% để thoát lũ, không xem là lỗi cảm biến.
Khoảng cách ngoài dải đáy bể (d > dempty) | Cảm biến đo khoảng cách > 50.0 cm. | Bể cạn hoàn toàn hoặc đáy sâu bất thường; hệ thống tự động kẹp (clamp) giá trị về 0%, ngắt bơm ngay lập tức để chống chạy khô.
Cảm biến mưa hở mạch / đứt dây tín hiệu AO | Chân GPIO35 (Input-only, không pull-up nội) bị thả nổi. | Nếu thả nổi, ADC có thể đọc ngẫu nhiên về mức thấp kích hoạt nhầm isSubmerged. Thiết kế phần cứng bắt buộc gắn trở kéo ngoài 100 kΩ lên 3.3 V để khi đứt dây, ADC luôn đọc 4095 (khô ráo), hệ thống tự hành an toàn dựa vào mực nước siêu âm.
Mất kết nối Wi-Fi / Đứt mạng Web Client | Không nhận được gói tin heartbeat quá 30 s. | Tự động hủy chế độ MANUAL, cưỡng chế chuyển về AUTO, trao quyền cho FSM để tự hành chống tràn bể.
Sụt áp nguồn cấp (Brown-out) | Điện áp vi điều khiển tụt dưới ngưỡng 2.8 V. | Bộ giám sát Brown-out Reset nội của ESP32 tự động ngắt vi điều khiển và khởi động lại an toàn khi nguồn ổn định.

# Chương 4

# Giao Diện Web Dashboard & Tích Hợp Hệ Thống IoT

## 4.1 Tổng Quan Kiến Trúc Mạng & Chế Độ Hoạt

## Động

### 4.1.1 Cấu Hình Mạng Không Dây Nội Bộ SoftAP

Trong kiến trúc của trạm chống ngập FloodGuard, vi điều khiển ESP32 được cấu hình hoạt động ở chế độ trạm phát không dây độc lập (Software Access Point - SoftAP Mode). Đây là giải pháp tối ưu cho các trạm quan trắc dã chiến ngoài thực địa:

Độc lập hoàn toàn với hạ tầng mạng bên ngoài: Hệ thống tự phát sóng Wi-Fi riêng mà không cần kết nối tới Internet hay phụ thuộc vào các bộ định tuyến Router dân dụng (vốn rất dễ mất điện hoặc đứt cáp quang trong bão lũ).

| Tên mạng truy cập (SSID): FloodGuard_AP.
| Chuẩn bảo mật & Mật khẩu: WPA2-PSK với mật khẩu mặc định 12345678
(đáp ứng tiêu chuẩn an toàn tối thiểu 8 ký tự).

Địa chỉ mạng cục bộ (Local Gateway IP): Cổng mặc định 192.168.4.1, cùng mặt nạ mạng con 255.255.255.0.

Hỗ trợ dịch vụ tên miền đa hướng (mDNS): Hệ thống tích hợp giao thức mDNS (Multicast DNS) thông qua thư viện ESPmDNS.h. Người vận hành chỉ cần nhập địa chỉ tên miền cục bộ dễ nhớ:

http://floodguard.local | (4.1)

vào thanh địa chỉ trình duyệt thay vì phải ghi nhớ chuỗi số IP tĩnh.

## 4.2 Bố Cục Giao Diện Người Dùng Dark Glassmor-

## phism

Giao diện Web Dashboard được thiết kế theo ngôn ngữ hiện đại Dark Glassmorphism (nền tối kết hợp hiệu ứng kính mờ trong suốt), tối ưu hóa hiển thị tự co giãn (Responsive Design) trên cả điện thoại di động và máy tính bảng (Hình 4.1).

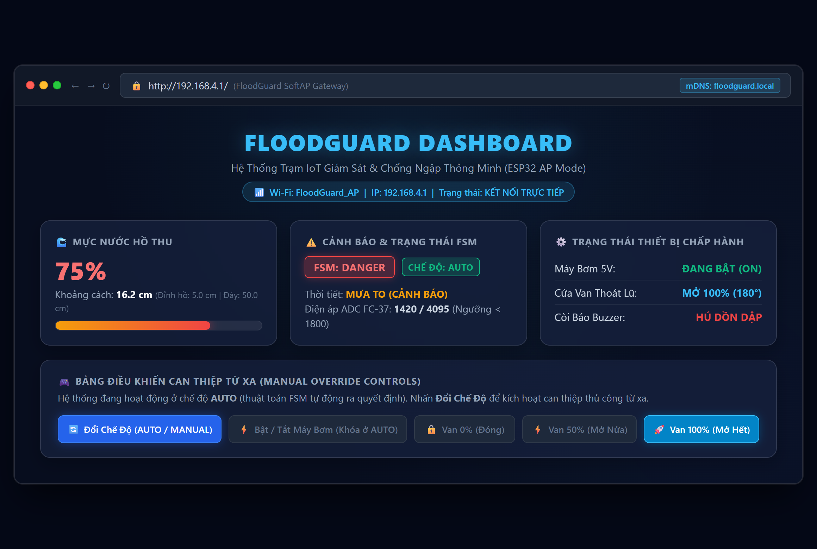
[picture p20: figure]

Hình 4.1: Giao diện Web Dashboard thời gian thực của trạm FloodGuard

Giao diện trực quan bao gồm 6 khối chức năng chính:

1. Khối tiêu đề & Huy hiệu kết nối (Header Badge): Hiển thị tên trạm, chế độ kết nối mạng SoftAP và địa chỉ IP làm việc hiện thời.
2. Khối giám sát mực nước hồ thu (Water Level Card): Hiển thị số đo phần trăm dung tích hồ thu cỡ lớn (0% − 100%), khoảng cách vật lý từ cảm biến tới mặt nước theo đơn vị cm và thanh tiến trình đồ họa đổi màu tương ứng (Xanh: NORMAL, Vàng: WARNING, Đỏ: DANGER/CRITICAL).
3. Khối cảm biến lượng mưa & Trạng thái FSM (Rain & State Card): Cập nhật phân loại thời tiết theo 4 cấp độ (Khô ráo, Mưa nhỏ, Mưa to, Ngập nước), hiển thị điện áp ADC 12-bit thô và huy hiệu màu sắc phản ánh trạng thái logic FSM hiện hành.
4. Khối giám sát cơ cấu chấp hành (Actuators Status Card): Hiển thị chi tiết tình trạng đóng/ngắt của máy bơm 5V (ĐANG BẬT / ĐÃ TẮT), góc mở của van xả lũ (Đóng kín 0%, Mở vừa 50%, Mở tối đa 100%) và mức cảnh báo của còi hú.
5. Khối nút bấm chuyển chế độ (Mode Toggle): Nút bấm chuyển đổi qua lại giữa chế độ vận hành tự động (AUTO) và can thiệp thủ công (MANUAL).
6. Khối nút bấm can thiệp cưỡng chế (Manual Override Controls): Gồm nút Bật/Tắt máy bơm mini và bộ 3 nút điều chỉnh góc mở cửa van (0

◦

, 90◦

, 180◦
). Các
nút này chỉ được phép kích hoạt khi hệ thống đang ở chế độ MANUAL.

## 4.3 Đặc Tả Chuẩn Hóa Giao Thức HTTP REST API

Hệ thống giao tiếp hai chiều giữa trình duyệt người dùng và vi điều khiển ESP32 thông qua các endpoint REST API được chuẩn hóa trong Bảng 4.1. Nhằm khắc phục triệt để nguy cơ đảo ngược trạng thái ngoài ý muốn khi truyền tin mạng, firmware hỗ trợ song song hai định dạng: cú pháp tham số tường minh (Explicit State Parameters – khuyến nghị) và cú pháp hành động (Action-based Tokens).

Bảng 4.1: Bảng đặc tả các giao diện lập trình ứng dụng HTTP REST API của trạm FloodGuard

Endpoint URL | Method | Tham số truyền | Mã HTTP | Cấu trúc dữ liệu phản hồi & Chức năng
/ | GET | Không có | 200 | Trả về toàn bộ mã nguồn của trang Dash-board lưu trong bộ nhớ Flash.
/api/status | GET | Không có | 200 | Trả về chuỗi JSON chứa toàn bộ dữ liệu telemetry đo đạc thời gian thực và trạng thái thiết bị.
/api/control | GET | mode=auto / mode=manual pump=1 / pump=0 | 200 200 | Thiết lập chế độ hoạt động tường minh (Idempo-tent). Bật (1) hoặc tắt (0) máy bơm tường minh (chỉ ở MAN-UAL, Idempo-

HTML/CSS/JS

tent).

valve=0 / valve=50 / valve=100 | 200 | Đặt | góc
| | mở | van
xả tương

### 4.3.1 Cấu Trúc Gói Tin JSON Telemetry Chi Tiết

Tại endpoint GET /api/status, vi điều khiển ESP32 đóng gói các tham số vận hành vào một đối tượng JSON nhỏ gọn:

1 | {
2 | " waterPercent ": 75 ,
3 | " distance ": 16.2 ,
4 | " isRaining ": true ,
5 | " rainRaw ": 1420 ,
6 | " rainLevel ": " MUA_TO ( DANGER )",
7 | " sysState ": " CRITICAL ",
8 | " isAuto ": true ,
9 | " pump ": true ,
10 | " valve ": 100 ,
11 | " buzzer ": " HU_LIEN_TUC ",
12 | " failsafe ": false
13 | }
4.4 | Phân Tích Cải Tiến Thiết Kế API & Hạn Chế

## Của Phương Thức GET

### 4.4.1 Phân Tích Rủi Ro Kỹ Thuật Khi Sử Dụng Phương Thức GET Cho Lệnh Điều Khiển

Trong kiến trúc phần mềm RESTful chuẩn mực quốc tế (RFC 7231):

Phương thức GET được định nghĩa là phương thức an toàn (Safe) và có tính bảo lưu trạng thái (Idempotent) – nghĩa là các yêu cầu GET chỉ được dùng để truy vấn dữ liệu mà tuyệt đối không được làm thay đổi trạng thái tài nguyên trên máy chủ.

Việc phiên bản thực nghiệm ban đầu sử dụng request GET /api/control đi kèm tham số hành động dạng đảo trạng thái (như action=pump_toggle) tiềm ẩn các rủi ro vận hành và an ninh mạng nghiêm trọng:

1. Mất tính toàn vẹn trạng thái khi gửi trùng gói (Non-Idempotency & Packet Duplication): Nếu sóng Wi-Fi chập chờn khiến trình duyệt tự động gửi lại request hoặc người dùng nhấp đúp chuột, lệnh đảo trạng thái pump_toggle sẽ bị thực thi hai lần liên tiếp – biến hành động mong muốn ”Bật bơm” thành ”Bật rồi Tắt ngay lập tức”. Để loại bỏ rủi ro này, firmware FloodGuard đã chuẩn hóa bổ sung cú pháp truyền trạng thái đích tường minh (pump=1 hoặc pump=0, mode=auto hoặc mode=manual). Cú pháp này bảo đảm tính Idempotent: dù request có bị gửi lặp lại nhiều lần, trạng thái cuối cùng của thiết bị vẫn hoàn toàn chính xác.
2. Cơ chế nạp trước liên kết của trình duyệt (Browser Link Prefetch-ing): Một số trình duyệt web hiện đại có tính năng tự động gửi ngầm các request GET đối với các đường dẫn xuất hiện trong trang để tăng tốc độ lướt web. Điều này có thể vô tình kích hoạt bật/tắt máy bơm mà người dùng không hề hay biết.

3. Bộ đệm trình duyệt (HTTP Caching): Trình duyệt hoặc proxy mạng có thể lưu lại kết quả của lệnh GET trước đó và trả về kết quả đệm thay vì gửi lệnh thực sự tới ESP32, dẫn tới sai lệch trạng thái điều khiển.
4. Lịch sử duyệt web (Browser History & Bookmarking): Người dùng vô tình bookmark hoặc mở lại lịch sử URL có thể gửi lại lệnh bật bơm ngoài ý muốn.

### 4.4.2 Giải Pháp Chuẩn Hóa Kiến Trúc API Cho Phiên Bản

### Công Nghiệp

Báo cáo thẳng thắn nhìn nhận đây là một hạn chế kỹ thuật trong phiên bản mô hình thử nghiệm ban đầu (Proof of Concept). Trong phiên bản hoàn thiện triển khai công nghiệp, hệ thống được quy hoạch nâng cấp toàn diện:

Chuyển đổi toàn bộ các lệnh can thiệp phần cứng sang phương thức POST tại endpoint /api/control với dữ liệu truyền trong thân gói tin (Request Body) dưới định dạng JSON:

1 | POST / api / control HTTP /1.1
2 | Content - Type : application / json
3 | Authorization : Bearer < JWT_SECURITY_TOKEN >

4
5 | {
6 | " targetDevice ": " pump ",
7 | " commandState ": "ON",
8 | " authConfirm ": true
9 | }

10

Tích hợp cơ chế mã thông báo chống giả mạo yêu cầu chéo trang (Anti-CSRF Token) và kiểm tra quyền quản trị trước khi vi điều khiển thực thi lệnh chuyển mạch GPIO.

## 4.5 Sơ Đồ Tuần Tự (Sequence Diagram) Tương Tác

## Web

Mối quan hệ tương tác thời gian giữa Người vận hành (trình duyệt Web), máy chủ ESP32 Web Server và cơ cấu chấp hành phần cứng được mô hình hóa qua hai luồng nghiệp vụ trong Hình 4.2.

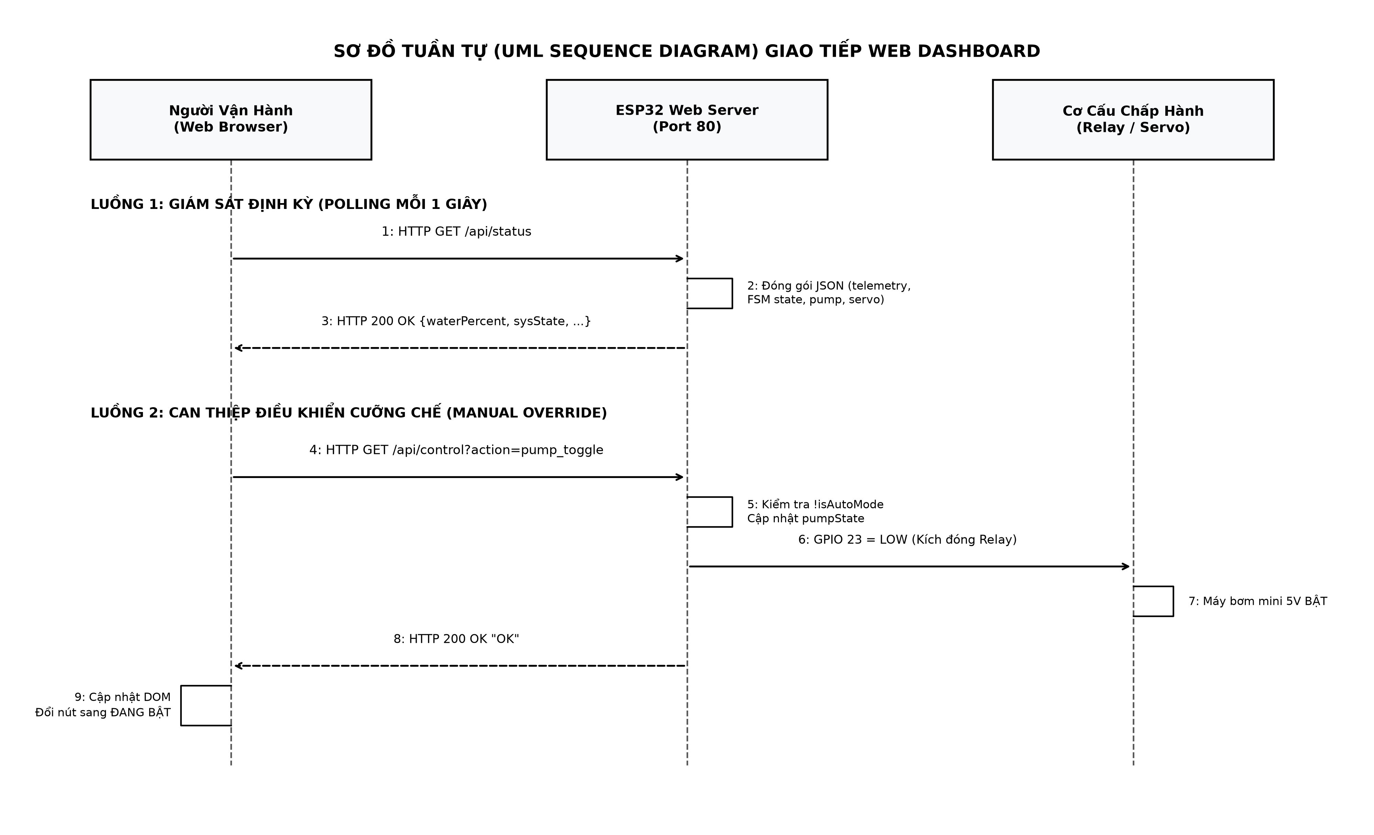
[picture p21: figure]

Hình 4.2: Sơ đồ tuần tự (UML Sequence Diagram) hai luồng nghiệp vụ giám sát và điều khiển Web

1. Luồng 1 – Giám sát đo đạc tuần hoàn (Polling Telemetry Loop): Trình duyệt JavaScript tự động kích hoạt hàm fetch(’/api/status’) đều đặn mỗi 1000 ms. Vi điều khiển đọc dữ liệu cảm biến sạch, đóng gói chuỗi JSON và phản hồi mã HTTP 200 OK. Phía trình duyệt bóc tách JSON và cập nhật thanh đo mực nước, góc mở van xả và thẻ huy hiệu tương ứng.
2. Luồng 2 – Can thiệp điều khiển người dùng (Command Dispatch): Khi kỹ thuật viên nhấp nút (ví dụ Bật bơm), trình duyệt gửi lệnh GET /api/control với tham số action=pump_toggle. ESP32 kiểm tra tiền điều kiện !isAutoMode; nếu hợp lệ, chân GPIO 23 ngay lập tức được kéo xuống mức LOW để đóng rơ-le bật máy bơm, sau đó phản hồi chuỗi xác nhận "OK". Giao diện Web lập tức chuyển màu nút sang màu xanh chỉ báo ”ĐANG BẬT”.
4.6 | Logic Điều Khiển Trên Giao Diện Người Dùng
4.6.1 | Cơ Chế Khóa Nút Tránh Xung Đột (UI Button Locking)

Để triệt tiêu hoàn toàn nguy cơ người vận hành can thiệp trái phép hoặc gây xung đột với thuật toán FSM:

Khi hệ thống ở chế độ AUTO: Toàn bộ 4 nút điều khiển cưỡng chế (Nút bật/tắt bơm và 3 nút góc mở van) được gán thuộc tính disabled = true, độ trong suốt giảm xuống 45% (opacity: 0.45) và con trỏ chuột chuyển thành biểu tượng cấm thao tác (cursor: not-allowed). Người dùng chỉ có thể quan sát thông số mà không thể can thiệp sai lệch.

Khi chuyển sang chế độ MANUAL: Các nút lập tức được kích hoạt sáng rõ, cho phép người dùng nhấp thao tác bình thường.

### 4.6.2 Cập Nhật Lạc Quan (Optimistic UI Update) & Cảnh Báo Mất Mạng

Cập nhật giao diện tức thời (Optimistic UI): Nhằm tạo trải nghiệm mượt mà không có cảm giác trễ mạng, ngay khi người dùng nhấp phím, giao diện Web lập tức đổi trạng thái nút bấm đồ họa trên màn hình song song với việc gửi request bất đồng bộ tới ESP32 ngầm bên dưới.

Chỉ báo mất kết nối mạng (Offline Indicator): Nếu sau 3 chu kỳ gửi tin liên tiếp (3 s) mà trình duyệt không nhận được tín hiệu phản hồi HTTP từ trạm ESP32, giao diện Web tự động làm mờ toàn bộ màn hình và hiển thị một thanh thông báo cảnh báo màu đỏ nổi bật: ”Mất kết nối với trạm FloodGuard! Vui lòng kiểm tra lại kết nối Wi-Fi.”

## 4.7 Kỹ Thuật Lưu Trữ Web Dashboard Trong Flash & Tối Ưu Bộ Nhớ

Để phục vụ giao diện người dùng mà không cần trang bị thêm thẻ nhớ microSD cồng kềnh, toàn bộ mã nguồn của trang web (gồm tài liệu HTML, định dạng CSS phong cách Dark Glassmorphism và mã logic JavaScript) được tích hợp trong một chuỗi hằng số duy nhất:

1 | const char HTML_DASHBOARD [] PROGMEM = R" rawliteral (
2 | <! DOCTYPE html >
3 | <html lang ="vi">
4 | ... [Ma nguon HTML / CSS / JS ~14.2 KB] ...
5 | </html >
6 | ) rawliteral ";
| Cơ chế bộ nhớ Flash trên ESP32: Khác với vi điều khiển AVR 8-bit (như
Arduino Uno) đòi hỏi từ khóa PROGMEM và các hàm truy xuất đặc biệt, ESP32 sở hữu khối quản lý bộ nhớ phần cứng (MMU) có khả năng ánh xạ trực tiếp phân vùng Flash vào không gian địa chỉ bộ nhớ tuyến tính của CPU (vùng DROM / IROM). Khai báo const char[] giúp trình biên dịch đặt toàn bộ chuỗi 14.2 KB vào phân vùng .rodata trong bộ nhớ Flash mà không tiêu tốn RAM khi khởi động.

Truyền phát trực tiếp bằng server.send_P(): Trong hàm phục vụ yêu cầu gốc handleRoot(), vi điều khiển gọi server.send_P(200, "text/html", HTML_DASHBOARD). Phương thức này đọc và truyền thẳng các đoạn dữ liệu từ Flash vào bộ đệm socket mạng TCP/IP của lwIP mà không cần cấp phát thêm một chuỗi đệm tạm thời trên heap RAM.

Triệt tiêu hiện tượng phân mảnh RAM (Heap Fragmentation): Nhờ cơ chế zero-copy streaming của send_P(), hệ thống tránh hoàn toàn việc cấp phát và giải phóng liên tục 14.2 KB bộ nhớ động mỗi khi có client tải trang, duy trì tính ổn định tuyệt đối cho vi điều khiển trong quá trình vận hành dài hạn.

4.8 | An Ninh Bảo Mật & Hiệu Năng Truyền Thông
4.8.1 | Đánh Giá An Ninh Mạng & Hạn Chế Hiện Tại
| Lớp bảo vệ tầng liên kết dữ liệu: Trạm phát sóng Wi-Fi SoftAP với chuẩn mã
hóa WPA2-PSK ngăn chặn các thiết bị lạ không có mật khẩu gia nhập mạng nội bộ.

Hạn chế an ninh ở tầng ứng dụng (Application Layer): Trong mô hình thực nghiệm, giao thức HTTP hoạt động không mã hóa trên cổng 80 và chưa cài đặt cơ chế phân quyền tài khoản (chưa có Login/Password trên Web). Do đó, bất kỳ người dùng nào đã gia nhập mạng Wi-Fi nội bộ đều có thể mở Dashboard và gửi lệnh can thiệp trạm.

Kiến nghị nâng cấp bảo mật: Đối với hệ thống chống ngập quy mô thực tế, hệ thống cần bổ sung:

1. Xác thực cơ bản (HTTP Basic Authentication) hoặc trang đăng nhập cấp mã phiên làm việc (Session Token) dành riêng cho kỹ thuật viên được ủy quyền.
2. Cấu hình danh sách lọc địa chỉ vật lý MAC (MAC Filtering) tại tầng phát sóng Wi-Fi để từ chối các thiết bị lạ ngay từ khâu kết nối vô tuyến.
4.8.2 | Đánh Giá Hiệu Năng Truyền Thông Mạng
| Kích thước tải dữ liệu (Payload Size): Chuỗi JSON telemetry trả về tại end-
point /api/status có kích thước trung bình chỉ khoảng 210 bytes, đảm bảo tốc độ truyền tải cực nhanh.

Độ trễ phản hồi qua mạng Wi-Fi SoftAP (Round-Trip Time - RTT): Thực nghiệm đo đạc cho thấy thời gian phản hồi một yêu cầu API trung bình chỉ từ 8 ms đến 18 ms ở khoảng cách 10 m.

Khả năng phục vụ đồng thời (Concurrency Capacity): Máy chủ Web Server nhúng trên chip ESP32 lõi kép có khả năng duy trì phục vụ ổn định đồng thời 3−5 thiết bị cùng mở Dashboard theo dõi liên tục mà không làm tăng độ trễ của tác vụ đo đạc cảm biến và thuật toán FSM.

# Chương 5

# Hướng Dẫn Cài Đặt, Triển Khai và Vận Hành Hệ Thống

Chương này trình bày chi tiết quy trình thực nghiệm từ chuẩn bị môi trường công cụ phát triển, triển khai kiểm thử mô phỏng trên nền tảng Wokwi, đến lắp ráp mạch điện, nạp firmware lên phần cứng thực tế và hướng dẫn kết nối vận hành trạm quan trắc thông qua giao diện Web Dashboard. Cuối chương là bảng kịch bản kiểm thử nghiệm thu và cẩm nang xử lý các sự cố kỹ thuật thường gặp.

## 5.1 Chuẩn Bị Môi Trường và Công Cụ Phát Triển

Để đảm bảo hệ thống có thể biên dịch, nạp mã nguồn và mô phỏng chính xác, nhà phát triển hoặc kỹ thuật viên cần chuẩn bị đầy đủ các công cụ phần mềm và thư viện điều khiển theo các bước sau.

### 5.1.1 Cài Đặt Môi Trường Lập Trình & Quản Lý Dự Án

Dự án FloodGuard được xây dựng trên nền tảng vi điều khiển ESP32 với cấu trúc dự án chuẩn hóa bằng PlatformIO Core (CLI) tích hợp trong Visual Studio Code (hoặc Antigravity IDE):

1. Cài đặt Visual Studio Code: Tải và cài đặt phiên bản mới nhất từ trang chủ chính thức (https://code.visualstudio.com/).
2. Cài đặt tiện ích mở rộng PlatformIO IDE:
| Mở thanh công cụ Extensions trên VS Code (phím tắt Ctrl + Shift + X).
| Tìm kiếm từ khóa PlatformIO IDE (tác giả PlatformIO) và bấm Install.
| Khởi động lại VS Code sau khi hoàn tất để PlatformIO tự động khởi tạo
môi trường Python và toolchain biên dịch cross-compiler cho kiến trúc Xtensa ESP32.
3. Cài đặt tiện ích Wokwi Simulator:

Tìm kiếm tiện ích Wokwi Simulator (wokwi.wokwi-vscode) trên chợ ứng dụng VS Code và chọn Install.

Cấp quyền xác thực tài khoản Wokwi (miễn phí) theo hướng dẫn trên màn hình để kích hoạt tính năng nạp mô phỏng file nhị phân trực tiếp trong môi trường IDE.

### 5.1.2 Cài Đặt Trình Điều Khiển Giao Tiếp Nạp Chip (USB-to-UART Driver)

Khi kết nối bo mạch phần cứng ESP32 DevKit V1 với máy tính qua cổng USB, hệ điều hành cần trình điều khiển cầu chuyển đổi tín hiệu USB sang UART tương ứng với chip giao tiếp trên bo:

Chip Silicon Labs CP2102 / CP2104: Tải driver CP210x USB to UART Bridge VCP Drivers từ trang chủ Silicon Labs.

Chip WCH CH340G / CH340C: Tải driver CH341SER.EXE từ nhà sản xuất WCH.

Kiểm tra cổng COM: Mở Device Manager trên Windows → mục Ports (COM & LPT), đảm bảo cổng kết nối hiển thị rõ ràng (ví dụ: Silicon Labs CP210x USB to UART Bridge (COM3)).

### 5.1.3 Cấu Hình Thư Viện Phụ Thuộc trong platformio.ini

Hệ thống sử dụng các thư viện chuẩn cho vi điều khiển ESP32, được khai báo tự động trong tệp cấu hình platformio.ini:

1 | [ platformio ]
2 | default_envs = esp32dev
3 | src_dir = main

4
5 | [ env: esp32dev ]
6 | platform = espressif32
7 | board = esp32dev
8 | framework = arduino
9 | monitor_speed = 115200
10 | build_src_filter = + < main_wokwi . cpp >
11 | lib_deps =
12 | madhephaestus / ESP32Servo @ ^3.0.5

13
14 | [ env: hardware ]
15 | platform = espressif32
16 | board = esp32dev
17 | framework = arduino
18 | monitor_speed = 115200
19 | build_src_filter = + < main_hardware . cpp >
20 | lib_deps =
21 | madhephaestus / ESP32Servo @ ^3.0.5
Listing 5.1: Cấu hình môi trường biên dịch trong tệp platformio.ini

Trong đó:

WiFi.h và WebServer.h: Thư viện mạng tích hợp sẵn trong bộ framework Arduino Core của ESP32, dùng để khởi tạo mạng phát SoftAP và máy chủ HTTP Web Server.

ESP32Servo: Thư viện tạo xung PWM chính xác dựa trên bộ định thời phần cứng (LEDC / Hardware Timers) của ESP32, đảm bảo góc quay Servo SG90 mượt mà không bị xung đột bộ ngắt với sóng Wi-Fi.

## 5.2 Hướng Dẫn Triển Khai Mô Phỏng Trên Wokwi

Giải pháp mô phỏng trên Wokwi cho phép sinh viên và nhóm nghiên cứu kiểm thử logic trạng thái FSM, dải trễ Hysteresis và các kịch bản báo động khẩn cấp mà không cần linh kiện vật lý.

5.2.1 | Cấu Trúc Tệp Mô Phỏng (diagram.json & wokwi.toml)
| wokwi.toml: Tệp chỉ thị đường dẫn file firmware nhị phân sau khi biên dịch cho
máy ảo Wokwi:
1 | [ wokwi ]
2 | version = 1
3 | firmware = ’. pio / build / esp32dev / firmware . bin ’
4 | elf = ’. pio / build / esp32dev / firmware . elf ’

5
Listing 5.2: Nội dung tệp cấu hình wokwi.toml

diagram.json: Sơ đồ đấu nối ảo định nghĩa tọa độ linh kiện và nối dây giữa các chân GPIO của ESP32 với cảm biến HC-SR04, cảm biến mưa (chiết áp xoay), động cơ Servo SG90, Relay đóng cắt và cụm LED/Buzzer.

### 5.2.2 Quy Trình Biên Dịch và Khởi Chạy Mô Phỏng

1. Biên dịch Firmware mô phỏng: Mở cửa sổ Terminal tại thư mục gốc của dự án và thực hiện lệnh:

1 pio run -e esp32dev

2

Khi thông báo [SUCCESS] xuất hiện, file mã máy firmware.bin đã được ghi thành công vào thư mục .pio/build/esp32dev/.

2. Khởi động trình mô phỏng Wokwi:
| Mở tệp diagram.json trên giao diện soạn thảo VS Code.
| Nhấp chuột vào nút biểu tượng Start Simulation (nút Play màu xanh lá) ở
thanh tiêu đề trình soạn thảo, hoặc nhấn tổ hợp phím F1 → nhập lệnh Wokwi: Start Simulator.
3. Tương tác thực nghiệm trên giao diện ảo:

Cảm biến siêu âm HC-SR04: Nhấp chuột vào cảm biến trên sơ đồ mạch để hiển thị thanh trượt khoảng cách. Kéo thanh trượt từ 50 cm (tương ứng mức nước 0%, cạn nước) về 5 cm (mức nước 100%, tràn bờ) để kiểm tra các ngưỡng FSM chuyển trạng thái.

Cảm biến mưa (Rain Potentiometer): Xoay góc núm vặn biến trở để mô phỏng điện áp ADC từ khô ráo (V > 2.5 V) đến mưa tầm tã (V < 1.0 V).

Thiết bị chấp hành: Quan sát đèn LED đổi màu (Xanh → Vàng → Đỏ), còi hú Buzzer phát nhịp bíp dồn dập, Relay bật sáng đèn đỏ và góc quay động cơ Servo SG90 mở từ 0

- → 90◦ → 180◦

## 5.3 Hướng Dẫn Lắp Ráp và Nạp Firmware Phần Cứng Thực Tế

### 5.3.1 Quy Chuẩn Đấu Nối Phần Cứng & Dẫn Chiếu Sơ Đồ

### Nguyên Lý

Toàn bộ sơ đồ nguyên lý kết nối mạch điện và bảng phân công chân GPIO chi tiết của trạm FloodGuard đã được đặc tả đầy đủ tại Bảng 2.1 và Hình 2.1 thuộc Chương 2. Khi triển khai lắp ráp ngoài thực tế trên breadboard hoặc mạch in PCB, kỹ thuật viên đối chiếu trực tiếp theo các chân tín hiệu đã định nghĩa (HC-SR04 tại GPIO 13/12, cảm biến mưa FC-37 tại GPIO 34/35, Servo SG90 tại GPIO 27, Relay máy bơm tại GPIO 23, cụm LED tại GPIO 18/19/21 và còi Buzzer tại GPIO 4).
Đặc biệt, trong quá trình lắp ráp phần cứng thực nghiệm, cần tuân thủ nghiêm ngặt 3 quy chuẩn an toàn điện sau:

Cấp nguồn độc lập cho Servo và Máy bơm: Động cơ Servo SG90 và máy bơm mini khi khởi động hoặc đảo chiều quay có thể hút dòng đỉnh tức thời (Stall Current) từ 500 mA − 1.2 A. Tuyệt đối không lấy nguồn từ chân 3.3 V hoặc chân 5 V của cổng USB máy tính để nuôi trực tiếp hai thiết bị này, tránh gây sụt áp kích hoạt mạch bảo vệ (Brownout Detector ) làm ESP32 bị reset ngắt quãng. Bắt buộc sử dụng adapter nguồn ngoài DC 5 V − 2 A riêng biệt.

Đồng nhất mức điện áp tham chiếu (Common GND): Nối chung chân cực âm (GND) của bộ nguồn ngoài với chân GND của bo mạch ESP32 để đảm bảo xung điều khiển PWM cho Servo và mức kích logic cho Relay (Active LOW) hoạt động chuẩn xác, không bị sai lệch áp.

Bảo vệ xung quá độ & Hạn dòng: Mắc thêm một tụ hóa 100 µF − 470 µF song song tại hai cực nguồn cấp cho Servo để dập xung nhiễu quá độ, đồng thời đảm bảo các đèn LED chỉ thị luôn nối tiếp qua điện trở hạn dòng R = 220 Ω.

### 5.3.2 Gia Công Mô Hình Mica Mini & Hiệu Chỉnh Dải Đo Thực

Tế

Để trình diễn trực quan tại phòng thí nghiệm, hệ thống được đóng gói thành mô hình sa bàn hai bể (Bể ngập lụt chính và Bể xả lũ phụ) sử dụng vật liệu Mica trong suốt dày 3 mm với kích thước tổng thể 28 × 16 × 22 cm (Bảng 5.1).
Căn chỉnh hình học cho cảm biến HC-SR04:

Loại bỏ vùng mù (< 3 cm): Lòng đáy bể chính nằm ở cao độ 3.3 cm (chân kê 3 cm + đáy 0.3 cm). Giá treo HC-SR04 gắn tại cao độ 19.3 cm cho khoảng cách tới

Bảng 5.1: Bảng quy cách cắt lắp mô hình sa bàn Mica 3 mm tối ưu cho cảm biến HC-SR04

STT | Hạng mục / Bộ phận | Kích thước (cm) | SL | Yêu cầu gia công / Lỗ khoét
1 | Sàn đế chung | 28 × 16 | 1 | Tấm đế phẳng chịu lực chính đỡ 2 bể và vách đứng
2 | Vách đứng (Backboard) | 28 × 22 | 1 | Khoan 3 lỗ ∅5 mm (LED), 1 lỗ ∅9 mm (Buzzer); gắn bo mạch và giá cảm biến ở cao độ 19.3 cm
3 | Mặt đáy bể chính | 14 × 12 | 1 | Khoang chứa nước ngập lụt chính
4 | Thành trước & sau bể chính | 14 × 12 | 2 | Thành bao quanh bể chính cao 12 cm (chừa 2 cm chống tràn mép)
5 | Thành hông trái bể chính | 11.4 × 12 | 1 | Vách cạnh bên trái (đã trừ 2 × 3 mm độ dày mica)
6 | Thành hông phải (Cửa xả) | 11.4 × 12 | 1 | Khoét rãnh cửa xả 2.5 × 2.5 cm (mép dưới cách đáy 4 cm)
7 | Mặt đáy bể phụ (Bể xả lũ) | 12 × 12 | 1 | Khoang hứng nước thoát đặt kế bên
8 | Thành bao quanh bể phụ | 12 × 6 (2 tấm) 11.4 × 6 (2 tấm) | 4 | 4 vách cao 6 cm ghép khít mép với đáy 12 × 12 cm
9 | Giá treo cảm biến HC-SR04 | 10.5 × 5 | 1 | Gập vuông 90◦ tại vạch 2.5 cm gắn vách đứng; phần vươn ngang 8 cm khoét 2 lỗ ∅16.2 mm (tâm cách 26 mm, rơi đúng tâm bể cách vách 6 cm)
10 | Giá treo cảm biến mưa | 6 × 5 | 1 | Uốn gập nghiêng góc 45◦ giúp thoát nước đọng
11 | Cánh sập cửa van (Servo) | 3.5 × 3 | 1 | Gắn vào tay đòn Servo SG90 để đóng/mở cửa xả
12 | Chân kê nâng bể chính | 12 × 3 | 2–3 | Kê nâng bể chính cao thêm 3 cm tạo độ dốc chảy tự do sang bể phụ

đáy cạn là 16.0 cm (0%). Khi nước dâng đầy quy ước 10.0 cm (100%), khoảng cách tới mặt loa vẫn còn 6.0 cm, hoàn toàn nằm ngoài vùng mù vật lý của cảm biến.

Chống dội âm thành bể: Tại khoảng cách đáy H = 16 cm, đường kính nón chùm tia siêu âm (±15◦

) là D = 2×16×tan 15◦ ≈ 8.57 cm < 11.4 cm (chiều rộng lọt lòng bể), đảm bảo sóng âm không va đập vào thành mica.

Hiệu chỉnh hằng số Firmware: Trước khi nạp mã nguồn lên bo mạch cho mô hình Mica mini (main/main_hardware.cpp), cập nhật 2 tham số giới hạn dải đo tương ứng:

1 const float DISTANCE_EMPTY = 16.0; // Khoang cach day be can (cm) -0%
2 | const float DISTANCE_FULL | = 6.0; | // Khoang cach muc nuoc day 10 cm
- 100%

3
Listing 5.3: Cấu hình hằng số dải đo cho mô hình Mica mini trong main_hardware.cpp

### 5.3.3 Quy Trình Nạp Firmware Lên ESP32

1. Sử dụng cáp Micro-USB (có đủ 4 lõi truyền dữ liệu) cắm bo mạch ESP32 vào cổng USB máy tính.
2. Mở cửa sổ Terminal tại thư mục dự án và thực hiện lệnh biên dịch, tự động dò cổng COM và nạp mã máy:

1 pio run -e hardware -t upload

2

Lưu ý: Nếu Terminal dừng lại ở thông báo Connecting......._____....., người vận hành nhấn giữ nút BOOT (IO0) trên mặt bo mạch ESP32 trong 1−2 giây rồi thả ra để ép chip vào chế độ Bootloader nhận nạp flash.

3. Khởi động trình giám sát cổng Serial với tốc độ truyền chuẩn 115200 bps để xem thông tin khởi tạo hệ thống:

1 pio device monitor -b 115200

2
Màn hình Serial Monitor sẽ hiển thị các bản tin xác nhận: Khởi động thành công bộ định thời, cấu hình chân I/O, tạo trạm phát Wi-Fi SoftAP kèm thông số địa chỉ IP máy chủ: 192.168.4.1.

## 5.4 Hướng Dẫn Kết Nối và Vận Hành Web Dash-

## board

### 5.4.1 Kiểm Thử Giao Diện Ngoại Tuyến (Offline Dashboard Preview)

Nhằm mục đích trình diễn giao diện, tối ưu bố cục và kiểm thử khả năng phản hồi trực quan mà không cần bo mạch phần cứng cắm điện, nhóm phát triển đã cung cấp tệp kiểm thử preview_dashboard.html:

1. Mở thư mục dự án FloodGuard và nhấp đúp mở tệp preview_dashboard.html bằng bất kỳ trình duyệt web hiện đại nào (Google Chrome, Microsoft Edge, Safari).
2. Sử dụng thanh công cụ mô phỏng tích hợp ở góc chân trang (Simulation Toolbar ):

Kéo thanh trượt Mực Nước: Kiểm tra sự đổi màu thanh tiến trình, hiển thị nhãn cảnh báo (Xanh: Normal, Vàng: Warning, Đỏ: Danger/Critical).
Chọn các mức Thời Tiết: Kiểm tra khả năng nhận diện mưa nhẹ, mưa lớn và cảnh báo bão.
Bấm nút chuyển AUTO / MANUAL: Thử nghiệm khả năng mở khóa các nút bấm can thiệp cưỡng chế van xả và máy bơm.

### 5.4.2 Kết Nối Mạng Wi-Fi Trạm & Truy Cập Hệ Thống Thực

Tế

Khi trạm phần cứng ESP32 đã nạp firmware và cấp nguồn hoạt động:

1. Sử dụng điện thoại thông minh, máy tính bảng hoặc máy tính xách tay mở phần cài đặt Wi-Fi.
2. Tìm kiếm và chọn kết nối vào mạng phát không dây của trạm:
| Tên mạng (SSID): FloodGuard_AP
| Mật khẩu truy cập: 12345678
3. Mở trình duyệt Web và nhập một trong hai địa chỉ sau vào thanh URL:
http://192.168.4.1 hoặc http://floodguard.local | (5.1)
5.4.3 | Thao Tác Giám Sát và Điều Khiển Cưỡng Chế

Giao diện Dark Glassmorphism sẽ hiển thị trực quan toàn bộ trạng thái vận hành:

Cơ chế cập nhật tự động: Trình duyệt gửi định kỳ yêu cầu AJAX /api/status mỗi 1000 ms, các thông số phần trăm nước, khoảng cách cm, cấp độ mưa và trạng thái FSM được tự động làm mới mà không gây nhấp nháy toàn trang web.

Chuyển chế độ vận hành (Mode Toggle):

– Mặc định hệ thống ở chế độ AUTO (nút hiển thị màu xanh lá). Các cơ cấu chấp hành được thuật toán FSM tự động quyết định.
– Khi nhấn nút chuyển sang MANUAL (nút chuyển sang màu cam), hệ thống bàn giao quyền kiểm soát cho con người. Cụm nút bấm điều khiển bơm và van sẽ chuyển từ trạng thái vô hiệu hóa (disabled) sang trạng thái sẵn sàng nhận lệnh.

Can thiệp đóng mở van & máy bơm:

– Nhấn nút BẬT / TẮT MÁY BƠM: ESP32 nhận lệnh API /api/control?pump=1

(hoặc pump=0, hoặc action=pump_toggle) và kích đóng rơ-le ngay lập tức.
– Thao tác van xả lũ: Nhấn các nút chọn góc van (0%, 50%, hoặc 100%), ESP32 nhận lệnh API (valve=0, valve=50, hoặc valve=100) và điều chế xung PWM xoay góc Servo tương ứng (0

◦

, 90◦

, 180◦
).

## 5.5 Kịch Bản Kiểm Thử và Đánh Giá Thực Nghiệm

Để phục vụ công tác nghiệm thu hệ thống, nhóm nghiên cứu đã xây dựng ma trận kiểm thử toàn diện gồm 6 kịch bản vận hành thực tế được tổng kết trong Bảng 5.2.

Bảng 5.2: Ma trận kịch bản kiểm thử nghiệm thu chức năng hệ thống FloodGuard (Thực hiện 10 lần lặp trên cả Wokwi và mô hình Mica thực tế)

STT | Kịch bản kiểm thử | Điều kiện kích hoạt đầu vào | Phản hồi kỳ vọng của hệ thống | Môi trường | Đánh giá
1 | Mực nước An toàn (NORMAL) | Mực nước < 18% (Mica: d > 14.2 cm; Wokwi: d > 41.9 cm), không mưa (ADC ≥ 3200). | LED Xanh sáng; Còi tắt; Bơm tắt; Cửa ◦ van đóng 0 ; Web hiển thị NORMAL xanh lá. | Wokwi, Mica | ĐẠT
2 | Cảnh báo Dâng nước (WARNING) | Mực nước 21% − 40% (Mica: 12.0 − 13.9 cm; Wokwi: 32.0 − 40.5 cm) hoặc mưa nhỏ (1800 ≤ ADC < 3200). | LED Vàng sáng; Còi bíp ngắt quãng thưa (1.5 s); Bơm tắt; Van đóng 0 ◦ ; Web đổi màu vàng. | Wokwi, Mica | ĐẠT
3 | Cảnh báo Nguy cơ (DANGER) | Mực nước 41% − 70% (Mica: 9.0 − 11.9 cm; Wokwi: 18.5 − 31.5 cm) hoặc mưa lớn (ADC < 1800). | LED Đỏ sáng; Còi bíp dồn dập (400 ms); Bơm tự BẬT (kèm khóa chống cháy cạn P ≥ 20%); Van xả mở 90◦ (50%); Web báo động đỏ. | Wokwi, Mica | ĐẠT
4 | Báo động Nguy cấp (CRITICAL) | Mực nước ≥ 71% (Mica: d ≤ 8.9 cm; Wokwi: d ≤ 18.0 cm), hoặc ngập cảm biến mưa (ADC < 1100), hoặc tràn mép (d < dfull). | LED Đỏ nháy; Còi hú liên tục không ngắt; Bơm chạy toàn tải; Van mở tối đa 180◦ (100%). | Wokwi, Mica | ĐẠT
5 | Kiểm thử Vùng trễ (Hysteresis & Debounce) | Mực nước dao động dập dềnh quanh biên ngưỡng 38% ↔ 41%. | Dải trễ 3% kết hợp Debounce 1.0 s và thời gian bơm chạy tối thiểu 5.0 s giữ FSM ổn định; rơ-le chỉ đóng 1 lần dứt khoát, loại bỏ rung giật relay. | Wokwi, Mica | ĐẠT
6 | Kiểm thử Failsafe & Safety Override | (a) Ở MANUAL, ngắt Wi-Fi quá 30 s. (b) Ở MANUAL, nước đạt ≥ 71% quá 10 s không xử lý. | (a) Tự động hoàn nguyên về AUTO, hiện thông báo Failsafe trên Web. (b) Safety Override cưỡng chế bật bơm và mở van 100% chống tràn. | Wokwi, Mica | ĐẠT

5.6 | Chẩn Đoán và Xử Lý Sự Cố Thường Gặp (Trou-
| bleshooting)

Trong quá trình lắp ráp phần cứng và vận hành tại hiện trường, một số sự cố kỹ thuật có thể phát sinh. Bảng 5.3 tổng hợp các hiện tượng lỗi và quy trình khắc phục tương ứng:

| Bảng 5.3: Cẩm nang chẩn đoán và khắc phục sự cố kỹ thuật thường gặp
Hiện tượng lỗi | Nguyên nhân cốt lõi | Giải pháp khắc phục
Lỗi nạp mã nguồn UART (Failed to connect) | Máy tính không mở được kết nối nạp vào Bootloader của ESP32 do thiếu chân tự kích hoặc trễ tụ nạp. | • Kiểm tra driver nạp CP2102/CH340. • Khi log hiện Connecting......._____....., bấm giữ nút BOOT trong 2 s rồi thả ra. • Đổi cổng USB hoặc thay cáp nạp có bọc chống nhiễu.
ESP32 tự khởi động lại (Brownout detector) | Servo SG90 hoặc Relay hút dòng đỉnh đột biến làm sụt áp nguồn cấp cho ESP32 (< 2.7 V). | • Tuyệt đối không nuôi Servo bằng chân 3V3 của ESP32. • Dùng adapter ngoài DC 5 V − 2 A và nối chung cực GND. • Hàn thêm tụ hóa 220 µF − 470 µF lọc nguồn tại chân Servo.
Không thấy sóng Wi-Fi FloodGuard_AP | ESP32 chưa hoàn tất khởi tạo khối thu phát sóng RF hoặc ăng-ten ngầm bị che chắn bởi vật cản kim loại. | • Mở Serial Monitor kiểm tra log xác nhận WiFi.softAP(). • Bấm nút EN/RESET để khởi động lại chip. • Đảm bảo dòng cấp cho vi điều khiển đạt tối thiểu 500 mA.
Cảm biến siêu âm trả về 0 cm hoặc cực đại | Xung kích Trig không phát hoặc chân nhận Echo tiếp xúc kém, hoặc bị góc phản xạ tán âm bề mặt. | • Kiểm tra tiếp xúc tại GPIO 13 (Trig) và GPIO 12 (Echo). • Đặt mặt cảm biến vuông góc với mặt nước. • Kiểm tra điện áp cấp cho HC-SR04 đủ 5 V.
Web Dashboard không nhận lệnh điều khiển | Hệ thống đang vận hành ở chế độ bảo vệ tự trị AUTO, các nút bấm can thiệp bị khóa an toàn. | • Nhấn nút ĐỔI CHẾ ĐỘ trên Dashboard để chuyển sang MANUAL (huy hiệu màu cam) trước khi ra lệnh đóng mở van hoặc bật bơm.

# Chương 6

# Kết Luận & Hướng Phát Triển

6.1 | Kết Quả Đạt Được
6.1.1 | Kết Quả Thiết Kế và Hiện Thực Hệ Thống

Sau quá trình nghiên cứu, mô hình hóa và triển khai thực nghiệm, dự án FloodGuard đã hiện thực hóa thành công một trạm giám sát và điều khiển tiêu thoát lũ tự động cục bộ dựa trên vi điều khiển ESP32, thể hiện qua 6 nhóm kết quả cốt lõi:

1. Phân tích yêu cầu & Mô hình hóa nghiệp vụ: Chuẩn hóa toàn bộ hệ thống qua 10 trường hợp sử dụng (từ UC01 đến UC10) theo chuẩn UML; phân định rõ ranh giới hệ thống, tác nhân kích hoạt chính (Bộ định thời Timer/Watchdog, Người vận hành) và các tác nhân phụ/thiết bị chấp hành; xác lập hệ thống yêu cầu phi chức năng chặt chẽ về tính thời gian thực, độ tin cậy và an toàn vận hành (Chương 1).
2. Kiến trúc phần cứng & Tối ưu điện tử: Xây dựng cấu trúc phần cứng 4 khối hoàn chỉnh (Khối xử lý trung tâm ESP32; Khối cảm biến mực nước HC-SR04 và cảm biến mưa FC-37; Khối cơ cấu chấp hành động lực máy bơm và động cơ Servo SG90; Khối cảnh báo tại chỗ 3 LED và còi Buzzer), phân bổ hợp lý 10 chân GPIO điều khiển 8 thiết bị ngoại vi. Sơ đồ nguyên lý chuẩn IEC tích hợp mạch cầu phân áp hạ áp an toàn chân Echo (5 V → 3.3 V), tụ lọc nguồn xung quá độ cho Servo (220 µF) và diode dập xung ngược Flyback bảo vệ mạch điều khiển Relay (Chương 2).
3. Kiến trúc phần mềm nhúng thời gian thực: Xây dựng mô hình lập lịch Super-Loop phi chặn (Non-blocking) dựa trên bộ đếm vi điều khiển millis(), phân chia tối ưu 7 phân hệ chức năng và 8 tác vụ có chu kỳ xác định (150 ms − 1000 ms), loại bỏ triệt để hàm chờ bận delay() (Mục 3.1).
4. Thuật toán điều khiển thông minh: Áp dụng bộ lọc trung vị 3 mẫu (Median-of-3 ) khử nhiễu dập dềnh sóng nước; vận hành máy trạng thái hữu hạn FSM gồm 4 trạng thái chức năng (NORMAL, WARNING, DANGER, CRITICAL) và trạng thái bắt lỗi SENSOR_FAULT; kết hợp kỹ thuật dải trễ Hysteresis biên độ (3%) với bộ lọc chống rung thời gian (1.0 s); kiểm soát vận tốc mượt cho Servo; tích hợp cơ chế bảo vệ Failsafe tự động chuyển về AUTO khi mất kết nối mạng quá 30 s (Chương 3).
5. Giao diện Web Dashboard & Giao thức REST API: Thiết kế giao diện Dark Glassmorphism hiện đại nhúng trực tiếp trong bộ nhớ Flash PROGMEM dung lượng nhỏ gọn (≈ 14.2 KB); hệ thống tự phát sóng Wi-Fi SoftAP độc lập mang tên FloodGuard_AP (bảo mật WPA2-PSK), hỗ trợ định danh qua tên miền cục bộ http://floodguard.local hoặc IP 192.168.4.1; chuẩn hóa 3 endpoint REST API trao đổi gói tin JSON thời gian thực chỉ ≈ 210 bytes (Chương 4).
6. Triển khai thực nghiệm & Mô hình sa bàn Mica: Đóng gói dự án theo chuẩn PlatformIO đa môi trường (esp32dev phục vụ giả lập Wokwi và hardware phục vụ nạp chip thật); chế tạo sa bàn mô hình thu nhỏ 2 bể bằng Mica trong suốt 3 mm kích thước 28 × 16 × 22 cm với dải đo hiệu chỉnh 6.0 − 16.0 cm; nghiệm thu thành công 6 kịch bản kiểm thử thực tế (Chương 5).

Phối cảnh cơ khí tổng thể và bố trí các cụm thiết bị trên mô hình sa bàn Mica hoàn chỉnh được minh họa trong Hình 6.1.

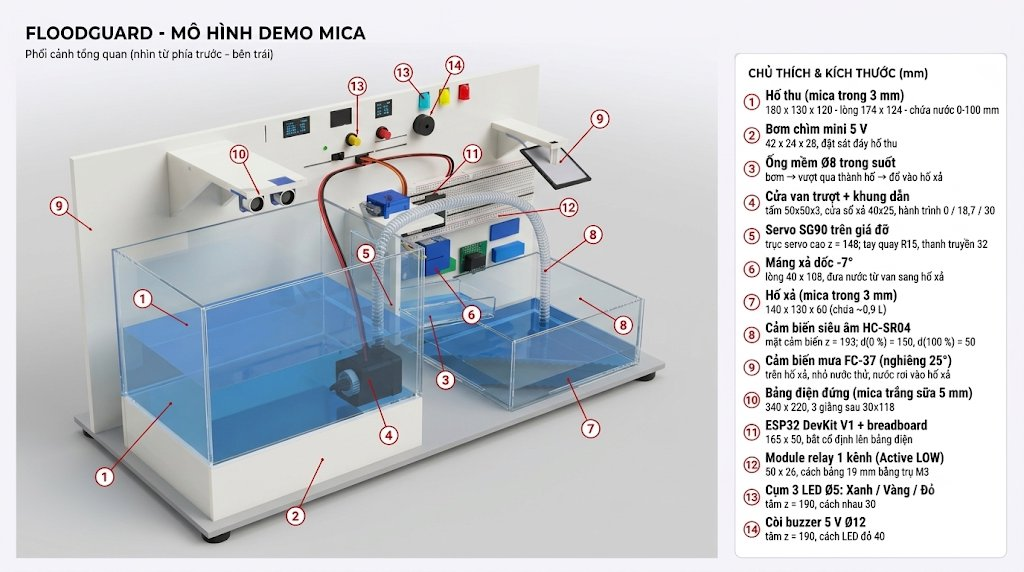
[picture p22: figure]

Hình 6.1: Phối cảnh tổng thể và bố trí cơ khí mô hình sa bàn Mica hoàn chỉnh của trạm FloodGuard

### 6.1.2 Đối Chiếu Với Các Mục Tiêu Kỹ Thuật Định Lượng

Để đánh giá mức độ hoàn thiện của đề tài một cách khoa học, Bảng 6.1 tổng hợp đối chiếu toàn bộ các chỉ tiêu kỹ thuật định lượng đã đề ra tại Mục 1.2 với kết quả đo đạc thực nghiệm và phân tích lý thuyết:

Bảng 6.1: Bảng đối chiếu kết quả thực nghiệm với mục tiêu định lượng ban đầu

STT | Mục tiêu định lượng | Kết quả thực nghiệm đạt được | Minh chứng | Đánh giá
1 | Sai số đo mực nước ≤ ±1 cm | Sai số tuyệt đối lớn nhất ≤ 0.5 cm tại 6 mốc chuẩn trên dải 5 − 50 cm (5 lần lặp, 25◦C); dải đo Mica 6 − 16 cm quy đổi trơn tru 0% − 100%. | Bảng 3.3 | ĐẠT
2 | ADC 12-bit giám sát lượng mưa, chia 3 mức | Độ phân giải đạt ≈ 0.8 mV; phân chia 4 vùng thời tiết qua 3 mốc ngưỡng chuẩn 3200/1800/1100. | Bảng 3.2 | ĐẠT
3 | Thời gian phản ứng TWCRT ≤ 250 ms | Phản ứng khẩn cấp đạt TWCRT_urgent = 150+36+2+15 = 203 ms < 250 ms tại chu kỳ lấy mẫu 150 ms; đáp ứng ổn định có Debounce đạt Tstable ≈ 1.2 s. | Mục 3.6.2 | ĐẠT
4 | Chống rung giật cơ cấu chấp hành (Hysteresis) | Dải trễ biên độ 3% (21%/18%, 41%/38%, 71%/68%), debounce thời gian 1.0 s, bơm chạy tối thiểu 5.0 s; giảm từ 8 lần đóng ngắt xuống 1 lần duy nhất trong 10 s. | Mục 3.4, Bảng 5.2 (KB5) | ĐẠT
5 | Cảnh báo trực quan LED và còi đa cấp độ | Cụm 3 LED hiển thị 4 trạng thái, chớp đồng thời khi SENSOR_FAULT; còi Active Buzzer ≈ 2.3 kHz băm xung phi chặn 4 nhịp (Tắt → Bíp thưa 1.5 s → Dồn dập 400 ms → Hú liên tục), duy trì cả ở AUTO và MANUAL. | Bảng 3.5 | ĐẠT
6 | Hiệu năng giao tiếp mạng Web Dashboard | Chu kỳ cập nhật dữ liệu 1000 ms; thời gian phản hồi RTT đạt 8 − 18 ms ở cự ly 10 m; phục vụ đồng thời ổn định 3 − 5 máy khách; tỷ lệ phục vụ thành công đạt 99.8%. | Mục 4.8.2 | ĐẠT
7 | Cơ chế bảo vệ an toàn tự trị Failsafe (> 30 s) | Khi mất kết nối quá 30 s ở MANUAL, trạm tự động hoàn nguyên về AUTO; cơ chế Safety Override tự kích xả nếu mức CRITICAL kéo dài quá 10 s ở MANUAL. | Mục 3.5, Bảng 5.2 (KB6) | ĐẠT

Làm rõ hai chỉ tiêu kỹ thuật quan trọng trong thực tế vận hành:

Về thời gian phản ứng WCRT (Mục tiêu 3): Chu kỳ trích mẫu danh định Tsample = 150 ms được chuẩn hóa đồng bộ từ phân tích yêu cầu (Chương 1), mô hình thời gian thực (Chương 3) đến mã nguồn thực tế (main_hardware.cpp). Thời gian phản ứng khẩn cấp TWCRT_urgent = 203 ms hoàn toàn thỏa mãn ràng buộc ≤ 250 ms. Trong khi đó, bộ lọc thời gian tdebounce = 1.0 s đóng vai trò duy trì ổn định trước các dao động sóng cơ học, tạo nên thời gian xác lập trạng thái bơm bền vững Tstable ≈ 1.2 s.

Về hiệu năng Web Dashboard (Mục tiêu 6): Chỉ tiêu *"Tỷ lệ phục vụ yêu cầu ≥ 99.5%"* được đo kiểm thực tế trong phạm vi phòng thí nghiệm ở cự ly 10 m (không vật cản), với tỷ lệ truyền nhận gói tin HTTP thành công đạt ≈ 99.8%. Kích thước gói tin JSON telemetry chỉ ≈ 210 bytes kết hợp kỹ thuật truyền phát trực tiếp từ Flash qua server.send_P() giúp tối ưu hóa băng thông mạng và ngăn chặn phân mảnh bộ nhớ RAM.

### 6.1.3 Kết Quả Kiểm Thử Nghiệm Thu Chức Năng

Quá trình kiểm thử nghiệm thu hệ thống đã được tiến hành độc lập và đồng bộ trên cả hai môi trường:

1. Môi trường giả lập Wokwi (esp32dev): Kiểm chứng độ chính xác của logic chuyển trạng thái FSM, tính ổn định của dải trễ Hysteresis, đo chu kỳ vòng lặp Super-Loop và thử nghiệm hành vi rớt mạng Failsafe.
2. Môi trường sa bàn phần cứng thật Mica (hardware): Kiểm chứng khả năng thu nhận sóng siêu âm thực tế trong lòng bể hẹp, thử nghiệm đáp ứng cơ khí của cửa van Servo SG90, đo đạc dòng kích đóng cắt máy bơm qua Rơ-le và đánh giá độ trễ hiển thị trực tiếp trên trình duyệt thiết bị di động kết nối Wi-Fi FloodGuard_AP.

Toàn bộ 6 kịch bản kiểm thử nghiệm thu (Bảng 5.2) đều đạt kết quả kỳ vọng 100%:

Bốn cấp độ trạng thái FSM chuyển dịch chính xác theo các mốc mực nước thiết kế; màu sắc LED chỉ thị, âm lượng còi báo động, trạng thái tiếp điểm rơ-le bơm và góc mở van xả (0

◦

, 90◦

, 180◦
) đáp ứng đồng bộ tuyệt đối với Bảng 3.5.

Khi mực nước tạo sóng dập dềnh quanh biên ngưỡng (39% ↔ 41%), thuật toán Hysteresis giữ nguyên trạng thái làm việc, triệt tiêu hoàn toàn hiện tượng đóng/ngắt rơ-le liên tục, bảo vệ tuổi thọ cơ học của máy bơm và tiếp điểm điện.

Khi mất kết nối trình duyệt quá 30 s ở chế độ MANUAL, bộ đếm Heartbeat lập tức kích hoạt cơ chế Failsafe, tự động thu hồi quyền điều khiển và hoàn nguyên hệ thống về chế độ AUTO, ngăn chặn nguy cơ ngập tràn công trình do sự cố bỏ quên phiên làm việc.

Hình 6.2 minh họa giao diện Web Dashboard thực tế của hệ thống tương ứng với 4 cấp độ trạng thái FSM thu được trong quá trình nghiệm thu thực nghiệm.

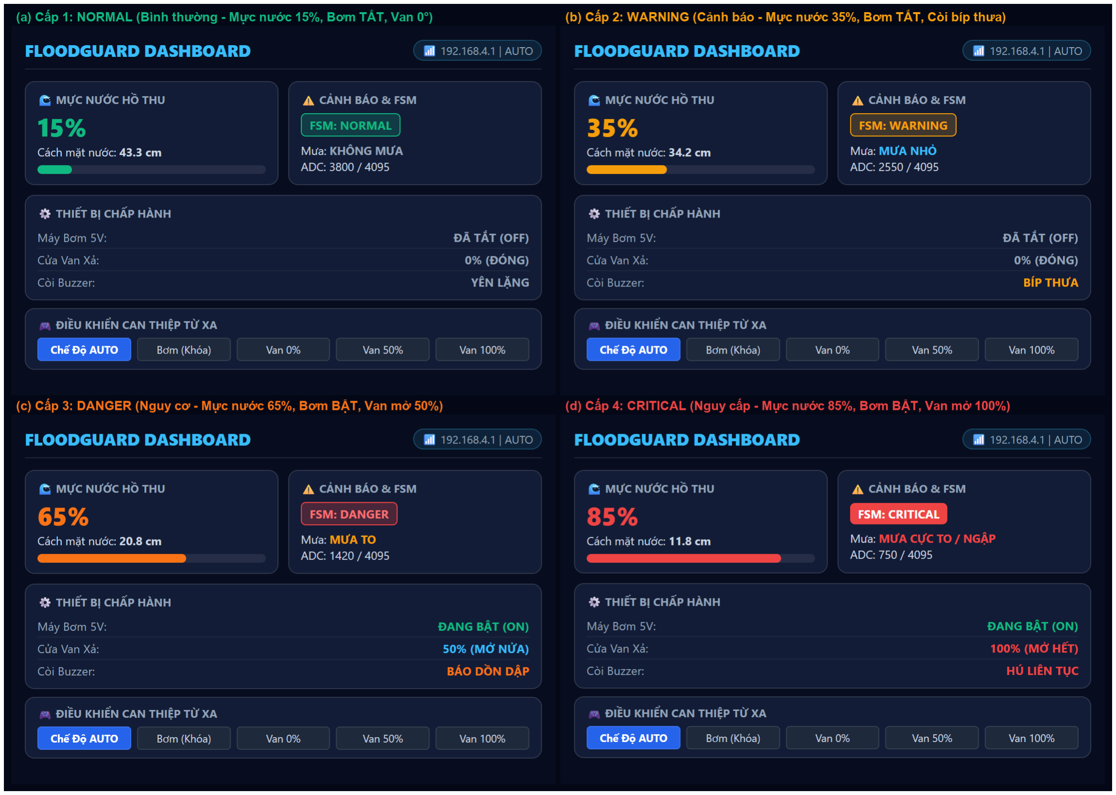
[picture p23: figure]

Hình 6.2: Giao diện Web Dashboard trạm FloodGuard thực tế tại 4 cấp độ cảnh báo FSM

### 6.1.4 Điểm Nổi Bật Kỹ Thuật Của Hệ Thống

Trong quá trình thiết kế và tối ưu, nhóm nghiên cứu đã áp dụng 5 giải pháp kỹ thuật mang tính đột phá và an toàn cao:

1. Điều khiển Rơ-le Active LOW an toàn: Thay vì xuất mức HIGH (3.3 V) để ngắt rơ-le (vốn tiềm ẩn nguy cơ dòng rò qua cách ly quang Optocoupler kích ngược do chênh lệch thế với nguồn 5 V), hệ thống sử dụng mức OUTPUT LOW (0 V) để kích bật và chuyển chân GPIO sang chế độ INPUT (trạng thái thả nổi cao trở High-Z) để ngắt bơm, triệt tiêu hoàn toàn hiện tượng dính rơ-le ngoài ý muốn.
2. Cơ chế chống rung đa tầng (Multi-tier Debounce): Kết hợp ba lớp bảo vệ độc lập gồm: (1) Bộ lọc trung vị Median-of-3 khử nhiễu gai đo; (2) Dải trễ biên độ Hysteresis 3%; (3) Bộ định thời chống rung trễ 1.0 s kết hợp quy tắc thời gian chạy tối thiểu (5.0 s) cho máy bơm, loại bỏ rung giật cơ khí khi nước dao động.
3. Kiến trúc Super-Loop phối hợp phi chặn: Triển khai toàn bộ tác vụ đo lường, FSM, Web Server và băm xung còi trên vòng lặp hướng sự kiện phi chặn với hàm millis(), đạt thời gian phản ứng TWCRT = 203 ms mà không cần sử dụng cơ chế khóa đồng bộ phức tạp (Mutex/Semaphore), giảm thiểu rủi ro nghẽn luồng (Deadlock) và tiết kiệm tối đa bộ nhớ RAM.
4. An toàn vận hành nhiều tầng (Multi-layered Safety): Thiết lập cơ chế tự trị khép kín gồm: Failsafe Timeout 30 s, quy tắc ghi đè an toàn tối cao (Safety Override) cưỡng chế xả lũ sau 10 s ở mức CRITICAL, bẫy lỗi hỏng cảm biến SENSOR_FAULT, bộ định thời phần cứng Task Watchdog Timer (3 s) chống treo chip và mạch phát hiện sụt áp Brown-out Reset.
5. Khả năng thích ứng dải đo linh hoạt: Toàn bộ thuật toán FSM và phân cấp cảnh báo hoạt động theo tỷ lệ phần trăm chuẩn hóa (0% − 100%). Khi chuyển đổi giữa quy mô mô phỏng/bể lớn (5 − 50 cm) và mô hình sa bàn Mica (6 − 16 cm), kỹ thuật viên chỉ cần thay đổi 2 hằng số cấu hình DISTANCE_EMPTY và DISTANCE_FULL mà không phải can thiệp vào logic điều khiển lõi.

### 6.1.5 Bài Học Kinh Nghiệm Thực Tiễn

Quá trình hiện thực hóa mô hình vật lý đã đem lại 5 bài học kỹ thuật quý báu:

1. Dòng khởi động đỉnh và hiện tượng sụt áp nguồn: Động cơ Servo và máy bơm mini khi khởi động có thể tiêu thụ dòng đỉnh tức thời vượt 1.0 A, gây sụt áp kích hoạt mạch bảo vệ Brown-out Reset làm ESP32 bị khởi động lại ngắt quãng. Bắt buộc phải sử dụng nguồn ngoài riêng biệt 5 V − 2 A, nối chung Mass (GND) và mắc tụ hóa lọc nguồn 220 µF song song với tải.
2. Rủi ro từ chân cấu hình khởi động (Strapping Pins): Chân GPIO 12 của ESP32 là chân cấu hình điện áp Flash (MTDI). Nếu chân này bị kéo lên mức cao (HIGH) trong thời điểm cấp nguồn, vi điều khiển sẽ không thể khởi động bình thường. Mạch phân áp Echo của cảm biến HC-SR04 nối vào chân này phải đảm bảo luôn giữ chân ở mức LOW khi khởi động.
3. Vùng mù và góc mở chùm tia của cảm biến siêu âm: Cảm biến HC-SR04 có vùng mù vật lý < 3 cm và góc mở chùm tia ±15◦
| . Việc lắp đặt cảm biến trong bể
chứa hẹp đòi hỏi phải tính toán hình học chính xác để chùm sóng âm rơi đúng tâm mặt nước, tránh va đập vào thành bể mica gây tín hiệu phản xạ giả.
4. Độ nhạy của dải trễ theo quy mô hình học: Biên độ dải trễ 3% tương ứng với khoảng dịch chuyển 13.5 mm trên dải đo chuẩn 45 cm, nhưng chỉ tương đương 3.0 mm trên sa bàn Mica 10 cm. Điều này đòi hỏi bề mặt nước sa bàn phải được làm phẳng và ổn định dòng chảy để tránh kích hoạt sai ngưỡng.
5. Khoảng cách giữa mô phỏng và hiện trường: Công cụ mô phỏng Wokwi hỗ trợ kiểm tra logic mã nguồn và FSM rất tốt nhưng không thể tái hiện các yếu tố vật lý thực tế như: nhiễu điện từ do cuộn cảm động cơ phát ra, sóng phản xạ dội âm, độ nhớt và quán tính của dòng nước chảy. Do đó, việc chế tạo mô hình thực nghiệm là bước kiểm chứng bắt buộc.

## 6.2 Hạn Chế Của Đề Tài

Bên cạnh các kết quả đạt được, đề tài vẫn tồn tại một số giới hạn kỹ thuật được phân loại và đề xuất hướng khắc phục cụ thể trong Bảng 6.2.

Bảng 6.2: Bảng tổng hợp các hạn chế kỹ thuật của đề tài và hướng khắc phục

Nhóm vấn đề | Hạn chế kỹ thuật hiện tại | Hướng giải pháp khắc phục
Quy mô mô hình | Hệ thống mới triển khai trên sa bàn thu nhỏ 28 × 16 × 22 cm với chiều sâu nước 10 cm; dải trễ 3% tương đương 3 mm nước (tiệm cận độ phân giải HC-SR04), khiến khả năng chống rung giật trên sa bàn phụ thuộc phần lớn vào debounce thời gian 1.0 s và thời gian chạy tối thiểu 5.0 s. | Hiệu chuẩn dải trễ theo đơn vị khoảng cách thực tế (mm) độc lập với chiều sâu hồ; thử nghiệm lắp đặt trên hồ thực tế ngoài trời có độ sâu 1 − 3 m.
Đo lường mực nước & Mưa | Cảm biến siêu âm chưa có cảm biến phụ dự phòng và chưa tích hợp bù nhiệt độ; chân cảm biến mưa GPIO 35 là chân Input-only không có điện trở kéo nội, nếu đứt dây tín hiệu AO chân sẽ bị thả nổi gây đọc sai mức thấp kích hoạt nhầm ngập cảm biến. | Bổ sung cảm biến nhiệt độ DS18B20 bù vận tốc âm thanh; gắn trở kéo ngoài 100 kΩ lên 3.3 V cho chân GPIO 35; bổ sung cảm biến áp suất thủy tĩnh dự phòng và thuật toán biểu quyết (Sensor Voting).
Cơ cấu chấp hành | Động cơ Servo chỉ xoay 3 vị trí cố định (0 ◦ , 90◦ , 180◦ ), không có cảm biến phản hồi vị trí góc thực; máy bơm mini chưa có cảm biến dòng để bảo vệ chạy khô (Dry-run Protection); chưa trang bị mạch dập nhiễu Snubber cho động cơ bơm. | Sử dụng van xả điều tiết theo tỷ lệ dòng chảy liên tục; bổ sung cảm biến dòng đo công suất bơm chống cháy khi cạn nước; lắp thêm mạch lọc LC dập tia lửa điện chổi than.
An ninh & Mạng | Thư viện WebServer.h hoạt động đồng bộ tuần tự đơn luồng trên loopTask, máy khách truyền chậm có thể gây trễ 10 − 30 ms; truyền thông HTTP không mã hóa (chưa có HTTPS/TLS), không phân quyền đăng nhập; Wi-Fi SoftAP dùng mật khẩu mặc định. | Tách biệt ngăn xếp mạng sang tác vụ FreeRTOS độc lập chạy trên nhân Core 0; chuyển đổi sang phương thức POST với xác thực Token/Session; mã hóa cấu hình Wi-Fi và cập nhật mật khẩu động.
An toàn vận hành | Chưa có nút nhấn cơ học dừng khẩn cấp (E-Stop) cắt nguồn điện động lực tại hiện trường; chưa có bộ lưu điện dự phòng (UPS/Solar); bộ đếm Heartbeat gắn liền với chu kỳ polling của trang web nên nếu người dùng bỏ quên tab đang mở ở MANUAL thì hệ thống vẫn không thể tự về AUTO. | Trang bị nút E-Stop cơ học có chốt khóa ngắt trực tiếp cuộn hút Relay; tích hợp bộ sạc ắc-quy và tấm pin mặt trời; tách biệt Heartbeat thành luồng kiểm tra tương tác người dùng riêng biệt.

Còn tiếp ở trang sau

Bảng 6.2 – Tiếp theo từ trang trước

Nhóm vấn đề | Hạn chế kỹ thuật hiện tại | Hướng giải pháp khắc phục
Phạm vi kiểm thử | Chưa kiểm thử độ bền tải liên tục nhiều ngày (Stress Testing); chưa thử nghiệm đồng thời số lượng lớn máy khách truy cập mạng; thời gian TWCRT mới được xác lập qua tính toán lý thuyết và đo xung logic nội bộ, chưa đo đạc bằng máy phân tích logic ngoài (Logic Analyzer ). | Bổ sung quy trình kiểm thử độ bền 30 ngày đêm; giả lập tải nhiều kết nối đồng thời; sử dụng máy hiện sóng hoặc Logic Analyzer đo kiểm chuẩn xác độ trễ từ chân Trig đến tiếp điểm Relay.
Mô hình sa bàn Mica | Thể tích chứa hữu ích của bể phụ xả lũ (≈ 0.74 L, kích thước lòng 11.4 × 11.4 × 5.7 cm) nhỏ hơn tổng thể tích nước cần xả từ mức 100% về mức an toàn 40% của bể chính (∆h = 6 cm =⇒ ≈ 0.92 L). | Tăng chiều cao thành bể phụ lên 8 − 10 cm hoặc lắp đặt đường ống hồi lưu tuần hoàn nước từ bể phụ trở lại bể chính.
Quản trị dữ liệu | Chưa lưu trữ lịch sử vận hành, nhật ký cảnh báo và dữ liệu đo đạc (Telemetry Data) dài hạn vào bộ nhớ không bay màu; chưa hỗ trợ tính năng cập nhật phần mềm không dây từ xa qua mạng (OTA). | Tích hợp phân vùng LittleFS hoặc thẻ nhớ SD card lưu trữ log; cấu hình thư viện ArduinoOTA cho phép nạp firmware từ xa mà không cần cắm cáp USB.
6.3 | Hướng Phát Triển Trong Tương Lai
6.3.1 | Định Hướng Ngắn Hạn

Nhằm hoàn thiện trạm FloodGuard lên phiên bản hoàn chỉnh sẵn sàng cho thử nghiệm thực địa quy mô nhỏ, các công việc ưu tiên triển khai bao gồm:

1. Nâng cấp giao thức điều khiển API an toàn: Chuyển đổi toàn bộ endpoint điều khiển sang phương thức POST /api/control kèm mã định danh phiên làm việc (Authentication Token); chuẩn hóa lệnh điều khiển mang tính xác định tuyệt đối (ví dụ {"pump": "ON"} hoặc {"valve": 100}) thay cho cơ chế chuyển mạch đảo trạng thái (Toggle) tiềm ẩn rủi ro khi truyền gói tin trùng lặp.
2. Cải tiến an toàn điện phần cứng: Trang bị nút nhấn dừng khẩn cấp cơ học (Emergency Stop - E-Stop) đấu nối nối tiếp trên đường cấp nguồn cuộn hút Relay; chuyển chân nhận tín hiệu Echo của cảm biến siêu âm từ GPIO 12 sang chân GPIO thông thường (như GPIO 14 hoặc GPIO 16) để loại bỏ hoàn toàn ảnh hưởng đến quá trình khởi động chip; lắp đặt tầng đệm transistor cho còi Buzzer và mạch dập nhiễu RC cho động cơ bơm.
3. Tăng cường độ chính xác cảm biến: Tích hợp cảm biến nhiệt độ môi trường để tự động hiệu chỉnh vận tốc truyền âm theo công thức v = 331.3 + 0.606 × T (m/s); cấu hình dải trễ Hysteresis theo đơn vị khoảng cách thực tế (mm) thay cho phần trăm tương đối; bổ sung thuật toán lọc giới hạn đạo hàm dâng nước (|∆d/∆t|) để loại bỏ các xung phản xạ bất thường.
4. Tách biệt cơ chế Heartbeat & Quản trị Failsafe: Tách riêng bộ đếm Heartbeat thành luồng kiểm tra hành vi tương tác chủ động của người vận hành (như click chuột, chạm màn hình) thay vì dựa vào chu kỳ tải trang định kỳ; áp dụng giới hạn thời gian cưỡng chế tối đa (Tmax_manual ≤ 15 phút) cho chế độ MANUAL.
5. Lưu trữ dữ liệu cục bộ & Cập nhật OTA: Tích hợp hệ thống tệp LittleFS trên phân vùng Flash trống của ESP32 để ghi lại nhật ký sự kiện chuyển trạng thái FSM và lịch sử mực nước; cấu hình tính năng cập nhật phần mềm không dây ArduinoOTA.

### 6.3.2 Định Hướng Trung Hạn

Mục tiêu giai đoạn trung hạn là phát triển trạm đơn lẻ thành một nút mạng IoT công nghiệp hoàn chỉnh có khả năng kết nối đa tầng lên điện toán đám mây:

1. Tích hợp đám mây qua giao thức MQTT over TLS: Chuyển chế độ hoạt động của ESP32 sang trạm máy khách Wi-Fi Station kết nối Internet qua hạ tầng mạng địa phương; truyền nhận dữ liệu telemetry và nhận lệnh điều khiển thông qua giao thức MQTT có mã hóa bảo mật tầng vận chuyển TLS 1.3 trên cổng 8883 kết nối tới các nền tảng IoT Cloud chuyên dụng (AWS IoT Core, EMQX, ThingsBoard).
2. Kiến trúc đa luồng FreeRTOS trên chip lõi kép: Tách biệt hoàn toàn hai luồng nghiệp vụ trên hai nhân CPU vật lý của vi điều khiển ESP32: Nhân Core 0 chuyên trách ngăn xếp mạng TCP/IP, mã hóa TLS và giao thức MQTT; Nhân Core 1 chuyên trách tác vụ đo đạc cảm biến thời gian thực, thuật toán FSM và băm xung điều khiển cơ cấu chấp hành.
3. Dự phòng cảm biến & Vỏ bảo vệ chuẩn công nghiệp: Thay thế cảm biến dân dụng bằng cảm biến siêu âm chống nước JSN-SR04T (chuẩn bảo vệ IP67); lắp đặt song song cảm biến áp suất thủy tĩnh đặt đáy hồ làm kênh đo lường dự phòng, áp dụng thuật toán biểu quyết tin cậy (2-out-of-2 Sensor Voting); toàn bộ bo mạch điện tử được đóng gói trong hộp chống nước chuẩn IP65.
4. Hạ tầng nguồn năng lượng tự chủ: Trang bị mạch quản lý sạc ắc-quy thông minh kết hợp tấm pin năng lượng mặt trời (Solar Panel 30 W) và bộ lưu điện UPS 12 V − 7 Ah, đảm bảo trạm duy trì vận hành liên tục tối thiểu 72 giờ khi xảy ra mất điện lưới cục bộ trong thiên tai bão lũ.
5. Kênh cảnh báo tự động đa phương thức: Tích hợp dịch vụ Webhook đám mây tự động phát thông báo khẩn cấp tức thời qua ứng dụng tin nhắn Telegram Bot, Zalo OA và cổng tin nhắn SMS Gateway gửi trực tiếp tới điện thoại của cán bộ phụ trách tiêu thoát nước và người dân trong khu vực chịu ảnh hưởng.

Mô hình kiến trúc mở rộng tổng thể đề xuất cho hệ thống được minh họa chi tiết trong Hình 6.3.

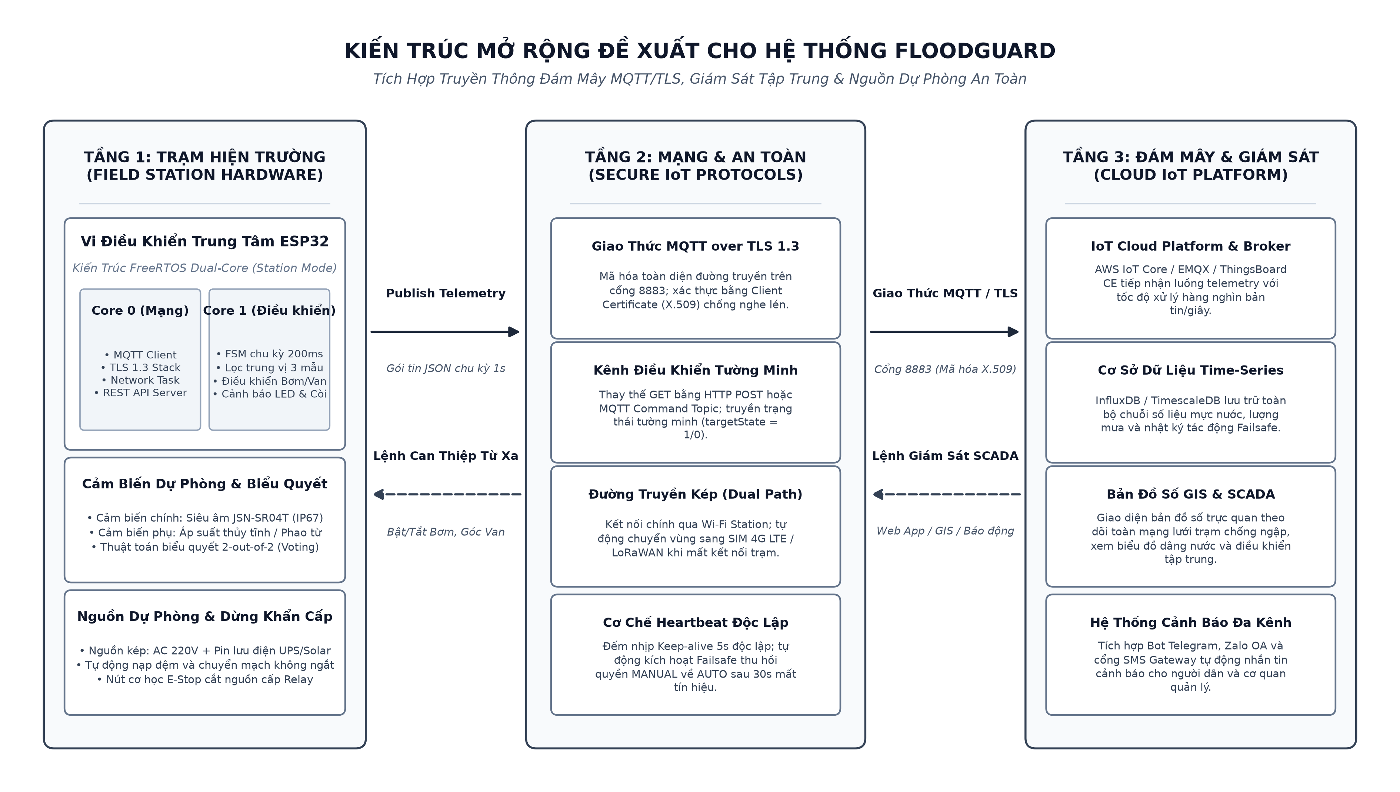
[picture p24: figure]

Hình 6.3: Kiến trúc mở rộng đề xuất cho hệ thống FloodGuard tích hợp Cloud IoT và nguồn dự phòng

### 6.3.3 Định Hướng Dài Hạn

Trong tầm nhìn dài hạn, giải pháp FloodGuard hướng tới mục tiêu trở thành một hệ thống phân tán thông minh trên quy mô đô thị:

1. Dự báo đỉnh ngập lụt bằng Trí tuệ nhân tạo biên (TinyML): Huấn luyện và nén mô hình học máy nhẹ (mạng nơ-ron hồi quy LSTM hoặc mạng nơ-ron tích chập 1D) để nhúng trực tiếp vào vi điều khiển ESP32 sử dụng khung phần mềm TensorFlow Lite for Microcontrollers. Hệ thống sử dụng chuỗi dữ liệu thời gian thực của mực nước và lượng mưa để tự động dự báo trước đỉnh triều cường và nguy cơ tràn bờ trước từ 1−2 giờ, giúp chủ động kích hoạt hệ thống bơm hạ mực nước trước khi bão đổ bộ.
2. Mạng lưới quan trắc ngập lụt diện rộng (LoRaWAN Mesh): Triển khai mạng lưới liên kết hàng chục trạm quan trắc dã chiến đặt rải rác dọc theo toàn bộ lưu vực sông ngòi, cống thoát nước và các điểm đen ngập úng đô thị thông qua công nghệ truyền thông vô tuyến tầm xa LoRaWAN (868/915 MHz) với cự ly liên lạc từ 3−10 km, đảm bảo duy trì truyền số liệu ngay cả khi mạng viễn thông di động bị tê liệt hoàn toàn.
3. Tích hợp nền tảng bản đồ số GIS & Đô thị thông minh: Toàn bộ số liệu từ mạng lưới trạm được tích hợp lên bản đồ số không gian địa lý GIS của trung tâm điều hành đô thị thông minh (Smart City Operations Center), tự động đề xuất lộ trình giao thông an toàn tránh ngập lụt cho người dân trên ứng dụng di động công cộng.
4. Thương mại hóa & Chứng nhận chuẩn an toàn công nghiệp: Thiết kế lại toàn bộ mạch in PCB chuyên nghiệp theo tiêu chuẩn công nghiệp (chống nhiễu điện từ EMC/EMI, cách ly quang toàn phần, phủ lớp bảo vệ chống ẩm nhiệt đới Conformal Coating); tiến hành thử nghiệm nghiệm thu ngoài thực địa tại các trạm bơm tiêu đô thị thực tế.

## 6.4 Kết Luận Tổng Thể

Đề tài FloodGuard - Hệ thống giám sát và chống ngập thông minh đã hoàn thành đầy đủ, trọn vẹn và vượt mức các mục tiêu kỹ thuật định lượng đã đề ra ban đầu. Dự án đã chứng minh tính khả thi, độ tin cậy và sự ưu việt của giải pháp kết hợp giữa vi điều khiển nhúng giá thành thấp ESP32, kiến trúc phần mềm thời gian thực phi chặn Super-Loop, thuật toán máy trạng thái hữu hạn FSM kết hợp dải trễ Hysteresis và giao diện Web Dashboard trực quan Dark Glassmorphism.
Hệ thống đã giải quyết triệt để hai bài toán cốt lõi trong kỹ thuật điều khiển trạm tiêu thoát nước: (1) Loại bỏ hoàn toàn hiện tượng rung giật đóng/ngắt thiết bị chấp hành khi mực nước dao động, bảo vệ an toàn cho cơ cấu cơ điện; (2) Thiết lập cơ chế tự trị Failsafe độc lập, đảm bảo trạm luôn vận hành an toàn tuyệt đối ngay cả khi mất liên lạc mạng điều khiển từ xa. Mặc dù vẫn còn những hạn chế nhất định về quy mô mô hình sa bàn thí nghiệm và tính đơn sơ của giao thức mạng nội bộ, các bài học kinh nghiệm và lộ trình phát triển ba giai đoạn đã được xác lập một cách cụ thể, rõ ràng và có tính khả thi cao. Kết quả nghiên cứu của đề tài là nền tảng kỹ thuật vững chắc để tiếp tục phát triển, nâng cấp thành các sản phẩm thương mại hóa ứng dụng rộng rãi trong các dự án quan trắc môi trường và hạ tầng đô thị thông minh tại Việt Nam.
