vuminhquan28/FloodGuard/(commit log)

2026-10-30 Remove physical buttons from circuit
2026-10-30 Update GPIO pinout to match actual hardware wiring
2026-10-30 Standardize GPIO pin mapping to match physical wiring
2026-11-01 Apply 4 hardware fixes: High-Z relay, median filter, non-blocking, pump hysteresis
    [main.ino]
2026-11-01 Fix FSM: connect rain sensor to state machine, add debug logs
    [main.ino]
2026-11-01 Implement multi-tier rain detection: Light, Heavy, and Submerged with full actuator response
2026-11-06 Add comprehensive Use Case specifications and 11 diagrams
2026-11-06 Convert all 11 Use Case diagrams to standard black and white UML format
2026-11-06 Clarify physical-to-sensor-to-firmware interaction chains in B&W UML diagrams
2026-11-06 refactor(uml): adjust all use case diagrams to strictly treat sensors/actuators as internal system components and only environment/humans as external actors
2026-11-07 fix(uml): enforce strict UML 2.5 standards for include/extend arrows and device/human actors
    [make_diagrams_bw.py]
2026-11-07 fix(diagrams): resolve arrow overlaps, line intersections, and spacing across all UML use case diagrams
    [make_diagrams_bw.py]
2026-11-08 feat(figures): add simplified, spacious hardware GPIO circuit wiring diagram for slides
2026-11-08 docs(report): add circuit diagram and hardware wiring analysis section to chapter 2
2026-11-12 feat(report): complete Chapter 6, update IEC schematic, real dashboard UI, and final PDF
    - Authored complete Chapter 6 (Conclusion & Future Work) with quantitative target evaluation, technical highlights, limitations analysis, and roadmap
    - Added Chapter 5 (Deployment & Operation Guide) into LaTeX main document structure
    - Replaced circuit diagram with clean IEC standard industrial schematic
    - Captured and integrated real Dark Glassmorphism Web Dashboard screenshot via headless Chrome
    - Generated 3 new figures for Chapter 6: Mica 3D scale model (Fig 6.1), 4-state dashboard matrix (Fig 6.2), and 3-tier Cloud IoT architecture (Fig 6.3)
    - Updated firmware setup for ESP32Servo timer allocation a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
    [main.cpp, main.ino, main_hardware.cpp, main_wokwi.cpp, make_ch3_ch4_figures.py, make_circuit_diagram.py]
2026-11-13 fix(report & firmware): unify thresholds, timing, rain sensing, and fault matrix; recompile PDF
    [main_hardware.cpp, main_wokwi.cpp]
2026-11-13 Update Figure 2.1 circuit diagram with IEC actuator partitioning and PC interactions
2026-11-14 Redesign overall UC diagram (Fig 1.1), add overall model spec (Tab 1.1), and embed individual UC specifications into section 1.3.3
    [make_diagrams_bw.py]
